oktntko/curcur40/docs/assets/inertia_wheel_height_comparison.png

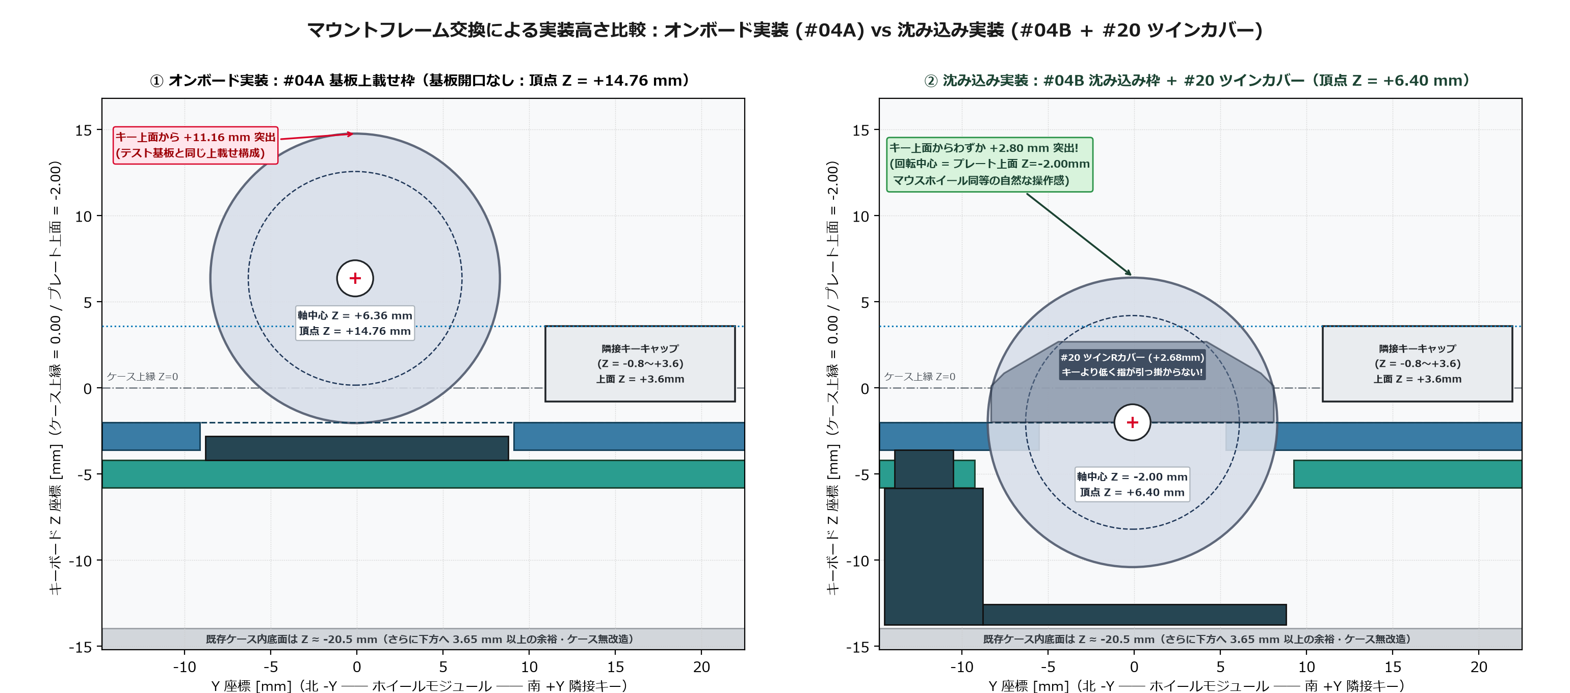
docs/assets/inertia_wheel_height_comparison.png
