oktntko/curcur40/docs/assets/render_carrying_frame_iso.png

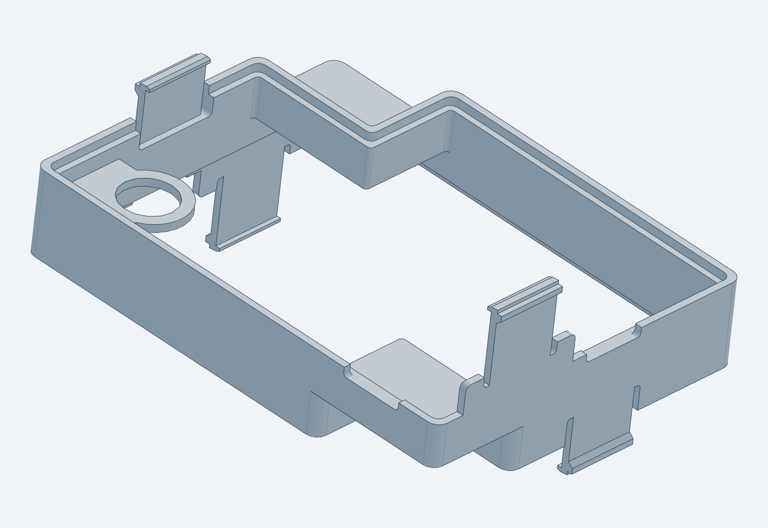
docs/assets/render_carrying_frame_iso.png
