oktntko/curcur40/docs/assets/render_curcur40_right_inertia_wheel.png

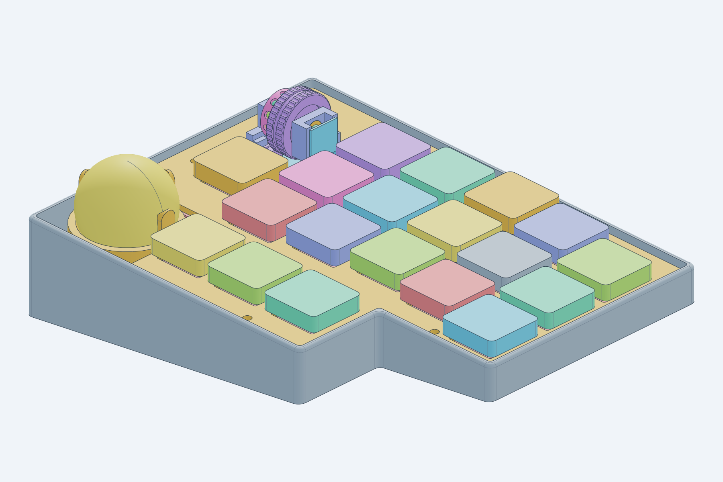
docs/assets/render_curcur40_right_inertia_wheel.png
