oktntko/curcur40/docs/assets/render_inertia_wheel_eval_pod_covered.png

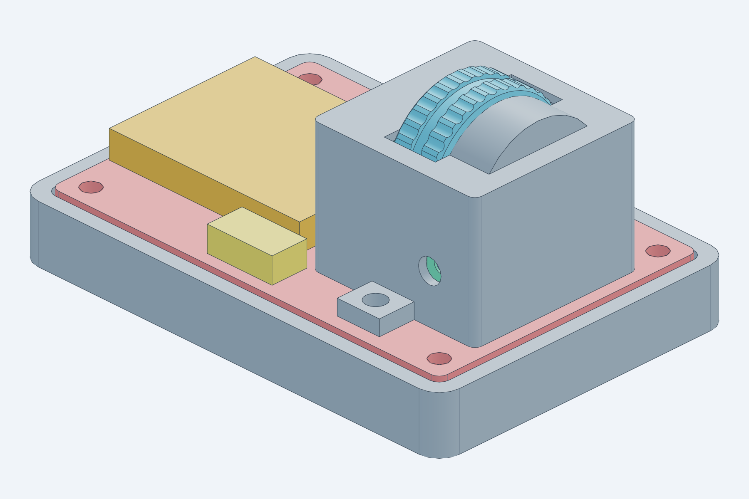
docs/assets/render_inertia_wheel_eval_pod_covered.png
