oktntko/curcur40/docs/assets/render_pcb_wheel_eval.png

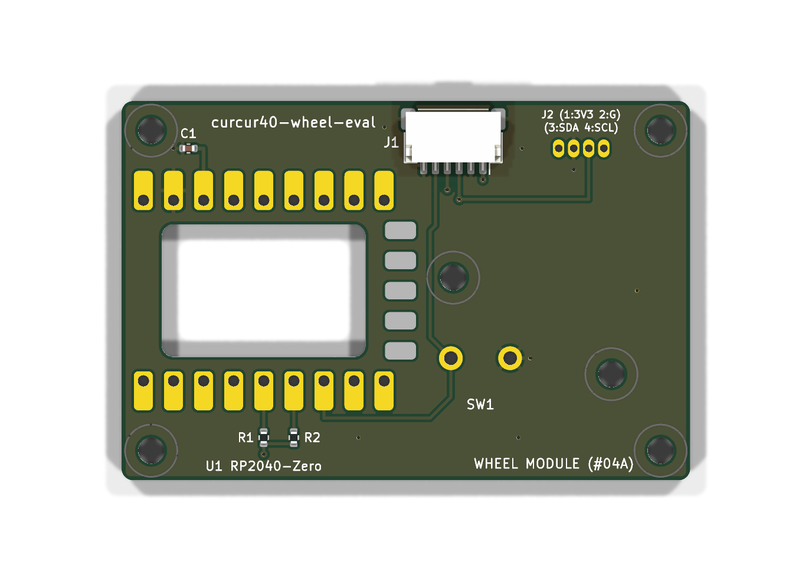
docs/assets/render_pcb_wheel_eval.png
