oktntko/curcur40/scratch/left_render.png

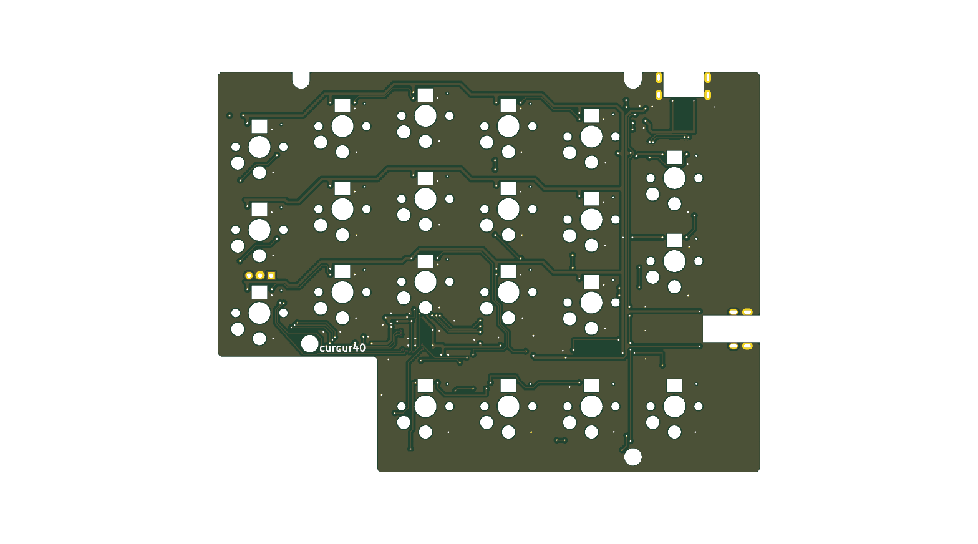
scratch/left_render.png
