oktntko/curcur40/scratch/right_render_fixed_final.png

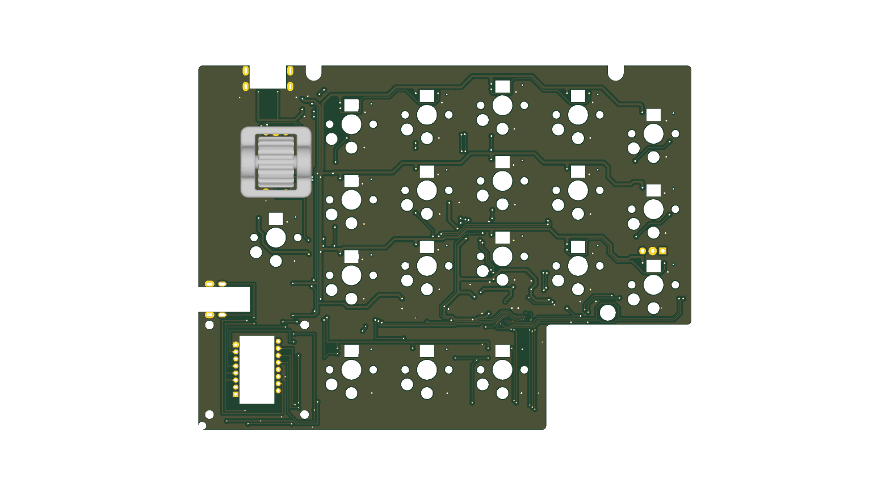
scratch/right_render_fixed_final.png
