oktntko/curcur40/scratch/user_img_grid.png

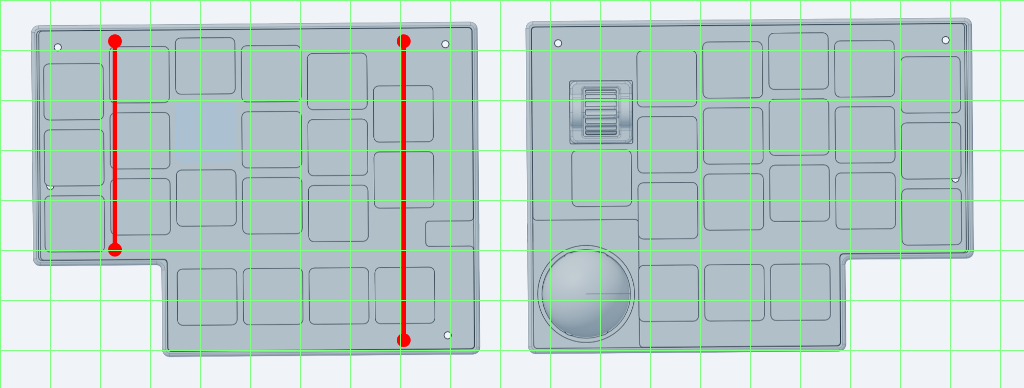
scratch/user_img_grid.png
