oktntko/curcur40/tmp/trackball-sensor-datasheet-review.png

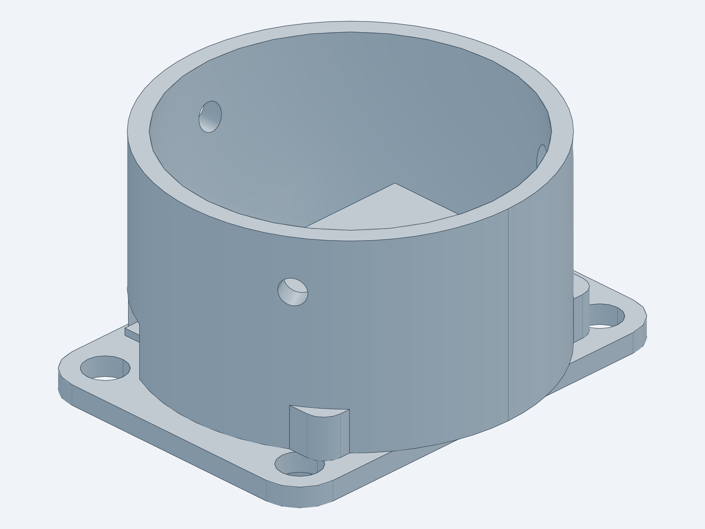
tmp/trackball-sensor-datasheet-review.png
