oktntko/curcur40/tmp/trackball-sensor-datasheet-xray.png

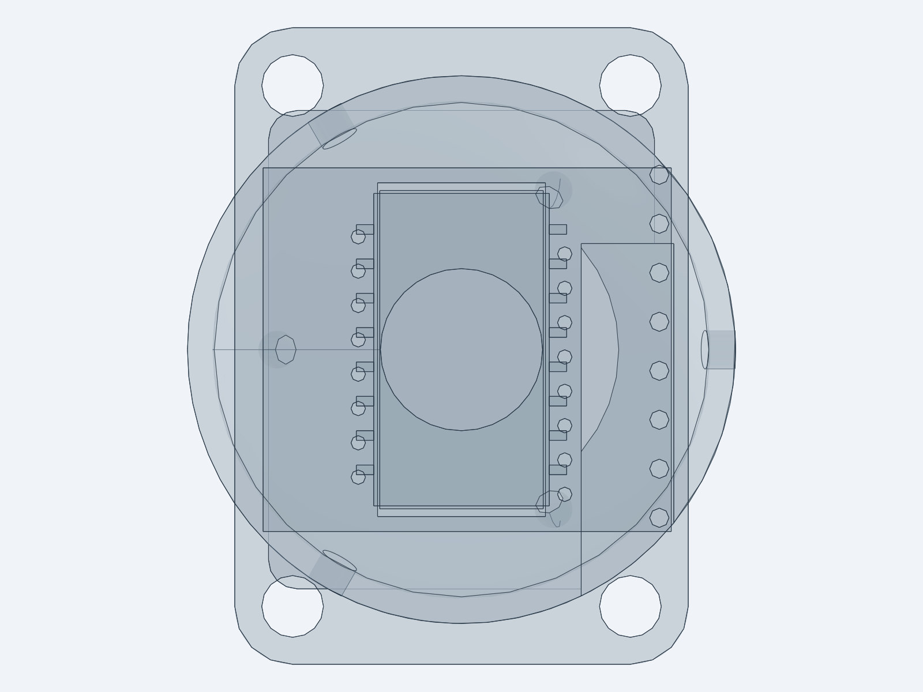
tmp/trackball-sensor-datasheet-xray.png
