oktntko/curcur40/docs/parts_spec.md

# curcur40 購入部材・製造委託パーツリファレンス (`parts_spec.md`)

本ドキュメントは、**アンダープレート一体軸パッシブ磁気慣性ホイール（幅 $6.50\,\text{mm}$ 大慣性モデル）** および **キーボード全体のコンパクト $\varnothing 5.20\,\text{mm}$ フラットボス＋真鍮ヒートセットインサート＋`M2 × 6.0mm` 統一締結構造（スイッチ嵌合プレート保持＝案1A）**で使用する市販購入パーツ・製造委託パーツの型番・仕様・入手先 URL をまとめたリファレンスです。

> [!TIP]
> **第一原理見直しによる部品点数・調達の大幅簡素化**
> - **廃止された旧部材（購入不要）**: `M2 5.5mm` スペーサー、`M2 × 4.0mm` 両面ネジ、内輪シムリング（`BRS002003020` / `030`）、1.5mm厚オープンベアリング（`DDL-520`）、`SUJ2` 鋼球（9個）、`SUS303` 平行ピン（`2×10mm`, `2×16mm`）、ステンレスホーローセット（`DIN916`）、ホイールセンサーサブ基板、SH 1.0mm 6P ホイール手配線ケーブル、単体評価用 `RP2040-Zero`、接着剤。
> - **統一された締結部材**: キーボード全体のキー谷間 12箇所（左右完全対称 `L1`〜`L6` / `R1`〜`R6`：すべて均一な天面 $Z = -5.80\,\text{mm}$・外径 $\varnothing 5.20\,\text{mm}$ フラット円筒ボス）＋トラックボールカップ 4箇所＋ホイールクレードル 2箇所＋ホイール磁気デテント調整 1箇所 ＝ **全 19箇所すべてが同一の「真鍮ヒートセットインサート `M2 × L=3.0 × OD=3.2mm`（19個）」＋「`M2 × 6.0mm` 精密ネジ（19本）」** に統一されています。

---

## 1. 市販購入パーツ（通販：モノタロウ・二六製作所・Amazon・AliExpress 等）

### 1-1. ミニチュアベアリング：`NMB DDL-520ZZ`（必要数：2個）
- **メーカー / 品番**: NMB（ミネベアミツミ） `DDL-520ZZ`（薄型両シールドラジアル玉軸受・ステンレス）
- **寸法**: 内径 $d = \varnothing 2.0\,\text{mm}$ × 外径 $D = \varnothing 5.0\,\text{mm}$ × **幅 $B = 2.3\,\text{mm}$（標準シールド厚）**
- **販売元**: [モノタロウ（注文コード：`09538365`）](https://www.monotaro.com/p/0953/8365/) / Amazon・ラジコン模型店等でも広く流通
- **備考**:
  - 1ピース一体軸ホイール（`steel-flywheel.step`）側に $\varnothing 2.90\,\text{mm}$ の内輪段付き肩が一体加工されており、`wheel-rocker.step` 側の **Cクリップスナップ軸受座（上開口 $4.56\,\text{mm}$）** へ上からパチンと押し込むだけで上抜けも完全防止されるため、**別体の内輪シムリングや押さえ蓋は一切不要**です。
  - フリースピン性能を最大化するため、組付け前にパーツクリーナー（ブレーキクリーナー）または無水エタノールへ浸漬して内部グリスを脱脂・乾燥させてから使用します（両シールド `ZZ` のまま液に浸けて軽く回すだけで簡単に脱脂でき、ホコリ侵入も防げます）。

### 1-2. 静音ミドルクリックスイッチ：`Kailh Square Silent Micro Switch`（必要数：1個）
- **品番 / 仕様**: `Kailh Square Silent Micro Switch`（$6.2 \times 6.2 \times 4.3\,\text{mm}$、2ピン角形静音マイクロスイッチ Red Dot）
- **販売元**: [Amazon (`B0FF9Y9DB8`)](https://www.amazon.co.jp/dp/B0FF9Y9DB8) / AliExpress
- **実装方法**: 右メイン基板 `curcur40-right` 裏面（`B.Cu`）の `rEXSW1` へ差し込み、表面（`F.Cu`）側から 2箇所はんだ付けしたあと、`F.Cu` 側へ飛び出したピン先端をニッパーで平切り（フラッシュカット）します（手配線ケーブル不要）。

### 1-3. 角度検出用ネオジム磁石：`D4×1mm` 径方向2極着磁（必要数：1個）
- **仕様**: **径方向2極着磁（Diametric Magnetization）** 円盤型ネオジム磁石、直径 $\varnothing 4.0\,\text{mm}$ × 厚さ $1.0\,\text{mm}$
- **販売元**: [AliExpress（径方向着磁 D4×1mm）](https://ja.aliexpress.com/item/1005010201889003.html)
- **備考**:
  - **必ず円盤の直径方向（左右）に N 極 / S 極が分かれた「径方向着磁（Diametric）」品**を選んでください（一般的な厚み方向着磁では回転角を検出できません）。
  - `magnet-holder.step`（`#02`）の西側ポケット（$\varnothing 4.04 \times 1.05\,\text{mm}$）へ入れるだけで、東側は鋼製Dカット軸端面、西側は `wheel-rocker.step`（`#03`）の一体キーパータブにより機械的に抜け止めされるため、**接着剤は不要**です。

### 1-4. 磁気デテント調整用ネオジム磁石：`Ø2.0×2.0mm` 軸方向着磁（必要数：1個）
- **メーカー / 代表型番**: 二六製作所 **`NE280`**（丸型ネオジム磁石 $\varnothing 2.0 \times 2.0\,\text{mm}$, N52 / Niメッキ）または同寸の標準軸方向着磁ネオジム磁石（N35〜N52）
- **寸法**: 直径 $D = \varnothing 2.00\,\text{mm}$（$\pm 0.10\,\text{mm}$） × 長さ（厚み） $t = 2.00\,\text{mm}$（$\pm 0.10\,\text{mm}$）
- **着磁方向**: 厚み（軸）方向着磁（ごく一般的な円柱ネオジム磁石）
- **販売元**: [二六製作所 `NE280`](https://www.26magnet.co.jp/26shop/goods/NE280) / モノタロウ / Amazon / AliExpress
- **備考**:
  - 磁性鋼（鉄・ニッケルメッキ等）製の `M2 × 6.0mm` ネジの先端へ**磁力でパチンと自己吸着**させてロッカー南ボスへねじ込むため、**接着剤は一切不要**です。
  - 強磁性 45#鋼ホイールの外周 24溝との距離をネジの回転角で微調整することで、完全フリースピン（無抵抗慣性回転）から明快な 24ノッチラチェット感まで好みに合わせて無段階調整できます。

### 1-5. 真鍮ヒートセットインサート：`M2 × L=3.0 × OD=3.2mm`（必要数：19個）
- **仕様**: 熱圧入式ローレット真鍮インサートナット
  - ネジ径：**M2**（ピッチ $0.4\,\text{mm}$）
  - 長さ（高さ $L$）：**$3.0\,\text{mm}$**
  - 外径（$OD$）：**$\varnothing 3.2\,\text{mm}$**（3Dプリント側の下穴設計径：$\varnothing 2.85\,\text{mm}$）
- **使用箇所内訳（計 19個）**:
  - 左ケース キー谷間ボス `L1`〜`L6`：6個（全箇所とも段差ゼロの $\varnothing 5.20\,\text{mm}$ フラット円筒ボス上面 $Z = -5.80\,\text{mm}$・片側均一肉厚 $1.175\,\text{mm}$ へそのままツライチ熱圧入！）
  - 右ケース キー谷間ボス `R1`〜`R6`：6個（左 `L1`〜`L6` と完全左右対称・段差ゼロの $\varnothing 5.20\,\text{mm}$ フラット円筒ボス上面 $Z = -5.80\,\text{mm}$・片側均一肉厚 $1.175\,\text{mm}$）
  - 右ケーストラックボールカップ固定ボス `TB1`〜`TB4`：4個（ボス上面 $Z = -17.60\,\text{mm}$・外径 $\varnothing 6.00\,\text{mm}$）
  - ホイールクレードル `WC1`, `WC2`：2個
  - ホイールロッカー南ラチェット調整ボス：1個
- **販売元**: Amazon / AliExpress 等で「`インサートナット 真鍮 M2 3mm 3.2mm`」として 50〜100個入りパックが安価に入手可能
- **圧入方法**: 温度調整機能付きの普通のはんだごて（設定目安 **$220 \sim 250\,^\circ\text{C}$**、専用チップ不要・標準の円錐こて先で OK）をインサート穴に軽く当て、3Dプリント部品の下穴へ垂直にツライチまで押し込んで 10秒冷ますだけで強固に固定されます。

### 1-6. 統一精密小ネジ：`M2 × 6.0mm`（必要数：19本）
- **仕様**: M2 × 首下長さ **$6.0\,\text{mm}$** なべ小ネジ または 低頭精密小ネジ（頭径 $\varnothing 3.5 \sim 4.0\,\text{mm}$、頭厚 $\le 1.3\,\text{mm}$）
- **材質**: **鉄（三価クロメート / ニッケルメッキ / 黒染め等の強磁性鋼）推奨**
  - ※ホイールロッカー南ボスの磁気デテント調整ネジ 1本は、先端に $\varnothing 2.0 \times 2.0\,\text{mm}$ ネオジム磁石を磁力で自己吸着させるため、**必ず磁石がくっつく鉄・鋼製ネジ**を使用してください（非磁性の SUS304 ステンレスネジには磁石が吸着しません。19本すべて鉄・ニッケルメッキ精密ネジに揃えると管理が最も簡単です）。
- **使用箇所内訳（計 19本すべて同一サイズ）**:
  - 左右メイン基板 キー谷間固定（`L1`〜`L6` および `R1`〜`R6`）：12本（トッププレート $\varnothing 4.40\,\text{mm}$ ネジ頭逃げ穴の奥でメイン基板 `F.Cu` を直接クランプ。ネジ頭はプレート下に沈み込むためキー押下時干渉ゼロ、プレートはキースイッチ嵌合で保持）
  - トラックボールカップ＆センサー基板共締め（`TB1`〜`TB4`）：4本
  - ホイールクレードル固定（`WC1, WC2`）：2本（トッププレート $\varnothing 4.40\,\text{mm}$ 頭逃げ穴の奥でメイン基板 `F.Cu` とクレードルを締結）
  - ホイール磁気デテントギャップ調整（ロッカー南ボス）：1本
- **販売元**: モノタロウ / Amazon / ホームセンター / 秋月電子・遊舎工房等

### 1-7. トラックボール関連市販部材（右手用）
- **25mm 交換用トラックボール球**（1個）：Perixx `PERIPRO-303`（25mm 艶あり赤 / 緑 / 黄 等、Amazon 等で購入可能）
- **$\varnothing 2.0\,\text{mm}$ セラミックボール（$\text{ZrO}_2$ 酸化ジルコニウム G5 等級）**（3個）：トラックボールカップ支持球用（UXCELL / Amazon / AliExpress 等）
- **光学センサー `PMW3360DM-T2QU` ＋ 純正レンズ `LM19-LSI` セット**（1セット）：AliExpress / 遊舎工房等
  - **公式データシート（PixArt Imaging Inc.）**: https://www.pixart.com/_getfs.php?tb=product&id=10&fs=ck2_fs_en （製品ページ：https://www.pixart.com/products-detail/10/PMW3360DM-T2QU ）
  - ※データシート PDF は無断転載禁止のためリポジトリへコミットせず、AI エージェントや設計確認時は上記 PixArt 公式ダウンロード URL から直接参照してください。
- **JST SH 1.0mm ピッチ 6ピン 両端ハーネス（`SHR-06V-S-B` ハウジング・両端同方向フラット結線、長さ `100mm`）**（1本）：右メイン基板 `rJ3` ⇔ トラックボールセンサー基板 `J1` 接続用（[スイッチサイエンス `#9142`（Pimoroni JST-SH 6P 100mm）](https://www.switch-science.com/products/9142?variant=42749692149958) 等で既製品購入可・圧着作業不要。組み込み時は余長ループを南東側の `rSW8`/`rSW9` 下の広い空間へ寄せてカプトンテープ等で軽く留め、北側の回転ホイールから離します）

### 1-8. キースイッチ・キーキャップ（Kailh Choc V2 専用）
- **キースイッチ：`Kailh Choc V2`（`CPG1353` シリーズ）**（必要数：40個＝左21個＋右19個）
- **キーキャップ：Choc V2 対応（MX 十字ステム）ロープロファイル 1u キーキャップ（外寸 $18.5 \times 18.5\,\text{mm}$ 以下）**（必要数：40個）
  - ※一般的な背の高い Cherry / OEM プロファイル等の通常 MX キーキャップは底打ち時にスカートがプレート・スイッチハウジングに干渉するため、必ずロープロファイル用 MX 十字ステム 1u キーキャップを使用してください。

---

## 2. オンデマンド製造委託パーツ（JLCCNC / JLC3DP / JLCPCB）

### 2-1. CNC 金属切削（JLCCNC）：1種
| ファイルパス | 材質 | 表面処理 | 数量 | 役割・仕様 |
| :--- | :--- | :--- | :---: | :--- |
| [`cases/inertia_wheel/steel-flywheel.step`](../cases/inertia_wheel/steel-flywheel.step) | **`45# Steel`**（S45C 炭素鋼・強磁性） | **`Electroless Nickel Plating`**（無電解ニッケルめっき・防錆） | 1 | 外径 $\varnothing 22.00 \times$ **幅 $6.50\,\text{mm}$**・外周24溝・一体段付き肩（$\varnothing 2.90\,\text{mm}$）・一体 $\varnothing 1.98\,\text{mm}$ 軸＆西Dカット軸（質量 **$19.31\,\text{g}$**、$J \approx 1160\,\text{g}\cdot\text{mm}^2$） |

> [!IMPORTANT]
> ホイールの外周24溝で磁気デテント（ノッチ感）を発生させるため、材質は必ず強磁性の **`45# Steel`（S45C 炭素鋼）** を選択してください（アルミや SUS304 オーステナイトステンレスは非磁性のため磁気デテントが働きません）。また炭素鋼の防錆と滑らかな触感のため、表面処理で **無電解ニッケルめっき（Electroless Nickel Plating）** を指定することを推奨します。

### 2-2. 3D プリント造形（JLC3DP）：必須 6種（＋持ち運び用オプション 2種）
すべてのヒートセットインサート圧入部（下穴 $\varnothing 2.85\,\text{mm}$）の耐熱性・靭性・寸法精度およびスナップラッチの弾性を両立するため、**MJF（`PA12-HP Nylon`）または SLS（`PA12` / `PA11` ナイロン）** を推奨します。

| ファイルパス | 推奨方式・材質 | 数量 | 役割・仕様 |
| :--- | :--- | :---: | :--- |
| [`cases/left-desk.step`](../cases/left-desk.step) | MJF / SLS `PA12` | 1 | 左手 100% 密閉・底面穴なしテンティングボトムケース（キー谷間6箇所 $\varnothing 5.20\,\text{mm}$ フラット円筒ボス＋USB-C内壁受け棚3箇所） |
| [`cases/right-desk.step`](../cases/right-desk.step) | MJF / SLS `PA12` | 1 | 右手 100% 密閉・底面穴なしテンティングボトムケース（キー谷間6箇所 $\varnothing 5.20\,\text{mm}$ フラット円筒ボス＋カップボス4箇所＋USB-C内壁受け棚3箇所） |
| [`cases/trackball-cup.step`](../cases/trackball-cup.step) | MJF / SLS `PA12` | 1 | 25mm トラックボールカップ（高さ $2.0\,\text{mm}$ フラット固定耳・$\varnothing 2.4\,\text{mm}$ 直穴×4） |
| [`cases/inertia_wheel/magnet-holder.step`](../cases/inertia_wheel/magnet-holder.step) | MJF / SLS `PA12` | 1 | `D4×1mm` 磁石接着レス保持キャップ（東側 $\varnothing 2.00\,\text{mm}$ D穴圧入、$\varnothing 5.72 \times 2.05\,\text{mm}$） |
| [`cases/inertia_wheel/wheel-rocker.step`](../cases/inertia_wheel/wheel-rocker.step) | MJF / SLS `PA12` | 1 | ホイール軸受シーソーロッカー（Cクリップ軸受座・一体 $\varnothing 3.0\,\text{mm}$ 支点軸・西キーパータブ・南ラチェットボス） |
| [`cases/inertia_wheel/wheel-cradle.step`](../cases/inertia_wheel/wheel-cradle.step) | MJF / SLS `PA12` | 1 | 右メイン基板裏面固定クレードル（`WC1`/`WC2` インサート下穴×2・$\varnothing 3.06\,\text{mm}$ Cクリップ軸受連結） |
| [`cases/carrying-box.step`](../cases/carrying-box.step) | MJF / SLS `PA12` | 1（任意） | **【オプション】持ち運び用 上下リバーシブル完全90°直方体・スライド差し込みボックス本体**（`carrying-box-lid.step` とセット使用。右手トラックボール側が下でも上でもスッと入る $Y$ 軸 $180^\circ$ 点対称直方体、奥面貫通穴ゼロのデュアル内部堀＋手前ストッパー段差、クランク段差デュアル TB キーパー、外寸 $142.40 \times 105.20 \times 65.42\,\text{mm}$・体積 $204.96\,\text{cm}^3$） |
| [`cases/carrying-box-lid.step`](../cases/carrying-box-lid.step) | MJF / SLS `PA12` | 1（任意） | **【オプション】スライドボックス用 上下リバーシブル・穴なし計算済みスナップキャップフタ**（`carrying-box.step` とセット使用。上下向き区別なし、長スパン $14.0\,\text{mm}$・抜き角 $26^\circ$ 弾性爪により引き抜き力 約 $9.7\,\text{N}$ でスムーズ開閉、外正面貫通穴ゼロ・デュアル内部堀付き、装着時総外寸 $142.40 \times 111.85 \times 65.42\,\text{mm}$、単体造形サイズ $142.40 \times 65.42 \times 24.15\,\text{mm}$・体積 $60.69\,\text{cm}^3$） |

### 2-3. 基板製造・PCBA 実装（JLCPCB）：計 5種（すべて板厚 `1.6mm` 標準 FR-4）
- **PCBA 実装基板（3種）**: `curcur40-left`, `curcur40-right`（裏面 `B.Cu` に 3D ホールセンサー `rU6: TMAG5273A1QDBVR` LCSC `C3716049` 自動実装済み！）, `curcur40-pmw3360`
- **FR-4 トッププレート（2種・PCB 単体製造）**: `plate-top-left`, `plate-top-right`（全14箇所のネジ位置は $\varnothing 4.40\,\text{mm}$ ネジ頭逃げ穴とし、Choc V2 キースイッチ嵌合でスマートに保持）
