oktntko/curcur40/pcbs/pmw3360/jlcpcb/production_files/BOM-curcur40-pmw3360.csv

Comment | Designator | Footprint | LCSC
100nF | C2 | C_0603_1608Metric | C14663
1uF | C3,C4 | C_0603_1608Metric | C15849
SM06B-SRSS-TB(LF)(SN) | J1 | JST_SH_SM06B-SRSS-TB_1x06-1MP_P1.00mm_Horizontal | C160405
4.7uF/10V | C1 | C_0603_1608Metric | C19666
39R | R3 | R_0603_1608Metric | C23154
10k | R1,R2 | R_0603_1608Metric | C25804
TLV74318PDBVR | U2 | SOT-23-5 | C485152
