oktntko/curcur40/pcbs/right/jlcpcb/production_files/BOM-curcur40-right.csv

Comment | Designator | Footprint | LCSC
W25Q128JVSIQ | rU4 | SOIC-8_5.3x5.3mm_P1.27mm | C113767
1k | rR3,rR6 | R_0402_1005Metric | C11702
TPD4E05U06DQAR | rU3,rU5 | USON-10_2.5x1.0mm_P0.5mm | C138714
RB521S30T1G | rZD1 | D_SOD-523 | C145179
NCP1117LPST33T3G | rU2 | SOT-223-3_TabPin2 | C146799
100n | rC10,rC12,rC13,rC14,rC15,rC17,rC18,rC3,rC4,rC7,rC9 | C_0402_1005Metric | C1525
10u | rC11,rC6 | C_0402_1005Metric | C15525
27p | rC1,rC2 | C_0402_1005Metric | C1557
SM06B-SRSS-TB(LF)(SN) | rJ3 | JST_SH_SM06B-SRSS-TB_1x06-1MP_P1.00mm_Horizontal | C160405
0 | rR13 | R_0402_1005Metric | C17168
RP2040 | rU1 | QFN-56-1EP_7x7mm_P0.4mm_EP3.2x3.2mm | C2040
1N4148WT | rD1 | D_SOD-523 | C232841
10k | rR7,rR9 | R_0402_1005Metric | C25744
4.7k | rR11,rR12 | R_0402_1005Metric | C25900
5.1k | rR1,rR2 | R_0402_1005Metric | C25905
5.6k | rR8 | R_0402_1005Metric | C25908
TYPE-C-31-M-13C | rJ1,rJ2 | TYPE-C-31-M-13C | C2848620
27 | rR10,rR4,rR5 | R_0402_1005Metric | C2909343
TMAG5273A1QDBVR | rU6 | SOT-23-6 | C3716049
TS-1088R-02026 | rSMDSW1,rSMDSW2 | TS-1088R-02026 | C455280
YS-SK6812MINI-E | rEXLED2,rLED1,rLED10,rLED11,rLED12,rLED13,rLED14,rLED15,rLED16,rLED17,rLED18,rLED2,rLED3,rLED4,rLED5,rLED6,rLED7,rLED8,rLED9 | YS-SK6812MINI-E | C5149201
1u | rC16,rC5,rC8 | C_0402_1005Metric | C52923
SW_Push | rEXSW2,rSW1,rSW10,rSW11,rSW12,rSW13,rSW14,rSW15,rSW16,rSW17,rSW18,rSW2,rSW3,rSW4,rSW5,rSW6,rSW7,rSW8,rSW9 | keyswitch_choc12_hotswap_1u | C5333465
12MHz 18pF | rY1 | Crystal_SMD_3225-4Pin_3.2x2.5mm | C91749
