oktntko/curcur40/pcbs/inertia-wheel-eval/jlcpcb/production_files/BOM-curcur40-wheel-eval.csv

Comment | Designator | Footprint | LCSC
100nF | C1 | C_0402_1005Metric | C1525
SM06B-SRSS-TB(LF)(SN) | J1 | JST_SH_SM06B-SRSS-TB_1x06-1MP_P1.00mm_Horizontal | C160405
4.7k | R1,R2 | R_0402_1005Metric | C25900
