oktntko/curcur40/cases/assemblies/assembly-full.step

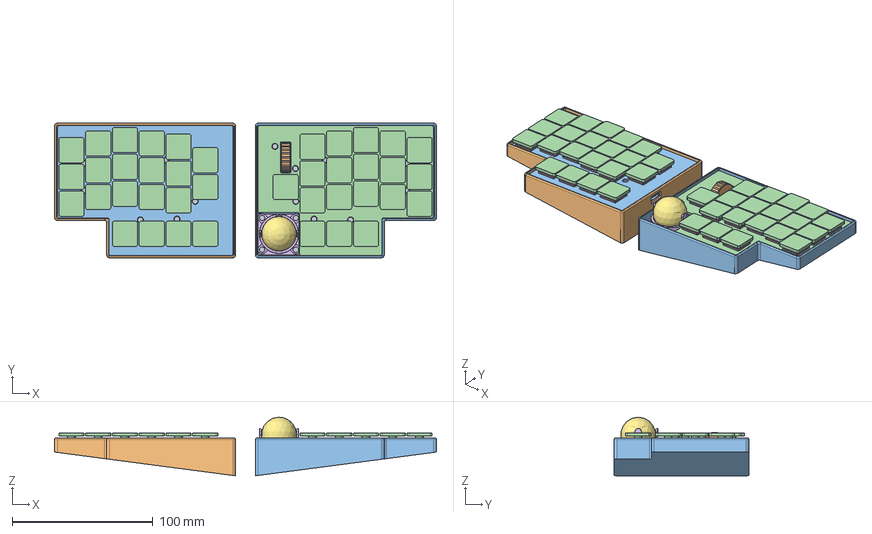
[picture p56: CAD file, 2026-11-05]
cases/assemblies/assembly-full.step
271.7 x 95.8 x 41.7 mm
Left_Case
Right_Case
Left_Main_PCB
Right_Main_PCB
PMW3360_Sensor_PCB
Left_PCB_3D_21 x 21
Left_PCB_3D_22
Left_PCB_3D_24 x 2
Left_PCB_3D_25
Left_PCB_3D_27 x 2
Left_PCB_3D_28
Left_PCB_3D_30 x 2
Left_PCB_3D_51 x 21
Left_PCB_3D_52
Left_PCB_3D_54 x 2
Left_PCB_3D_96 x 21
Left_PCB_3D_94 x 21
Left_PCB_3D_98 x 2
Left_PCB_3D_100 x 2
Left_PCB_3D_121 x 21
Left_PCB_3D_138 x 17
Left_PCB_3D_148 x 10
Left_PCB_3D_205 x 21
Left_PCB_3D_199 x 21
Left_PCB_3D_211 x 21
Left_PCB_3D_232 x 21
Left_PCB_3D_234 x 2
Left_PCB_3D_236 x 2
Left_PCB_3D_266 x 2
Left_PCB_3D_261 x 2
Left_PCB_3D_267 x 2
Left_PCB_3D_262 x 2
Left_PCB_3D_265 x 2
Left_PCB_3D_263 x 2
Left_PCB_3D_264 x 2
Left_PCB_3D_268 x 2
Left_PCB_3D_253 x 2
Left_PCB_3D_255 x 2
Left_PCB_3D_256 x 2
Left_PCB_3D_254 x 2
Left_PCB_3D_257 x 2
Left_PCB_3D_258 x 2
Left_PCB_3D_259 x 2
Left_PCB_3D_260 x 2
Right_PCB_3D_1
Right_PCB_3D_20 x 19
Right_PCB_rJ3_JST_SH_1
Right_PCB_3D_22
Right_PCB_3D_24 x 2
Right_PCB_3D_25
Right_PCB_3D_27 x 2
Right_PCB_3D_28
Right_PCB_3D_30 x 2
Right_PCB_3D_49 x 19
Right_PCB_3D_50
Right_PCB_rEXSW1_Plunger
Right_PCB_3D_52
Right_PCB_3D_54 x 2
Right_PCB_3D_91 x 19
Right_PCB_3D_92 x 19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
