oktntko/curcur40/cases/assemblies/carrying-box-assembly.step

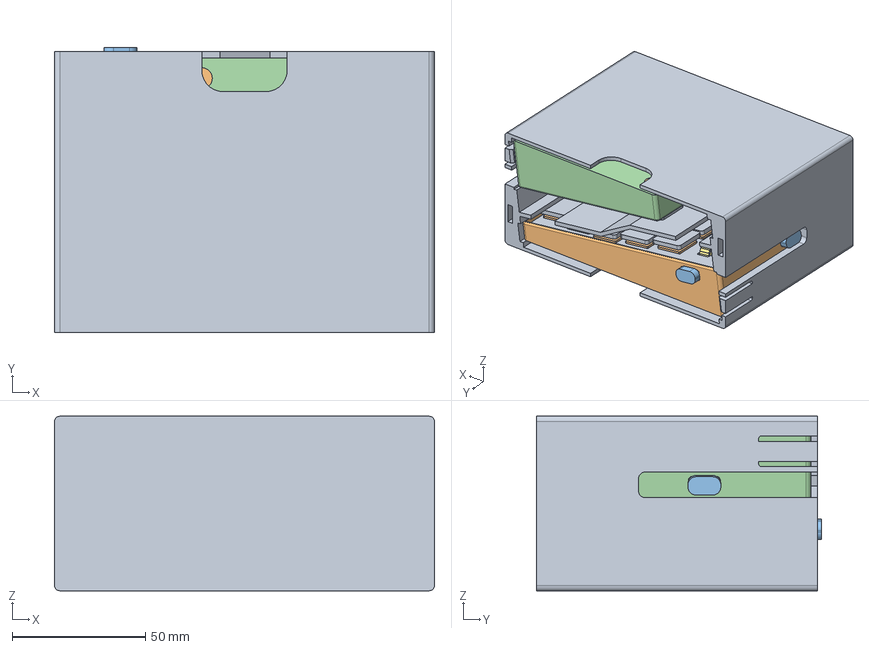
[picture p58: CAD file, 2026-11-05]
cases/assemblies/carrying-box-assembly.step
142.4 x 106.7 x 65.4 mm
Carrying_Box
Right_Rubber_Foot_1
Right_Rubber_Foot_2
Right_Rubber_Foot_3
Right_Rubber_Foot_4
Right_Rubber_Foot_5
Right_Host_USBC_CIO_Tip
Right_Split_USBC_CIO_Tip
Left_Rubber_Foot_1
Left_Rubber_Foot_2
Left_Rubber_Foot_3
Left_Rubber_Foot_4
Left_Rubber_Foot_5
Left_Host_USBC_CIO_Tip
Left_Split_USBC_CIO_Tip
