oktntko/curcur40/cases/assemblies/inertia-wheel-assembly.step

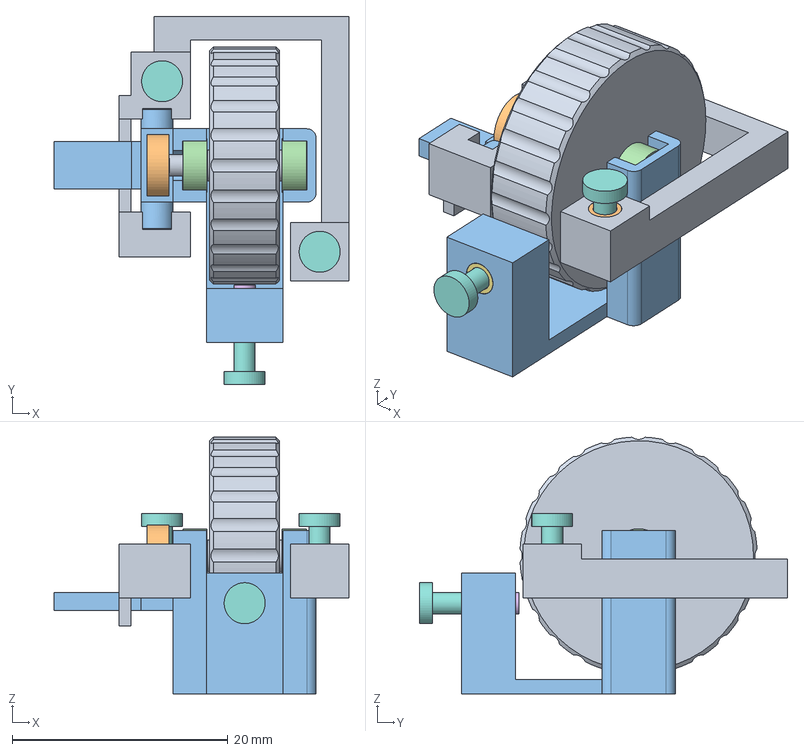
[picture p59: CAD file, 2026-11-05]
cases/assemblies/inertia-wheel-assembly.step
27.3 x 34.1 x 23.8 mm
Steel_Flywheel_22mm
Magnet_Holder_PA12
Wheel_Rocker_PA12
Bearing_DDL520ZZ_West
Bearing_DDL520ZZ_East
Magnet_D4x1mm_Diametric
Magnet_D2x2mm_Axial_Detent
HeatSet_Insert_M2_Detent
Screw_M2x6_Detent_Adjuster
Wheel_Cradle_PA12
HeatSet_Insert_M2_WC1
HeatSet_Insert_M2_WC2
Top_Screw_M2x6_WC1
Top_Screw_M2x6_WC2
