oktntko/curcur40/cases/assemblies/carrying-assembly.step

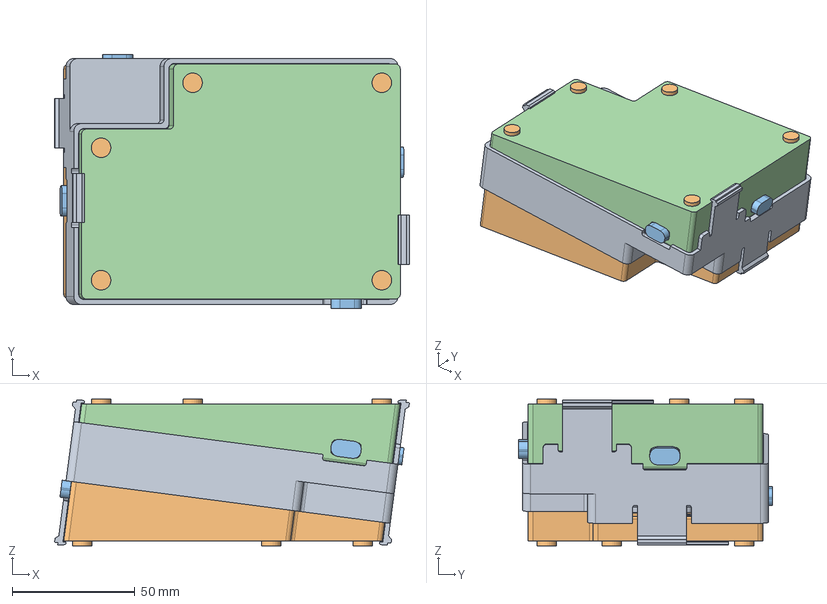
[picture p60: CAD file, 2026-11-04]
cases/assemblies/carrying-assembly.step
144.8 x 103.5 x 59.9 mm
Carrying_Frame
Right_Rubber_Foot_1
Right_Rubber_Foot_2
Right_Rubber_Foot_3
Right_Rubber_Foot_4
Right_Rubber_Foot_5
Right_Host_USBC_CIO_Tip
Right_Split_USBC_CIO_Tip
Left_Rubber_Foot_1
Left_Rubber_Foot_2
Left_Rubber_Foot_3
Left_Rubber_Foot_4
Left_Rubber_Foot_5
Left_Host_USBC_CIO_Tip
Left_Split_USBC_CIO_Tip
