oktntko/curcur40/cases/assemblies/curcur40-right-wheel-assembly.step

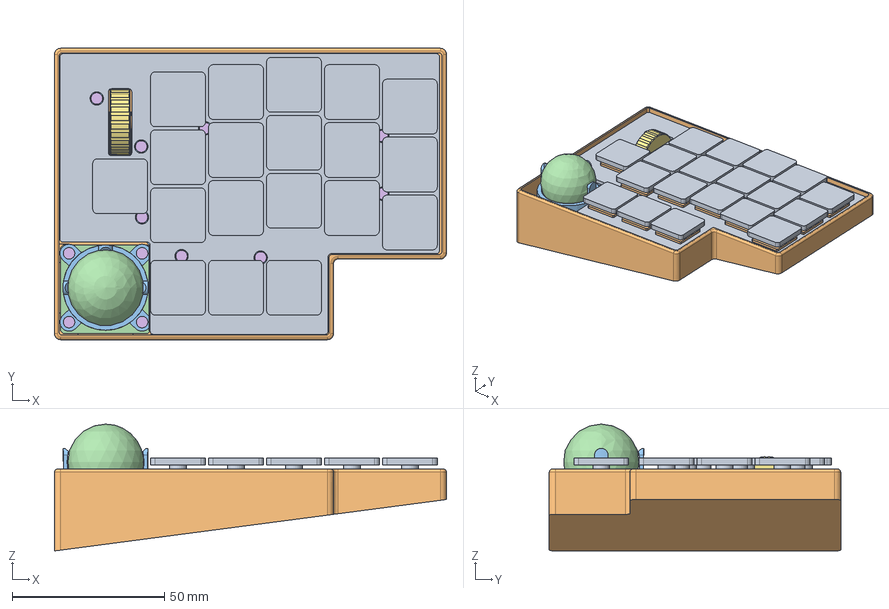
[picture p62: CAD file, 2026-11-03]
cases/assemblies/curcur40-right-wheel-assembly.step
128.8 x 95.8 x 41.7 mm
Right_Case
Right_Main_PCB
PMW3360_Sensor_PCB
Right_PCB_3D_1
Right_PCB_3D_20 x 19
Right_PCB_rJ3_JST_SH_1
Right_PCB_3D_22
Right_PCB_3D_24 x 2
Right_PCB_3D_25
Right_PCB_3D_27 x 2
Right_PCB_3D_28
Right_PCB_3D_30 x 2
Right_PCB_3D_49 x 19
Right_PCB_3D_50
Right_PCB_rEXSW1_Plunger
Right_PCB_3D_52
Right_PCB_3D_54 x 2
Right_PCB_3D_91 x 19
Right_PCB_3D_92 x 19
Right_PCB_3D_94 x 2
Right_PCB_3D_96 x 2
Right_PCB_3D_115 x 19
Right_PCB_3D_133 x 18
Right_PCB_3D_146 x 13
Right_PCB_3D_192 x 19
Right_PCB_3D_193 x 19
Right_PCB_3D_203 x 19
Right_PCB_3D_222 x 19
Right_PCB_3D_224 x 2
Right_PCB_3D_226 x 2
Right_PCB_3D_251 x 2
Right_PCB_3D_256 x 2
Right_PCB_3D_252 x 2
Right_PCB_3D_257 x 2
Right_PCB_3D_253 x 2
Right_PCB_3D_254 x 2
Right_PCB_3D_255 x 2
Right_PCB_3D_258 x 2
Right_PCB_3D_243 x 2
Right_PCB_3D_244 x 2
Right_PCB_3D_245 x 2
Right_PCB_3D_246 x 2
Right_PCB_3D_248 x 2
Right_PCB_3D_247 x 2
Right_PCB_3D_250 x 2
Right_PCB_3D_249 x 2
Sensor_PCB_J1_JST_SH_1
Sensor_PCB_3D_2
Sensor_PCB_3D_6 x 4
Sensor_PCB_3D_9 x 3
Sensor_PCB_J1_SHR06V_Plug
Right_PCB_rJ3_SHR06V_Plug
Right_Top_Plate
Right_ChocV2_Switch_19 x 19
Trackball_Cup
Trackball_25mm
LM19_Lens
PMW3360_Sensor
Lens_Optical_Ref_Point
Steel_Flywheel_22mm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
