oktntko/curcur40/cases/assemblies/pmw3360-lens-pcb-assembly.step

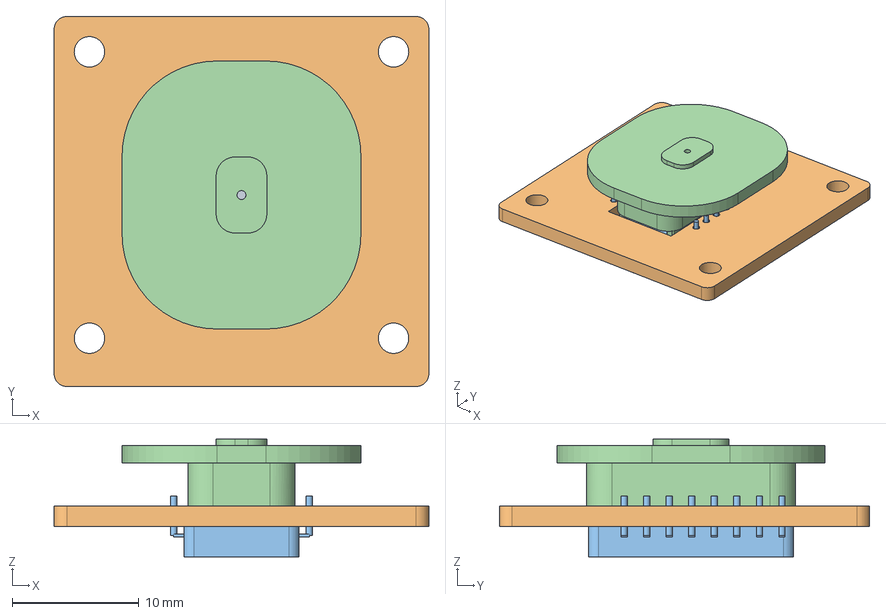
[picture p63: CAD file, 2026-10-31]
cases/assemblies/pmw3360-lens-pcb-assembly.step
29.6 x 29.2 x 9.31 mm
Customer_Supplied_PCB
PMW3360DM_T2QU_Sensor
LM19_LSI_Lens
Lens_Optical_Ref_Point
