oktntko/curcur40/cases/assembly-full-desk.step

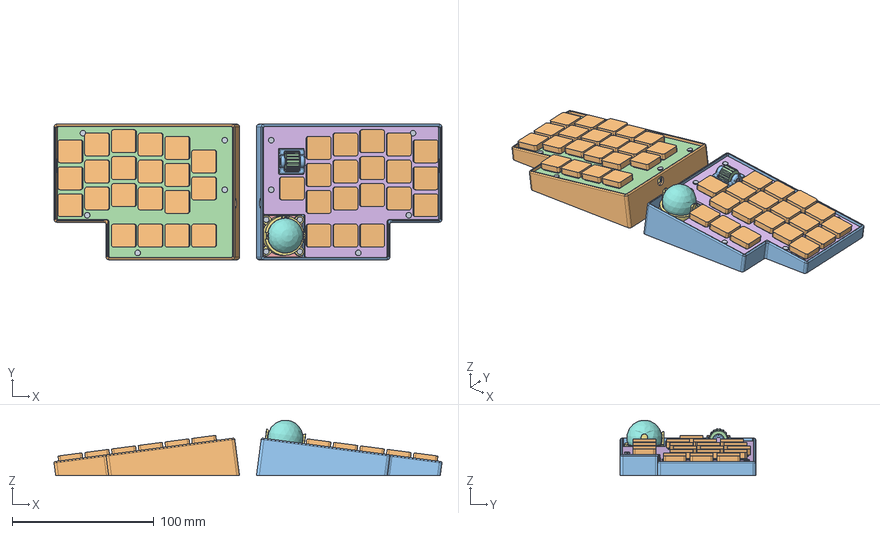
[picture p64: CAD file, 2026-10-24]
cases/assembly-full-desk.step
274.1 x 95.8 x 39.2 mm
Left_Case
Left_Main_PCB
Left_Top_Plate
Left_USBC_Shell
Left_USBC_Tongue
Left_TRRS_Jack
Standoff_L_Perim_1
Bottom_Screw_L_Perim_1
Top_Screw_L_Perim_1
Standoff_L_Perim_2
Bottom_Screw_L_Perim_2
Top_Screw_L_Perim_2
Standoff_L_Perim_3
Bottom_Screw_L_Perim_3
Top_Screw_L_Perim_3
Standoff_L_Perim_4
Bottom_Screw_L_Perim_4
Top_Screw_L_Perim_4
Standoff_L_Perim_5
Bottom_Screw_L_Perim_5
Top_Screw_L_Perim_5
Left_Keycap_1
Left_Keycap_2
Left_Keycap_3
Left_Keycap_4
Left_Keycap_5
Left_Keycap_6
Left_Keycap_7
Left_Keycap_8
Left_Keycap_9
Left_Keycap_10
Left_Keycap_11
Left_Keycap_12
Left_Keycap_13
Left_Keycap_14
Left_Keycap_15
Left_Keycap_16
Left_Keycap_17
Left_Keycap_18
Left_Keycap_19
Left_Keycap_20
Left_Keycap_21
Right_Case
Right_Main_PCB
PMW3360_Sensor_PCB
Right_Top_Plate
Trackball_Cup
Trackball_25mm
LM19_Lens
PMW3360_Sensor
Lens_Optical_Ref_Point
CKW12_Housing
CKW12_Wheel
CKW12_Stem_1
CKW12_Stem_2
CKW12_Stem_3
Right_USBC_Shell
Right_USBC_Tongue
Right_TRRS_Jack
Standoff_R_Perim_6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
