oktntko/curcur40/cases/assemblies/trackball-sensor-assembly.step

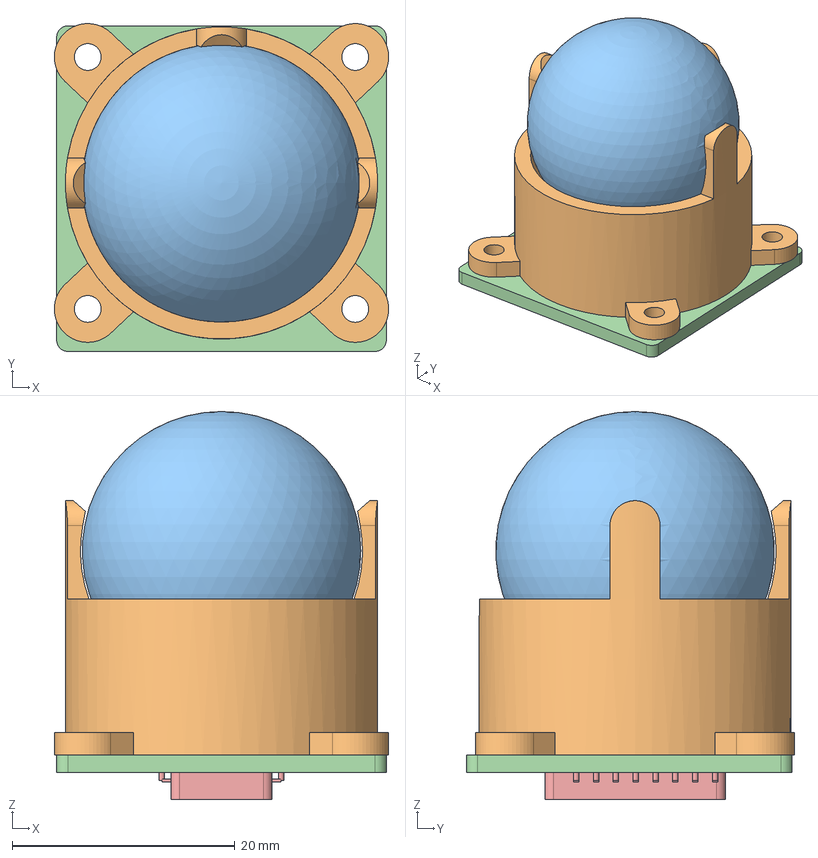
[picture p65: CAD file, 2026-10-31]
cases/assemblies/trackball-sensor-assembly.step
30.0 x 29.4 x 34.8 mm
Trackball_Cup
Trackball_25mm
Customer_Supplied_PCB
PMW3360DM_T2QU_Sensor
LM19_LSI_Lens
Lens_Optical_Ref_Point
