oktntko/curcur40/cases/assembly-full.step

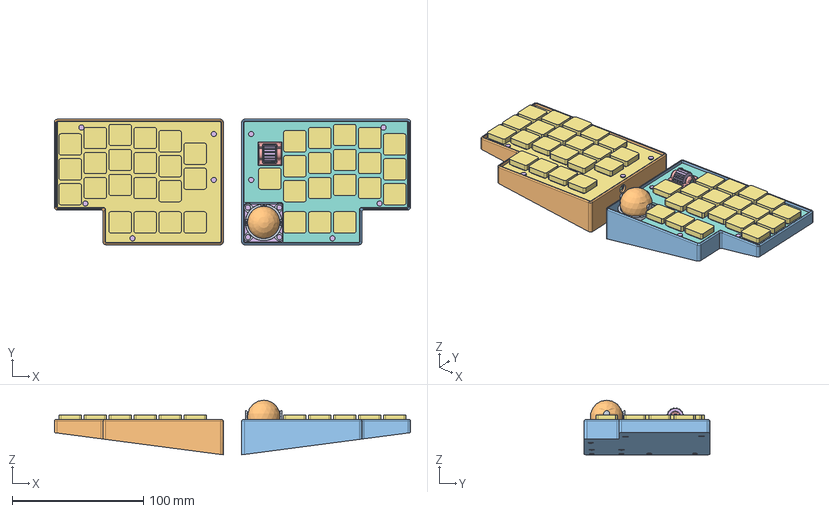
[picture p66: CAD file, 2026-10-24]
cases/assembly-full.step
271.7 x 95.8 x 41.7 mm
Left_Case
Right_Case
Left_Main_PCB
Right_Main_PCB
PMW3360_Sensor_PCB
Left_Top_Plate
Right_Top_Plate
Trackball_Cup
Trackball_25mm
LM19_Lens
PMW3360_Sensor
Lens_Optical_Ref_Point
CKW12_Housing
CKW12_Wheel
CKW12_Stem_1
CKW12_Stem_2
CKW12_Stem_3
Left_USBC_Shell
Left_USBC_Tongue
Left_TRRS_Jack
Right_USBC_Shell
Right_USBC_Tongue
Right_TRRS_Jack
Standoff_L_Perim_1
Standoff_L_Perim_2
Standoff_L_Perim_3
Standoff_L_Perim_4
Standoff_L_Perim_5
Standoff_R_Perim_6
Standoff_R_Perim_7
Standoff_R_Perim_8
Standoff_R_Perim_9
Standoff_R_Perim_10
Standoff_R_TB_11
Standoff_R_TB_12
Standoff_R_TB_13
Standoff_R_TB_14
Bottom_Screw_L_Perim_1
Bottom_Screw_L_Perim_2
Bottom_Screw_L_Perim_3
Bottom_Screw_L_Perim_4
Bottom_Screw_L_Perim_5
Bottom_Screw_R_Perim_6
Bottom_Screw_R_Perim_7
Bottom_Screw_R_Perim_8
Bottom_Screw_R_Perim_9
Bottom_Screw_R_Perim_10
Bottom_Screw_R_TB_11
Bottom_Screw_R_TB_12
Bottom_Screw_R_TB_13
Bottom_Screw_R_TB_14
Top_Screw_L_Perim_1
Top_Screw_L_Perim_2
Top_Screw_L_Perim_3
Top_Screw_L_Perim_4
Top_Screw_L_Perim_5
Top_Screw_R_Perim_6
Top_Screw_R_Perim_7
Top_Screw_R_Perim_8
Top_Screw_R_Perim_9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
