oktntko/curcur40/cases/assemblies/inertia-wheel-module-assembly.step

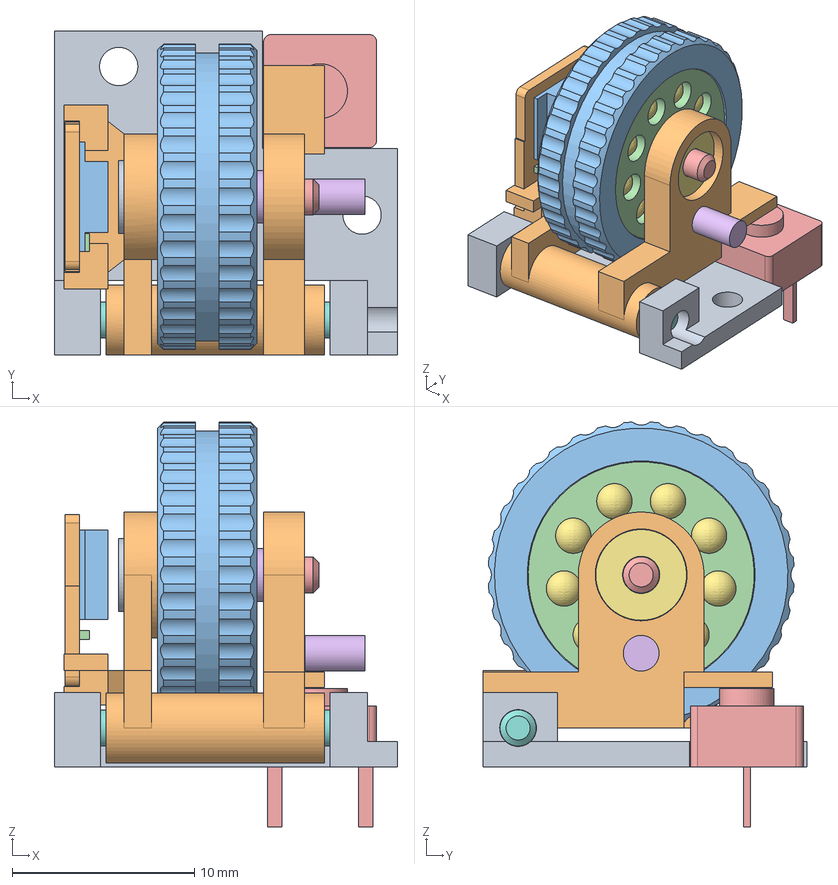
[picture p67: CAD file, 2026-10-31]
cases/assemblies/inertia-wheel-module-assembly.step
18.8 x 17.8 x 22.2 mm
Wheel_Base_Frame
Wheel_Hinged_Carriage
SUS304_Flywheel_Cup_16p8mm
Ratchet_Hub_Internal_Resin
SUS303_Axle_Shaft_2x10mm
SUS304_Inner_Race_Shim_M2x3x0p5
Bearing_DDL520_West
Bearing_DDL520_East
Hinge_Pin_SUS303_2x16mm
Diametric_Magnet_4x1mm
AS5600_Sensor_SubPCB
AS5600_SOIC8_IC
AS5600_Cap_C1_100nF
AS5600_Cap_C2_1uF
Kailh_Silent_Switch_6x6x4p3
M2_Magnet_Adjuster_And_NdFeB
Steel_Ball_2mm_01
Steel_Ball_2mm_02
Steel_Ball_2mm_03
Steel_Ball_2mm_04
Steel_Ball_2mm_05
Steel_Ball_2mm_06
Steel_Ball_2mm_07
Steel_Ball_2mm_08
Steel_Ball_2mm_09
