oktntko/curcur40/cases/assemblies/inertia-wheel-eval-pod-assembly.step

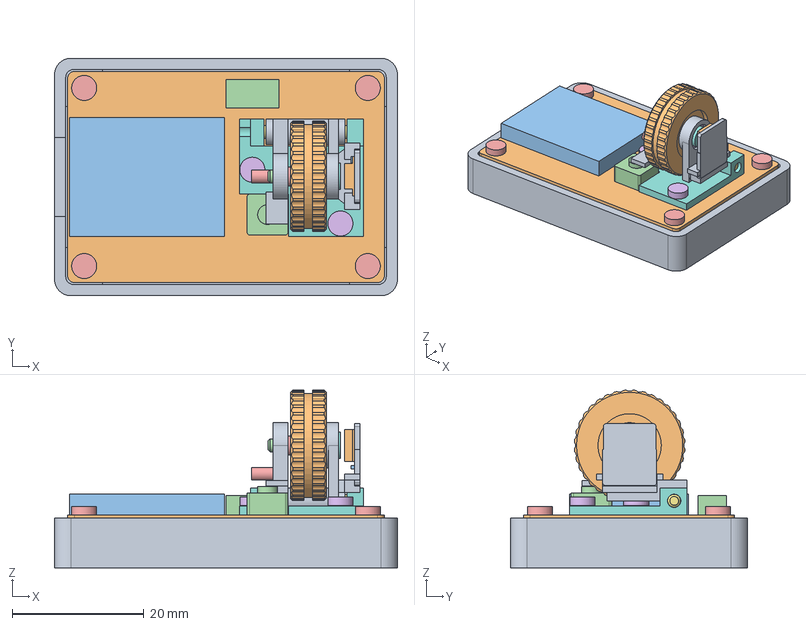
[picture p68: CAD file, 2026-10-31]
cases/assemblies/inertia-wheel-eval-pod-assembly.step
52.0 x 36.0 x 27.0 mm
Eval_Pod_Stand
Eval_Carrier_PCB_48x32
Waveshare_RP2040_Zero
JST_SH_6Pin_Header
Eval_Stand_Screw_M2x6_1
Eval_Stand_Screw_M2x6_2
Eval_Stand_Screw_M2x6_3
Eval_Stand_Screw_M2x6_4
Eval_Module_Screw_M2x6_1
Eval_Module_Nut_M2_1
Eval_Module_Screw_M2x6_2
Eval_Module_Nut_M2_2
Wheel_Base_Frame
Wheel_Hinged_Carriage
SUS304_Flywheel_Cup_16p8mm
Ratchet_Hub_Internal_Resin
SUS303_Axle_Shaft_2x10mm
SUS304_Inner_Race_Shim_M2x3x0p5
Bearing_DDL520_West
Bearing_DDL520_East
Hinge_Pin_SUS303_2x16mm
Diametric_Magnet_4x1mm
AS5600_Sensor_SubPCB
AS5600_SOIC8_IC
AS5600_Cap_C1_100nF
AS5600_Cap_C2_1uF
Kailh_Silent_Switch_6x6x4p3
M2_Magnet_Adjuster_And_NdFeB
Steel_Ball_2mm_01
Steel_Ball_2mm_02
Steel_Ball_2mm_03
Steel_Ball_2mm_04
Steel_Ball_2mm_05
Steel_Ball_2mm_06
Steel_Ball_2mm_07
Steel_Ball_2mm_08
Steel_Ball_2mm_09
