oktntko/curcur40/cases/inertia_wheel/wheel-rocker.step

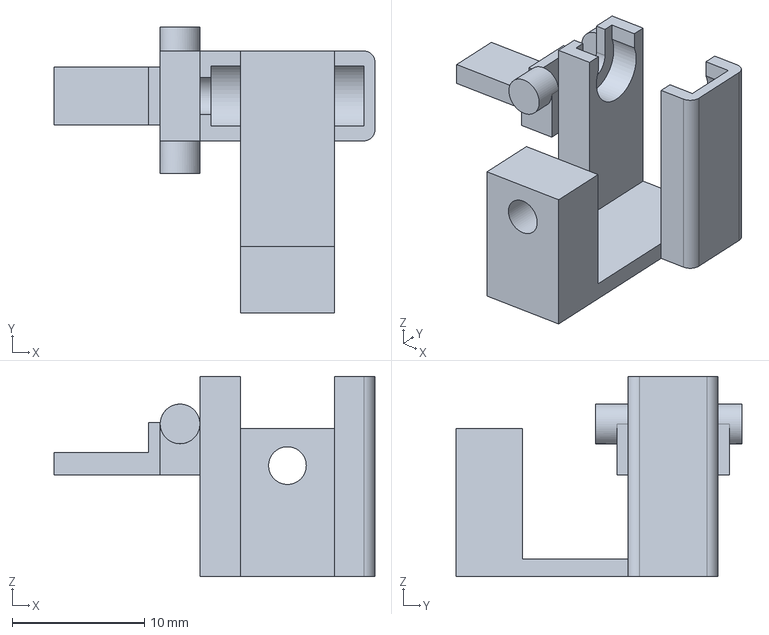
[picture p70: CAD file, 2026-11-05]
cases/inertia_wheel/wheel-rocker.step
24.3 x 21.6 x 15.2 mm
