oktntko/curcur40/cases/right-desk.step

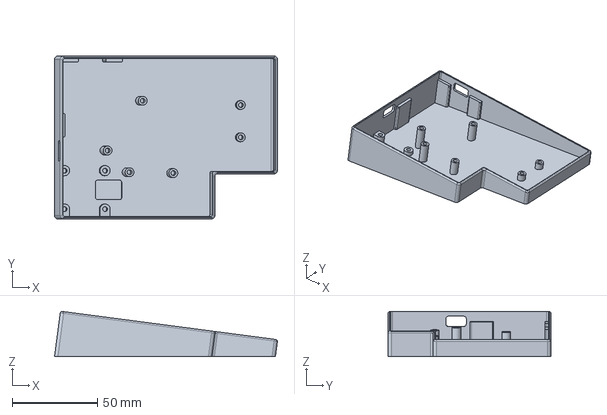
[picture p71: CAD file, 2026-11-05]
cases/right-desk.step
131.1 x 95.8 x 26.6 mm
