oktntko/curcur40/pcbs/common/kbd/3dmodels/ckw12_stem.stp

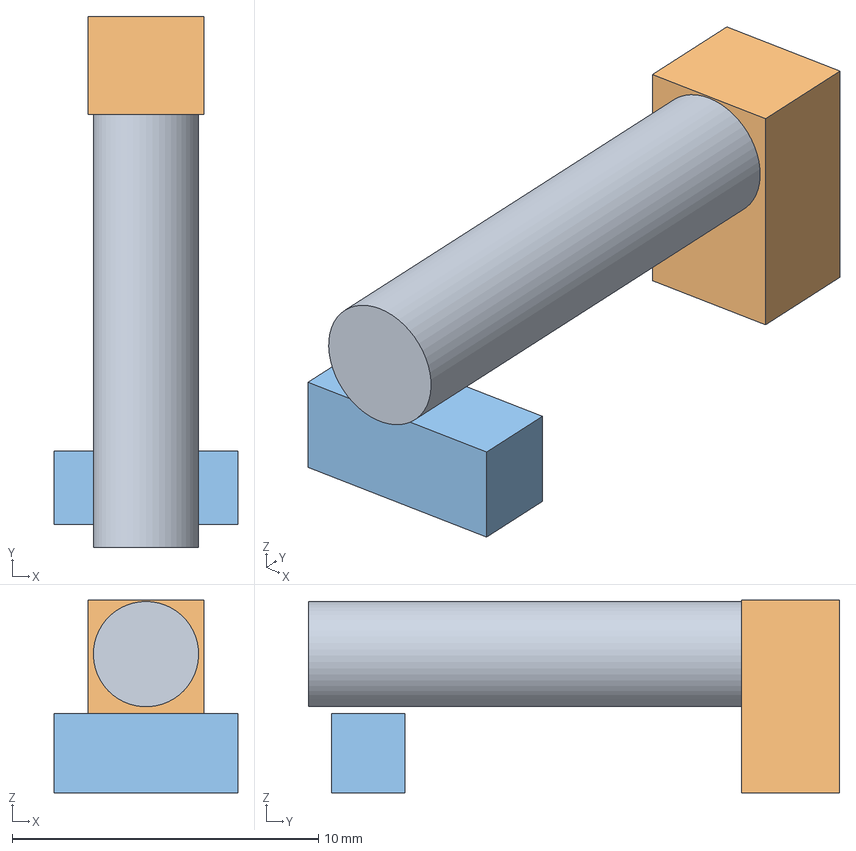
[picture p72: CAD file, 2026-10-12]
pcbs/common/kbd/3dmodels/ckw12_stem.stp
6.00 x 17.4 x 6.30 mm
