oktntko/curcur40/scratch/pmw3360_plan_b.step

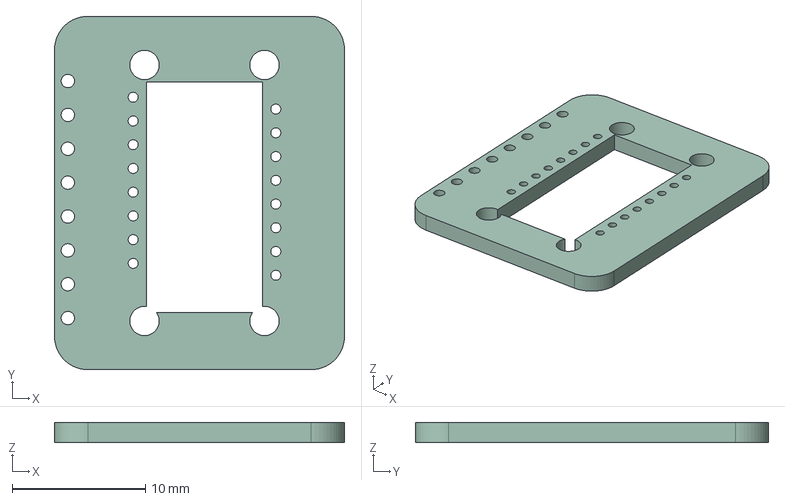
[picture p73: CAD file, 2026-10-16]
scratch/pmw3360_plan_b.step
21.8 x 26.5 x 1.51 mm
