oktntko/curcur40/cases/carrying-box-lid.step

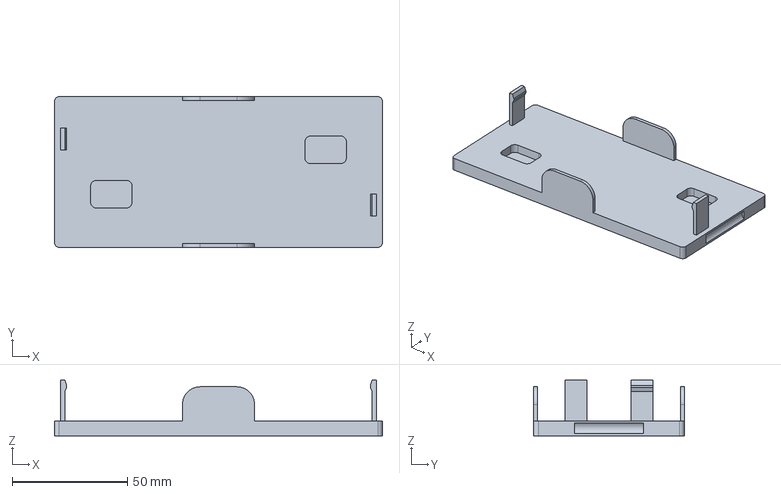
[picture p74: CAD file, 2026-11-05]
cases/carrying-box-lid.step
142.4 x 65.4 x 24.1 mm
