oktntko/curcur40/cases/inertia_wheel/wheel-cradle.step

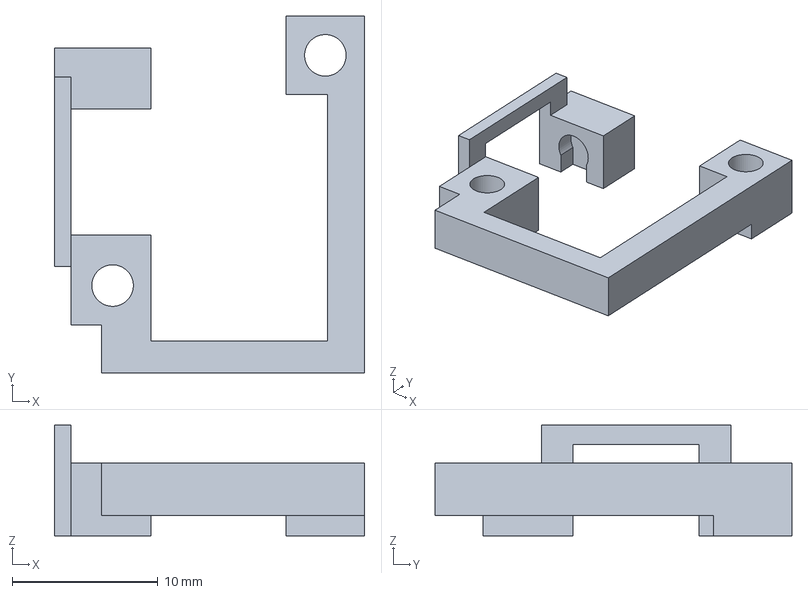
[picture p75: CAD file, 2026-11-05]
cases/inertia_wheel/wheel-cradle.step
21.3 x 24.5 x 7.60 mm
