oktntko/curcur40/cases/inertia_wheel/steel-flywheel.step

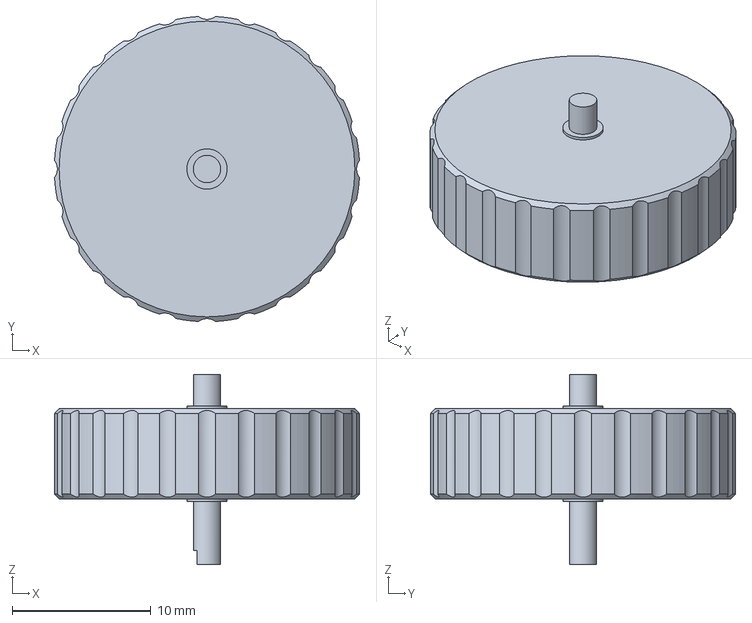
[picture p76: CAD file, 2026-11-05]
cases/inertia_wheel/steel-flywheel.step
22.0 x 22.0 x 13.7 mm
