oktntko/curcur40/cases/left-desk.step

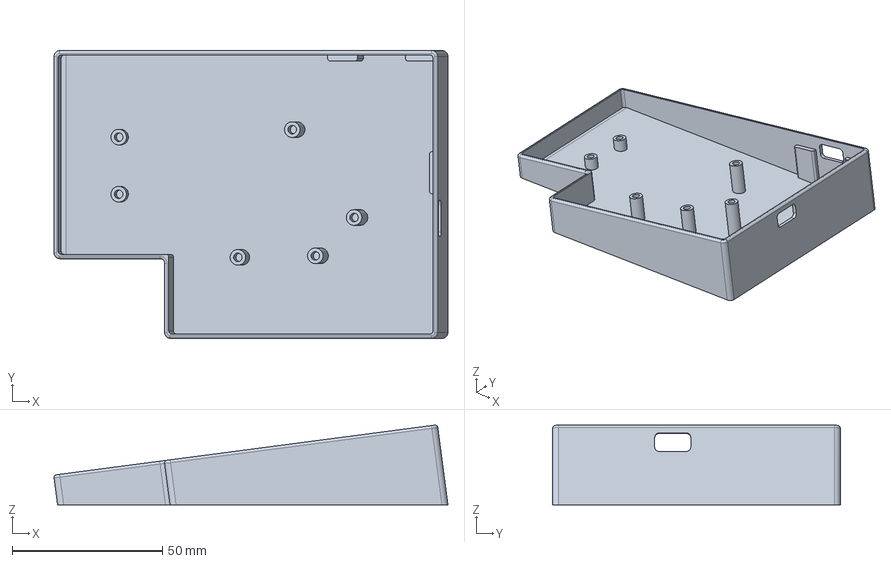
[picture p77: CAD file, 2026-11-05]
cases/left-desk.step
131.1 x 95.8 x 26.6 mm
