oktntko/curcur40/cases/inertia_wheel/magnet-holder.step

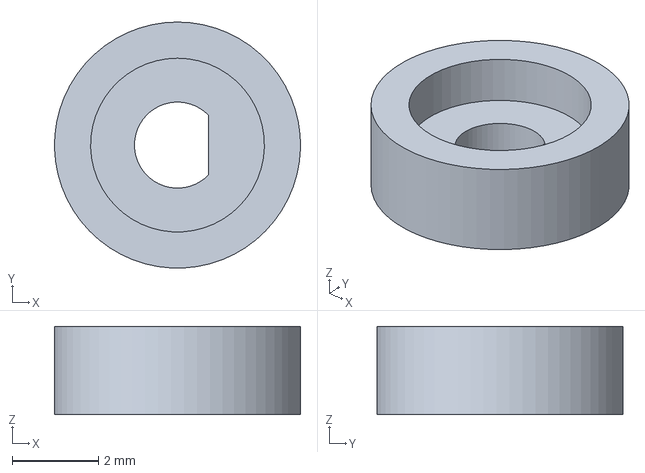
[picture p78: CAD file, 2026-11-05]
cases/inertia_wheel/magnet-holder.step
5.72 x 5.72 x 2.05 mm
