oktntko/curcur40/cases/carrying-box.step

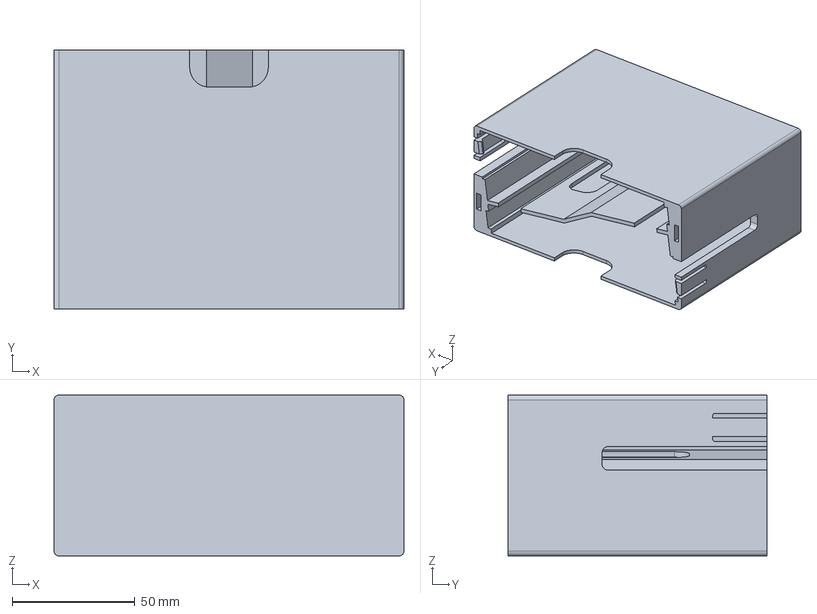
[picture p79: CAD file, 2026-11-05]
cases/carrying-box.step
142.4 x 105.2 x 65.4 mm
