oktntko/curcur40/cases/inertia_wheel/ratchet-hub.step

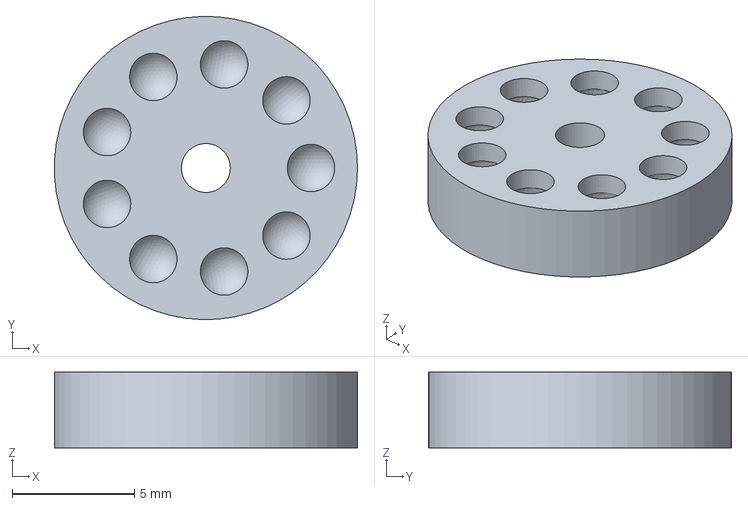
[picture p80: CAD file, 2026-10-31]
cases/inertia_wheel/ratchet-hub.step
12.4 x 12.4 x 3.10 mm
