oktntko/curcur40/cases/carrying-frame.step

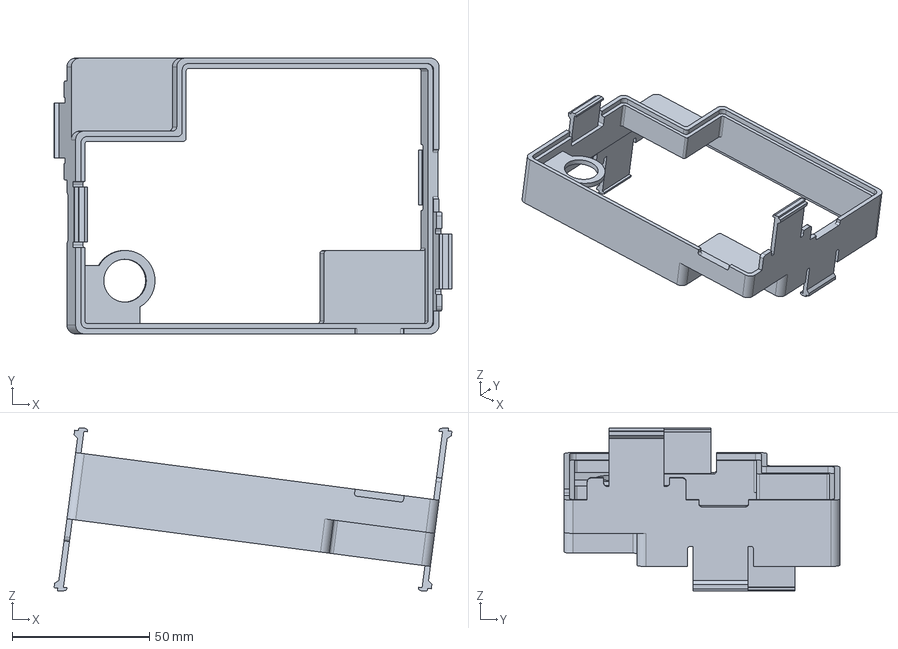
[picture p81: CAD file, 2026-11-04]
cases/carrying-frame.step
144.8 x 100.3 x 59.2 mm
