oktntko/curcur40/cases/inertia_wheel/wheel-base-frame-sunk.step

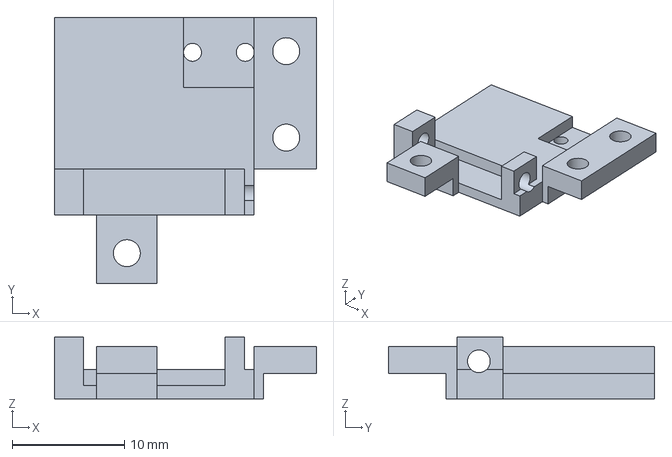
[picture p82: CAD file, 2026-10-31]
cases/inertia_wheel/wheel-base-frame-sunk.step
23.4 x 23.7 x 5.50 mm
