oktntko/curcur40/cases/inertia_wheel/eval-pod-stand.step

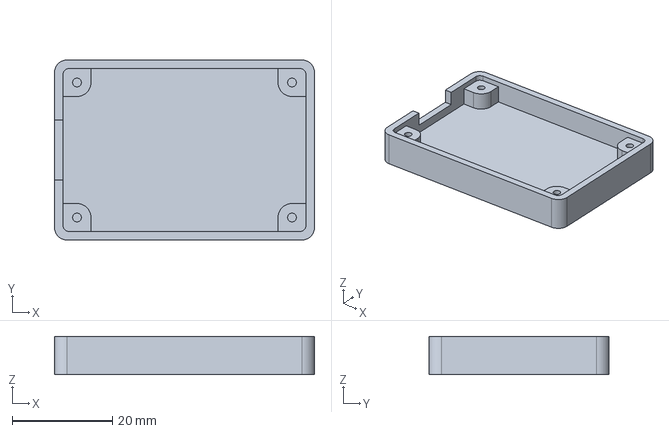
[picture p83: CAD file, 2026-10-31]
cases/inertia_wheel/eval-pod-stand.step
52.0 x 36.0 x 7.60 mm
