oktntko/curcur40/cases/inertia_wheel/wheel-base-frame.step

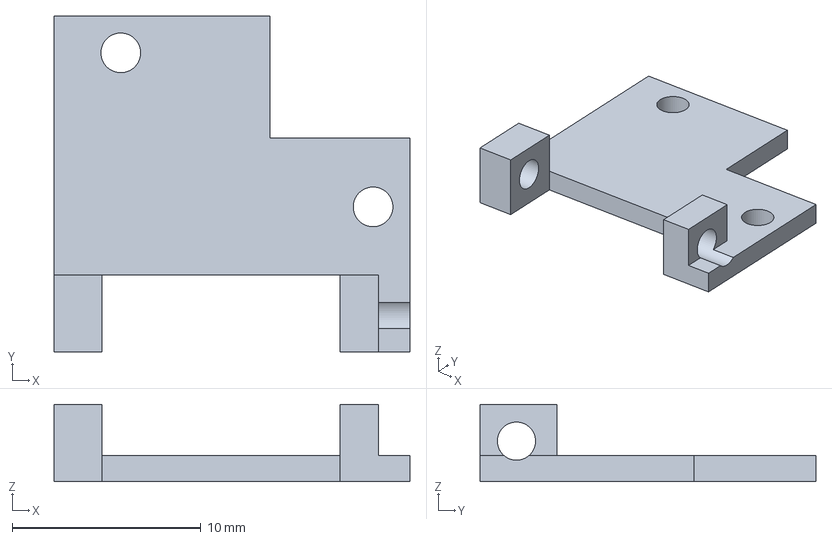
[picture p84: CAD file, 2026-10-31]
cases/inertia_wheel/wheel-base-frame.step
18.8 x 17.8 x 4.10 mm
