oktntko/curcur40/cases/trackball-cup.step

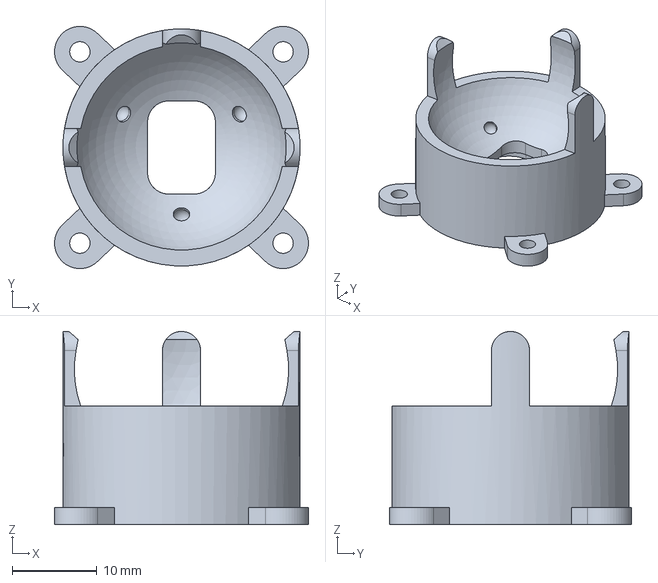
[picture p85: CAD file, 2026-10-31]
cases/trackball-cup.step
30.0 x 28.6 x 22.8 mm
