oktntko/curcur40/cases/assemblies/trackball-cup-with-ball.step

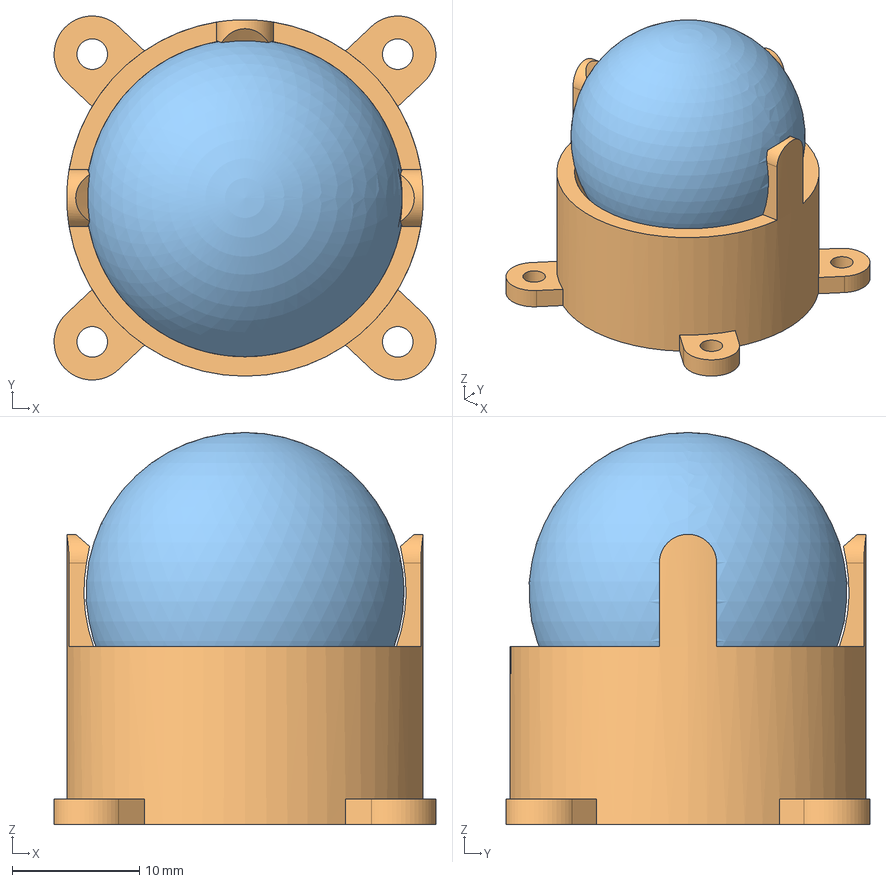
[picture p86: CAD file, 2026-10-31]
cases/assemblies/trackball-cup-with-ball.step
30.0 x 28.6 x 30.8 mm
Trackball_Cup
Trackball_25mm
Lens_Optical_Ref_Point
