oktntko/curcur40/cases/inertia_wheel/wheel-cover.step

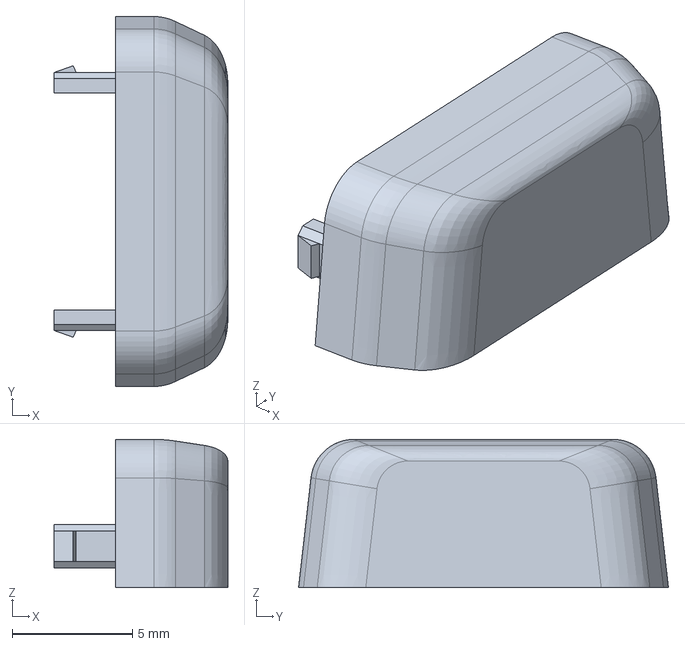
[picture p87: CAD file, 2026-10-31]
cases/inertia_wheel/wheel-cover.step
7.23 x 15.4 x 6.17 mm
