oktntko/curcur40/cases/inertia_wheel/sus304-flywheel.step

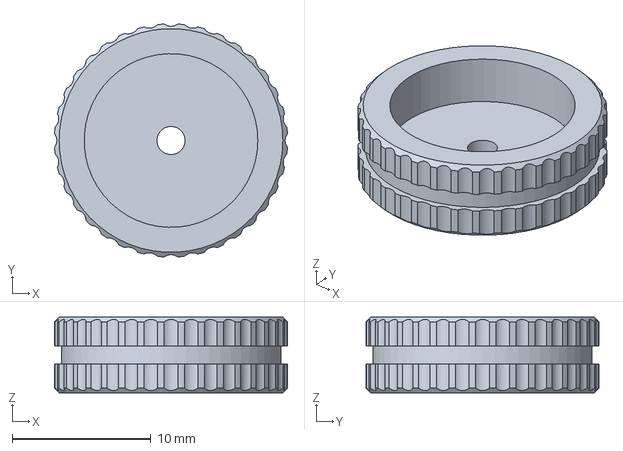
[picture p88: CAD file, 2026-10-31]
cases/inertia_wheel/sus304-flywheel.step
16.8 x 16.8 x 5.46 mm
