oktntko/curcur40/cases/assemblies/curcur40-right-with-inertia-wheel-sunk.step

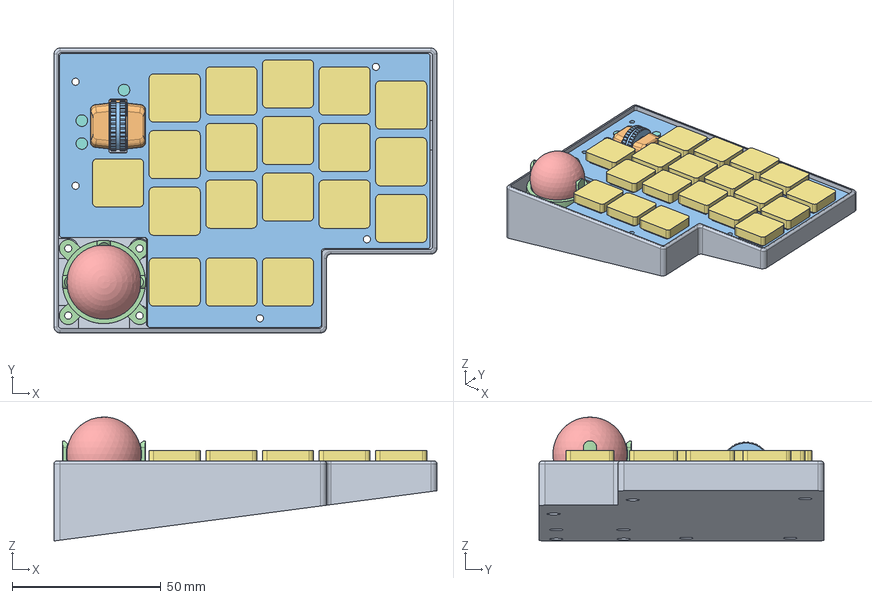
[picture p89: CAD file, 2026-10-31]
cases/assemblies/curcur40-right-with-inertia-wheel-sunk.step
128.8 x 95.8 x 41.7 mm
curcur40_Right_Case
curcur40_Right_Main_PCB
curcur40_Right_Top_Plate
Trackball_Cup
Trackball_25mm_Ref
Right_PCB_rJ3_JST_SH
Right_PCB_rJ5_JST_SH
Right_Keycap_01
Right_Keycap_02
Right_Keycap_03
Right_Keycap_04
Right_Keycap_05
Right_Keycap_06
Right_Keycap_07
Right_Keycap_08
Right_Keycap_09
Right_Keycap_10
Right_Keycap_11
Right_Keycap_12
Right_Keycap_13
Right_Keycap_14
Right_Keycap_15
Right_Keycap_16
Right_Keycap_17
Right_Keycap_18
Right_Keycap_19
Sunk_Mount_Top_Screw_M2x4_1
Sunk_Mount_Top_Screw_M2x4_2
Sunk_Mount_Top_Screw_M2x4_3
Wheel_Base_Frame_Sunk
Wheel_Hinged_Carriage
SUS304_Flywheel_Cup_16p8mm
Ratchet_Hub_Internal_Resin
SUS303_Axle_Shaft_2x10mm
SUS304_Inner_Race_Shim_M2x3x0p5
Bearing_DDL520_West
Bearing_DDL520_East
Hinge_Pin_SUS303_2x16mm
Diametric_Magnet_4x1mm
AS5600_Sensor_SubPCB
AS5600_SOIC8_IC
AS5600_Cap_C1_100nF
AS5600_Cap_C2_1uF
Kailh_Silent_Switch_6x6x4p3
M2_Magnet_Adjuster_And_NdFeB
Steel_Ball_2mm_01
Steel_Ball_2mm_02
Steel_Ball_2mm_03
Steel_Ball_2mm_04
Steel_Ball_2mm_05
Steel_Ball_2mm_06
Steel_Ball_2mm_07
Steel_Ball_2mm_08
Steel_Ball_2mm_09
Sunk_Mount_Standoff_M2_5p5mm_1
Sunk_Mount_Bottom_Screw_M2x4_1
Sunk_Mount_Standoff_M2_5p5mm_2
Sunk_Mount_Bottom_Screw_M2x4_2
Sunk_Mount_Standoff_M2_5p5mm_3
Sunk_Mount_Bottom_Screw_M2x4_3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
