oktntko/curcur40/cases/inertia_wheel/wheel-carriage.step

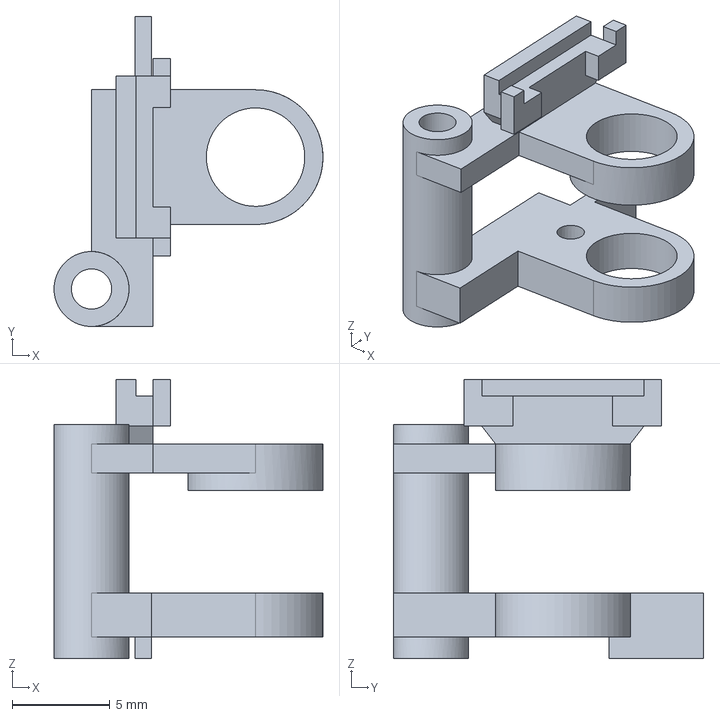
[picture p90: CAD file, 2026-10-31]
cases/inertia_wheel/wheel-carriage.step
13.8 x 15.9 x 14.3 mm
