oktntko/curcur40/cases/trackball-cup-with-ball.step

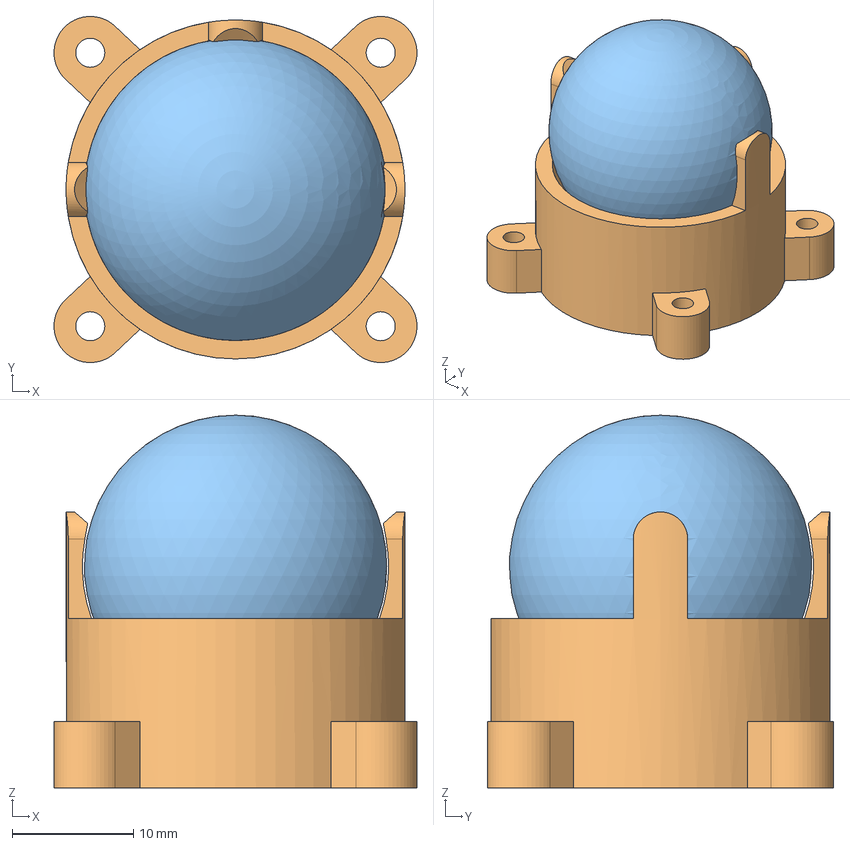
[picture p91: CAD file, 2026-10-23]
cases/trackball-cup-with-ball.step
30.0 x 28.6 x 30.8 mm
Trackball_Cup
Trackball_25mm
Lens_Optical_Ref_Point
