oktntko/curcur40/cases/inertia_wheel/ratchet-hub-11ball.stl

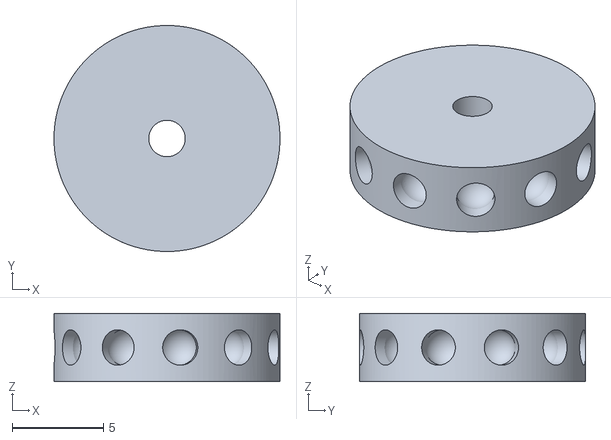
[picture p92: CAD file, 2026-10-25]
cases/inertia_wheel/ratchet-hub-11ball.stl
12.4 x 12.4 x 3.75
