oktntko/curcur40/(list of files, cad)

Other CAD files:
cases/pmw3360-lens-pcb-assembly.step
cases/trackball-sensor-assembly.step
scratch/pmw3360_test.step
cases/right.step
cases/left.step
cases/assemblies/trackball-cup-with-ball.stl
cases/carrying-box-lid.stl
cases/carrying-box.stl
cases/carrying-frame.stl
cases/curcur40/assembly-full.step
cases/curcur40/left.step
cases/curcur40/left.stl
cases/curcur40/pmw3360-lens-pcb-assembly.step
cases/curcur40/right.step
cases/curcur40/right.stl
cases/curcur40/trackball-cup-with-ball.step
cases/curcur40/trackball-cup.step
cases/curcur40/trackball-cup.stl
cases/curcur40/trackball-sensor-assembly.step
cases/inertia_wheel/eval-pod-stand.stl
cases/inertia_wheel/magnet-holder.stl
cases/inertia_wheel/steel-flywheel.stl
cases/inertia_wheel/sus304-flywheel.stl
cases/inertia_wheel/wheel-base-frame-sunk.stl
cases/inertia_wheel/wheel-base-frame.stl
cases/inertia_wheel/wheel-carriage.stl
cases/inertia_wheel/wheel-cover.stl
cases/inertia_wheel/wheel-cradle.stl
cases/inertia_wheel/wheel-rocker.stl
cases/left-desk.stl
cases/left.stl
cases/right-desk.stl
cases/right.stl
cases/trackball-cup-with-ball.stl
cases/trackball-cup.stl
