oktntko/curcur40/docs/inertia_wheel_eval_buildguide_jp.md

# パッシブ磁気慣性ホイール 単体評価ポッド（`curcur40-wheel-eval`）ビルドガイド

本ガイドは、電磁クラッチを使わずに **「`#01` カップ型フライホイール（`SUS304` 5.39g、内部に `#02` 内蔵9球ハブ格納でローター計 6.40g）× `#12` 脱脂ベアリング × 渦電流ゼロの `#13` ラチェット鋼球9個 × `#08` AS5600 IC」** で高速慣性スクロールと静音ミドルクリックを実現する **ホイールコアユニットおよび単体デスクトップ評価ポッド（`curcur40-wheel-eval`）** の資材調達・組み立て・ファームウェア書き込み・磁力チューニング手順書です（モジュールの設計仕様は **[`docs/passive_inertia_wheel_spec.md`](./passive_inertia_wheel_spec.md)**、具体的な購入先・商品URLは **[`docs/parts_spec.md`](./parts_spec.md)**、完成したコアをキーボードメイン基板へ移植する手順は巻末の **[付録](#付録キーボードメイン基板沈み込み実装へのコア移植手順)** を参照してください）。

---

## 部品名称・構成図鑑（共通呼称マップ `#01`〜`#20`）

本ビルドガイドおよび設計・組み立て時のやり取りでは、すべての部品を以下の **`#番号` ＋ 統一呼称（太字）** で呼びます。

パッシブ磁気慣性ホイール 部品名称・構成図鑑

| 番号 | 統一呼称 | 個数 | 区分 | 役割・仕様 |
| :---: | :--- | :---: | :---: | :--- |
| **`#01`** | **カップ型フライホイール** | 1個 | **コア共通** | JLCCNC `SUS304` 切削カップホイール（$\varnothing 16.8 \times 5.46\,\text{mm}$, 単体 $5.39\,\text{g}$、東面に `#02` 格納カップ付） |
| **`#02`** | **内蔵9球ハブ** | 1個 | **コア共通** | JLC3DP SLA 絶縁ラチェットハブ（$\varnothing 12.4 \times 3.10\,\text{mm}$、`#01` カップ内部へ100%格納） |
| **`#03`** | **キャリッジ** | 1個 | **コア共通** | JLC3DP SLA スリム丸耳・一体揺動キャリッジ（$13.77 \times 15.87 \times 14.30\,\text{mm}$、ローター・基板・抜け止めテーパー調整穴を一体保持） |
| **`#04A`** | **オンボードベース枠** | 1個 | 評価ポッド用 | JLC3DP SLA 基板上載せ固定枠（[`wheel-base-frame.step`](../cases/inertia_wheel/wheel-base-frame.step)、$18.83 \times 17.78 \times 4.10\,\text{mm}$、対角2点M2固定） |
| **`#04B`** | **沈み込みベース枠** | *(1個)* | *(メイン基板用)* | *(任意)* JLC3DP SLA 沈み込み固定枠（[`wheel-base-frame-sunk.step`](../cases/inertia_wheel/wheel-base-frame-sunk.step)、キーボードメイン基板へ低背統合する際に使用） |
| **`#20`** | **ホイールカバー** | *(2個)* | *(メイン基板用)* | *(任意)* JLC3DP SLA エッジ曲面ピラミッド・スナップカバー（[`wheel-cover.step`](../cases/inertia_wheel/wheel-cover.step)、**$180^\circ$ 回転対称の共通部品×2個**、トッププレートへスイッチ式スナップ固定） |
| **`#05`** | **ポッド台座** | 1個 | 評価ポッド用 | JLC3DP SLA 単体評価ポッド用卓上ケース（$52 \times 36 \times 7.6\,\text{mm}$、`M2×6mm` セルフタップ盲穴） |
| **`#06`** | **キャリア基板** | 1枚 | 評価ポッド用 | JLCPCB `curcur40-wheel-eval`（$48 \times 32 \times 1.6\,\text{mm}$、`U1` 裏面逃がし窓・`J1`/プルアップ抵抗 PCBA実装済） |
| **`#07`** | **センサー基板** | 1枚 | **コア共通** | JLCPCB `curcur40-wheel-sensor`（$22 \times 22\,\text{mm}$ 枠付 $\rightarrow$ 折って段付き $8.2/8.0 \times 9.40\,\text{mm}$、**板厚 `0.8 mm`・表面 PCBA で `#08` 同軸実装済**） |
| **`#08`** | **AS5600 IC** | *(PCBA済)* | **コア共通** | `AS5600-ASOT` (`C499458`) ＋ パスコン `100nF` / `1μF`（※**`#07` 表面へ工場実装済・個別購入不要**） |
| **`#09`** | **RP2040-Zero** | 1個 | 評価ポッド用 | `Waveshare RP2040-Zero` マイコンボード（ピンヘッダ未実装／付属ピンヘッダ両対応） |
| **`#10`** | **静音スイッチ** | 1個 | **コア共通** | `Kailh Square Silent` 角形2ピン静音マイクロスイッチ（$6.2 \times 6.2 \times 4.3\,\text{mm}$ `Red Dot`、ミドルクリック用） |
| **`#11`** | **センサー6芯線** | 1式 | **コア共通** | JST SH 1.0mm 6P 片側ハウジング端子付ケーブル（`#07` センサー基板4線＋`#10` スイッチ2線 ↔ ホスト基板 `J1`/`rJ5`） |
| **`#12`** | **ベアリング（＋内輪シム）** | 2個＋2枚 | **コア共通** | NMB ミネベアミツミ `DDL-520` オープン形 2個（$\varnothing 2 \times \varnothing 5 \times 1.5\,\text{mm}$、**要脱脂**）＋ 岩田製作所 `SUS304` 内輪シムリング `Ø2 × Ø3 mm`（`0.2mm` `BRS002003020` ＋ `0.3mm` `BRS002003030`） |
| **`#13`** | **ラチェット鋼球** | 9個 | **コア共通** | `SUJ2` **磁性精密ベアリング鋼球** $\varnothing 2.00\,\text{mm}$ G20（セラミック球不可） |
| **`#14`** | **回転シャフト** | 1本 | **コア共通** | ステンレス `SUS303` 平行ピン B種h7 $\varnothing 2.0 \times 10\,\text{mm}$（ホイール中心軸） |
| **`#15`** | **ヒンジピン** | 1本 | **コア共通** | ステンレス `SUS303` 平行ピン B種h7 $\varnothing 2.0 \times 16\,\text{mm}$（北端スイング軸） |
| **`#16`** | **角度磁石** | 1個 | **コア共通** | **径方向2極着磁（Diametric）** ネオジム磁石 $\varnothing 4.0 \times 1.0\,\text{mm}$ (`D4x1mm`, `#14` シャフト端に接着) |
| **`#17`** | **ラチェット磁石** | 1個 | **コア共通** | 通常の**軸方向着磁** ネオジム磁石 二六製作所 `NE218` $\varnothing 1.50 \times 1.50\,\text{mm}$ (`N40`, `#18` 先端に吸着固定) |
| **`#18`** | **磁力調整ネジ** | 1本 | **コア共通** | 非磁性ステンレス `SUS304` `DIN916` 六角穴付きホーローセット `M2 × 4mm`（`#03` 抜け止めテーパー穴へ軸方向ねじ込み） |
| **`#19`** | **固定M2ネジ・ナット・スペーサー（＋足）** | 1式 | 評価ポッド用 | **`M2 × 6.0mm` ネジ × 6本 ＋ `M2` ナット × 2個**（枠対角固定2組＋台座四隅固定4本、※沈み込み枠 `#04B` は M2 5.50mm スペーサー 3個＋上下 M2×4.0mm ネジ 6本）＋ 台座裏面ゴム足 × 4個 |

> [!TIP]
> **共通ホイールコアのモジュール構造（テスト基板 ⇔ キーボードメイン基板の相互移植性）**
> 本ガイドの Phase 4 で組み立てる **ホイールコアユニット（`#01` フライホイール・`#02` 内蔵9球ハブ・`#03` キャリッジ・`#07` センサー基板 等）** は、マウント枠（`#04A` ⇔ `#04B`）を差し替えるだけでテスト基板にもキーボードメイン基板にもそのまま載せ替えられる独立モジュールです。まずは単体評価ポッド上で好みの磁気ノッチ感（`#18` 調整ネジ）を出してから、必要に応じてキーボードへ移植できます。

---

## 目次

- **[部品名称・構成図鑑（共通呼称マップ `#01`〜`#20`）](#部品名称構成図鑑共通呼称マップ-0120)**
- **[Step 1: 資材一覧と入手経路・発注ガイド](#step-1-資材一覧と入手経路発注ガイド)**
  - [1-1. 全体構成の概要（4つの調達ルート）](#1-1-全体構成の概要4つの調達ルート)
  - [1-2. JLCPCB に発注するもの（基板 2種：`#06`, `#07` ともに片面 Economic PCBA）](#1-2-jlcpcb-に発注するもの基板-2種06-07-ともに片面-economic-pcba)
  - [1-3. JLCCNC に発注するもの（`#01` カップ型フライホイール）](#1-3-jlccnc-に発注するもの01-カップ型フライホイール)
  - [1-4. JLC3DP に発注するもの（SLA 高精細レジン造形パーツ：`#02`〜`#05`, `#20`）](#1-4-jlc3dp-に発注するものsla-高精細レジン造形パーツ0205-20)
  - [1-5. 通販（Amazon・秋月電子・遊舎工房等）で購入するパーツ（`#09`〜`#19`）](#1-5-通販amazon秋月電子遊舎工房等で購入するパーツ0919)
  - [1-6. 発注前チェックリスト](#1-6-発注前チェックリスト)
- **[Step 2: 組み立て・脱脂・ハンダ付け・ファームウェア書き込み手順](#step-2-組み立て脱脂ハンダ付けファームウェア書き込み手順)**
  - [2-1. 必要な工具・ケミカル](#2-1-必要な工具ケミカル)
  - [2-2. Phase 1: `#09` RP2040-Zero 単体への QMK ファームウェア書き込み](#2-2-phase-1-09-rp2040-zero-単体への-qmk-ファームウェア書き込み)
  - [2-3. Phase 2: `#12` ベアリングの脱脂洗浄（★最重要ステップ）](#2-3-phase-2-12-ベアリングの脱脂洗浄最重要ステップ)
  - [2-4. Phase 3: 基板のハンダ付け（`#07` センサー基板 ＆ `#06` キャリア基板）](#2-4-phase-3-基板のハンダ付け07-センサー基板--06-キャリア基板)
  - [2-5. Phase 4: カップ内蔵ローター（`#01`＋`#02`）と `#03` キャリッジの組み立て](#2-5-phase-4-カップ内蔵ローター0102と-03-キャリッジの組み立て)
  - [2-6. Phase 5: `#04A` オンボードベース枠・`#05` ポッド台座への組み付けと `#18` 磁力調整](#2-6-phase-5-04a-オンボードベース枠05-ポッド台座への組み付けと-18-磁力調整)
  - [2-7. Phase 6: PC 動作確認・分解能カスタマイズ・トラブルシューティング](#2-7-phase-6-pc-動作確認分解能カスタマイズトラブルシューティング)
- **[付録：キーボードメイン基板（沈み込み実装）へのコア移植手順](#付録キーボードメイン基板沈み込み実装へのコア移植手順)**

---

# Step 1: 資材一覧と入手経路・発注ガイド

## 1-1. 全体構成の概要（4つの調達ルート）

単体評価ポッド（および移植用パーツ）の資材（`#01`〜`#20`）は、以下の **4ルート** で揃います（特殊な手巻きコイルや専用カスタムICは一切不要です）。

1. **JLCPCB（基板製造・Economic PCBA）**: `#06` キャリア基板（$48.0 \times 32.0\,\text{mm}$、Top PCBA）＋ `#07` センサー基板（$22.0 \times 22.0\,\text{mm}$ 捨て基板枠付 $\rightarrow$ 折って段付き $8.2/8.0 \times 9.40\,\text{mm}$、板厚 `0.8 mm`・Top PCBA で `#08` 自動実装済）
2. **JLCCNC（金属CNC切削）**: `#01` カップ型フライホイール（`SUS304` 削り出し $\varnothing 16.80 \times 5.46\,\text{mm}$）
3. **JLC3DP（SLA 3Dプリント）**: `#02` 内蔵9球ハブ・`#03` キャリッジ・`#04A` オンボードベース枠・`#05` ポッド台座（＋キーボードメイン基板へ沈み込み統合する場合は `#04B` 沈み込みベース枠 ×1個、**`#20` ホイールカバー `wheel-cover.step` ×2個**）
4. **国内通販・海外通販（モノタロウ / Amazon / スイッチサイエンス / 二六製作所 / AliExpress 等）**: `#09` RP2040-Zero・`#10` 静音スイッチ・`#11` センサー6芯線（JST SH 6P片側ハウジング付）・`#12` ベアリング・`#13` ラチェット鋼球・`#14` 回転シャフト・`#15` ヒンジピン・`#16` 角度磁石・`#17` ラチェット磁石・`#18` 磁力調整ネジ・`#19` 固定M2ネジ＆ゴム足（※品薄になりやすい `#08` AS5600 IC と極小 `0402` パスコンは `#07` の JLCPCB PCBA に含まれるため個別手配不要です！）

---

## 1-2. JLCPCB に発注するもの（基板 2種：`#06`, `#07` ともに片面 Economic PCBA）

JLCPCB（[https://jlcpcb.com/](https://jlcpcb.com/)）にて以下の **2種類の基板をどちらも表面片面実装（`Top Side` Economic PCBA）** で発注します。

| 対象基板（統一呼称） | 基板サイズ・板厚 | 推奨発注形態 | ガーバー (ZIP) | BOM (CSV) | CPL (CSV) |
| :--- | :---: | :---: | :--- | :--- | :--- |
| **`#06` キャリア基板**<br>(`curcur40-wheel-eval`) | $48.0 \times 32.0\,\text{mm}$<br>**板厚 `1.6 mm`** | **PCB + Economic PCBA**<br>（表面 `Top Side` 実装） | [GERBER-curcur40-wheel-eval.zip](../pcbs/inertia-wheel-eval/jlcpcb/production_files/GERBER-curcur40-wheel-eval.zip) | [BOM-curcur40-wheel-eval.csv](../pcbs/inertia-wheel-eval/jlcpcb/production_files/BOM-curcur40-wheel-eval.csv) | [CPL-curcur40-wheel-eval.csv](../pcbs/inertia-wheel-eval/jlcpcb/production_files/CPL-curcur40-wheel-eval.csv) |
| **`#07` センサー基板**<br>(`curcur40-wheel-sensor`) | $22.0 \times 22.0\,\text{mm}$ 枠付<br>（折って $8.2/8.0 \times 9.40\,\text{mm}$）<br>**板厚 `0.8 mm`** | **PCB + Economic PCBA**<br>（表面 `Top Side` 実装） | [GERBER-curcur40-wheel-sensor.zip](../pcbs/inertia-wheel-sensor/jlcpcb/production_files/GERBER-curcur40-wheel-sensor.zip) | [BOM-curcur40-wheel-sensor.csv](../pcbs/inertia-wheel-sensor/jlcpcb/production_files/BOM-curcur40-wheel-sensor.csv) | [CPL-curcur40-wheel-sensor.csv](../pcbs/inertia-wheel-sensor/jlcpcb/production_files/CPL-curcur40-wheel-sensor.csv) |

| `#07` センサー基板 表面（`Top Side` PCBA 自動実装面・同軸段付き輪郭） | `#07` センサー基板 裏面（`#11` センサー線 `1〜4番` スルーホール面） |
| :---: | :---: |
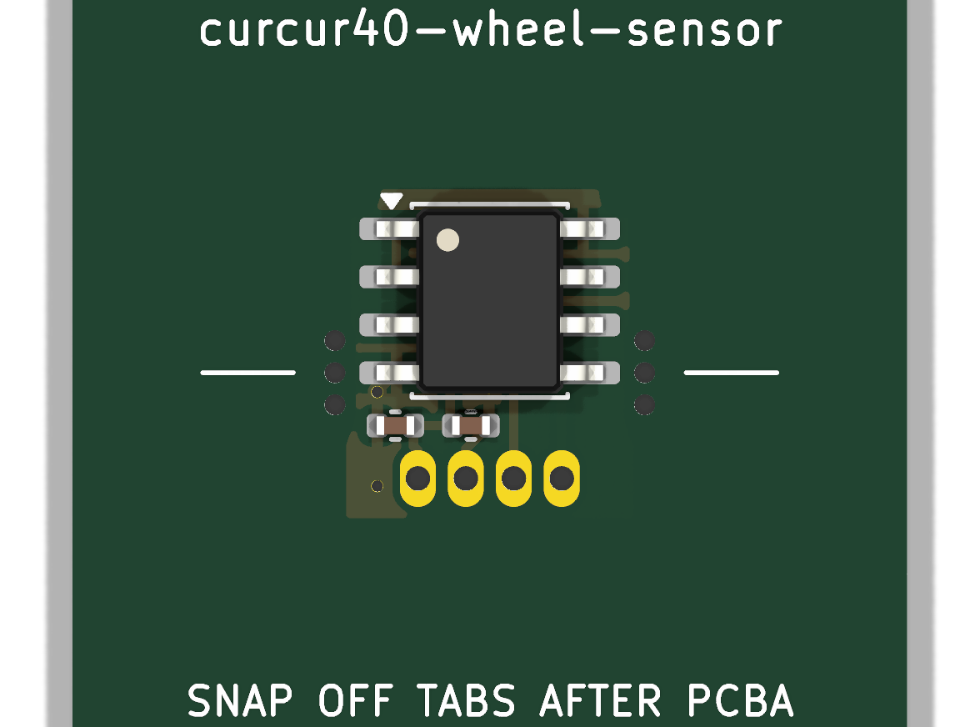
[picture p96: docs/assets/render_pcb_wheel_sensor.png]
Wheel Sensor Top
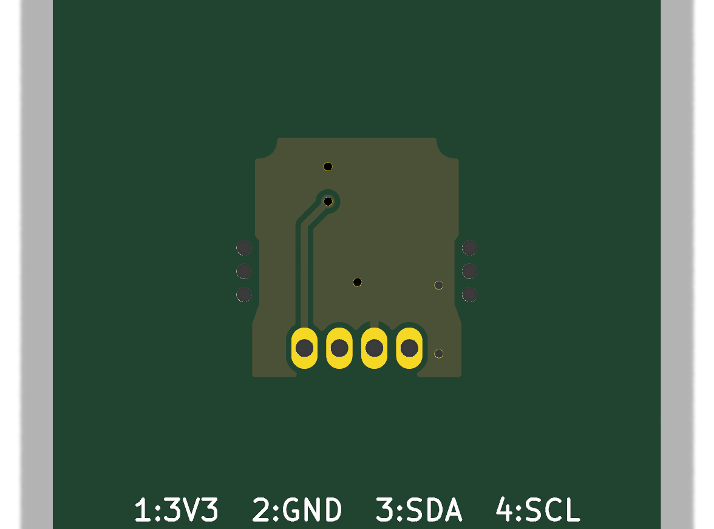
[picture p97: docs/assets/render_pcb_wheel_sensor_back.png]
Wheel Sensor Back
|  |  |

### JLCPCB 発注時の注意点
* **`#06` キャリア基板 (`curcur40-wheel-eval`)**:
  * **PCB Thickness**: `1.6 mm`、**PCBA Type**: `Economic`、**Assembly Side**: **`Top Side`**（`J1` JST SH 6ピンコネクタ `C160405`、I2C プルアップ抵抗 `R1/R2 4.7kΩ` `C25900`、パスコン `C1 100nF` `C1525` の計4点が自動実装されます）。
  * `U1`（`#09` RP2040-Zero：端面キャスタレーション実装・ピンヘッダ実装の両対応フットプリント＋裏面部品逃がしくり抜き窓付）と `SW1`（`#10` 静音スイッチ）は後から手ハンダするため、PCBA 画面で Unplaced となっていて正常です。
* **`#07` センサー基板 (`curcur40-wheel-sensor`)**:
  * **PCB Thickness**: 必ず **`0.8 mm`** を選択してください（`#03` キャリッジの $0.85\,\text{mm}$ 基板保持棚および `#20` ホイールカバー内部ポケットに収めるため）。
  * **PCBA Type**: **`Economic`**、**Assembly Side**: **`Top Side`**（表面片面実装：`U1 AS5600-ASOT` `C499458`、パスコン `C1 100nF` `C1525`、`C2 1μF` `C52923` の全3点が工場で自動実装されて届きます）。
  * 外周に **$22.0 \times 22.0\,\text{mm}$ の捨て基板枠（ルータースリット＋インセット配置の左右3穴マウスバイト `SNAP` タブ、Vカット不使用）** を備えているため、JLCPCB の単体 PCBA 最小サイズ（$20 \times 20\,\text{mm}$）および板厚 `0.8 mm` Economic PCBA 条件をそのまま満たします。到着後に左右の `SNAP` タブをパキッと折るだけで、折れ残り耳が外周から飛び出さず `#20` ホイールカバーの内壁にも干渉しない段付き $8.2/8.0 \times 9.40\,\text{mm}$ 基板になります。

---

## 1-3. JLCCNC に発注するもの（`#01` カップ型フライホイール）

JLC3DP / JLCCNC の **CNC Machining** サービス（[https://jlc3dp.com/cnc-machining-quote](https://jlc3dp.com/cnc-machining-quote)）へ STEP ファイルをアップロードして発注します。

| 対象パーツ（統一呼称） | 数量 | アップロードファイル | 推奨材質・表面仕上げ指定 |
| :--- | :---: | :--- | :--- |
| **`#01` カップ型フライホイール** | **1個〜** | [sus304-flywheel.step](../cases/inertia_wheel/sus304-flywheel.step) | - **Material**: **`Stainless Steel - SUS304`**（非磁性ステンレス）<br>- **Surface Finish**: **`As Machined (Ra 1.6 μm)`**（シルバー切削光沢仕上げ ※Bead Blasting にするとマットグレーになるため `As Machined` または `Polishing` 推奨）<br>- **Smallest Tolerance**: `±0.05 mm`（ISO 2768 fine / 軸穴 $\varnothing 2.02\,\text{mm}$、カップ内径 $\varnothing 12.50\,\text{mm}$） |

---

## 1-4. JLC3DP に発注するもの（SLA 高精細レジン造形パーツ：`#02`〜`#05`, `#20`）

JLC3DP の **3D Printing** サービス（[https://jlc3dp.com/3d-printing-quote](https://jlc3dp.com/3d-printing-quote)）にて、以下の樹脂パーツを **SLA（光造形レジン：`8001` 半透明 / `Imagine Black` / `9600` 等）** で発注します。`#12` ベアリング圧入座、`#13` ラチェット鋼球スナップインポケット、および `#20` ホイールカバーのスナップ爪精度を出すため、**SLA レジン** を推奨します。

| 対象パーツ（統一呼称） | 数量 | アップロード用 (STEP 推奨) | STL ファイル | 役割 |
| :--- | :---: | :--- | :--- | :--- |
| **`#02` 内蔵9球ハブ** | **1〜2個** | [ratchet-hub.step](../cases/inertia_wheel/ratchet-hub.step) | [ratchet-hub.stl](../cases/inertia_wheel/ratchet-hub.stl) | **[コア共通]** `#01` カップ内部に収まり `#13` 鋼球×9個を絶縁保持 |
| **`#03` キャリッジ** | **1〜2個** | [wheel-carriage.step](../cases/inertia_wheel/wheel-carriage.step) | [wheel-carriage.stl](../cases/inertia_wheel/wheel-carriage.stl) | **[コア共通]** スリム丸耳軸受で `#01`・`#07`・`#18` 等を一体保持して揺動 |
| **`#04A` オンボードベース枠** | **1個** | [wheel-base-frame.step](../cases/inertia_wheel/wheel-base-frame.step) | [wheel-base-frame.stl](../cases/inertia_wheel/wheel-base-frame.stl) | **[評価ポッド用]** `#06` キャリア基板（および平坦な基板上載せ）固定用 |
| **`#05` ポッド台座** | **1個** | [eval-pod-stand.step](../cases/inertia_wheel/eval-pod-stand.step) | [eval-pod-stand.stl](../cases/inertia_wheel/eval-pod-stand.stl) | **[評価ポッド用]** `#06` キャリア基板の卓上ケース |
| *(任意)* **`#04B` 沈み込みベース枠** | *(1個)* | [wheel-base-frame-sunk.step](../cases/inertia_wheel/wheel-base-frame-sunk.step) | [wheel-base-frame-sunk.stl](../cases/inertia_wheel/wheel-base-frame-sunk.stl) | **[メイン基板組込用]** キーボードメイン基板へ低背沈み込み統合する際に使用 |
| *(任意)* **`#20` ホイールカバー** | *(**2個**〜)* | [wheel-cover.step](../cases/inertia_wheel/wheel-cover.step) | [wheel-cover.stl](../cases/inertia_wheel/wheel-cover.stl) | **[メイン基板組込用]** エッジ曲面ピラミッドカバー（$180^\circ$ 対称共通部品×2個で左右両側をカバー、スイッチ式スナップ固定） |

| オンボード実装：単体デスクトップ評価ポッド（`#04A` 枠使用） | 沈み込み実装：`curcur40-right` 組込例（`#04B` 枠 ＋ `#20` カバー×2） |
| :---: | :---: |
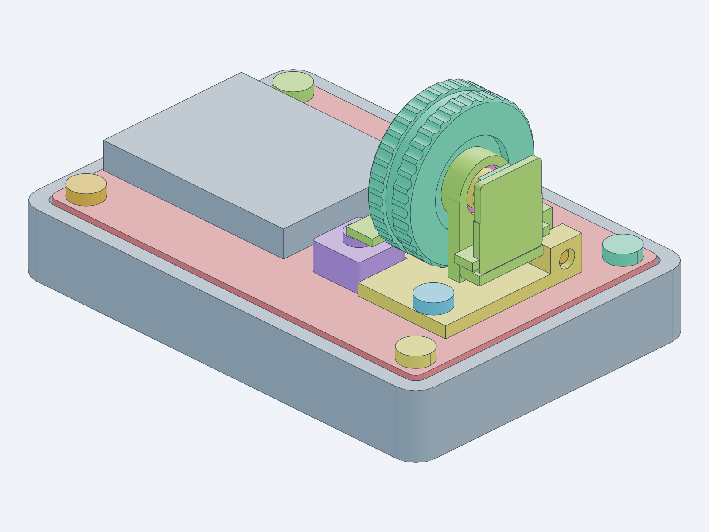
[picture p98: docs/assets/render_inertia_wheel_eval_pod.png]
Eval Pod
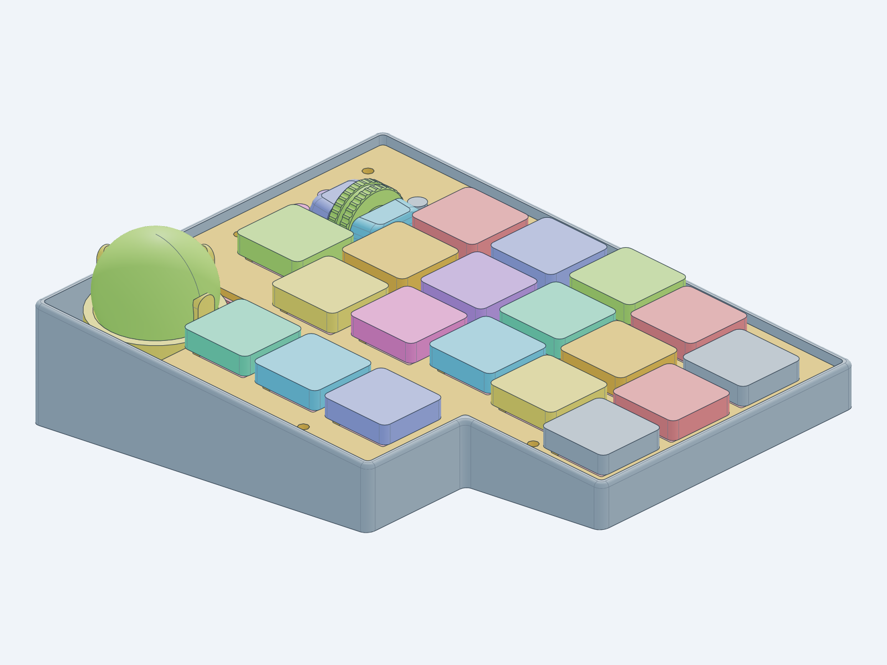
[picture p99: docs/assets/render_curcur40_right_inertia_wheel_sunk.png]
curcur40-right Sunk
|  |  |

---

## 1-5. 通販（Amazon・秋月電子・遊舎工房等）で購入するパーツ（`#09`〜`#19`）

各パーツの具体的な販売ページ URL・詳細仕様は **[`docs/parts_spec.md`](./parts_spec.md)** にまとめています。

| 統一呼称 | 必要数 | 型番・寸法仕様 | 主な入手先（[`parts_spec.md`](./parts_spec.md)） |
| :--- | :---: | :--- | :--- |
| **`#08` AS5600 IC（＋パスコン）** | **個別購入不要** | ams OSRAM **`AS5600-ASOT`** (`C499458`) ＋ パスコン `100nF` (`C1525`) / `1μF` (`C52923`) ※**`#07` センサー基板の JLCPCB PCBA（`Top Side`）で工場自動実装済！** | JLCPCB (LCSC 在庫より自動手配) |
| **`#09` RP2040-Zero** | **1個** | **`Waveshare RP2040-Zero`**（ピンヘッダ未実装タイプ） | スイッチサイエンス (`ssci.to/7886`) / Amazon / 秋月電子 |
| **`#10` 静音スイッチ** | **1個** | **`Kailh Square Silent Micro Switch`**（$6.2 \times 6.2 \times 4.3\,\text{mm}$、2ピン角形静音スイッチ `Red Dot`） | Amazon (`B0FF9Y9DB8`) / 遊舎工房 / AliExpress |
| **`#11` センサー6芯線** | **1式** | **JST SH 1.0mm 6P 片側ハウジング端子付きケーブル**（`Moechando SH1.0mm 6P` 等、約 $60\text{〜}75\,\text{mm}$ にカットして `#07` センサー4パッド＋`#10` スイッチ2端子へ配線） | Amazon (`B092R7C9LM`) / 秋月電子 |
| **`#12` ベアリング ＋ 内輪シムリング** | **2個 ＋ 2枚** | NMB ミネベアミツミ **`DDL-520` オープン形**（内径 $\varnothing 2.0 \times$ 外径 $\varnothing 5.0 \times$ **幅 $1.5\,\text{mm}$**、シールドなし・**要脱脂**）＋ 岩田製作所 **`SUS304` シムリング 内径 $\varnothing 2.0 \times$ 外径 $\varnothing 3.0\,\text{mm}$**（板厚 $0.2\,\text{mm}$ `BRS002003020` ＋ 板厚 $0.3\,\text{mm}$ `BRS002003030`：接着剤なしで `#14` シャフトへ重ね通し、`#02` ハブ側内輪のみ当接して軸方向ガタを規制。外径 $\varnothing 4.0\,\text{mm}$ は外輪に擦れるため不可） | モノタロウ (`09538112` ＋ [`55099162`](https://www.monotaro.com/p/5509/9162/) / [`55099178`](https://www.monotaro.com/p/5509/9178/)) |
| **`#13` ラチェット鋼球** | **9個** | **`SUJ2` 高炭素クロム軸受鋼球 直径 $\varnothing 2.00\,\text{mm}$ (`JIS G20`)**（※セラミック球は磁石に付かないため必ず**磁性のある鋼球 `SUJ2`** を選ぶこと！） | モノタロウ (`40413721`) |
| **`#14` 回転シャフト** | **1本** | **`SUS303` 平行ピン B種h7 $\varnothing 2.0 \times 10\,\text{mm}$**（面取り $c \approx 0.35\,\text{mm}$、短い方：ホイール回転軸用） | モノタロウ (`42155775`) |
| **`#15` ヒンジピン** | **1本** | **`SUS303` 平行ピン B種h7 $\varnothing 2.0 \times 16\,\text{mm}$**（面取り $c \approx 0.35\,\text{mm}$、長い方：北端スイング軸用） | モノタロウ (`42155811`) |
| **`#16` 角度磁石** | **1個** | **径方向2極着磁（Diametric）ネオジム磁石 $\varnothing 4.0 \times 1.0\,\text{mm}$ (`D4x1mm`)**（※必ず直径方向にN/Sが分かれた「径方向着磁／AS5600用」を選ぶこと） | AliExpress (`1005010201889003`: `D4x1mm`) |
| **`#17` ラチェット磁石** | **1個** | 通常の**軸方向着磁**ネオジム磁石 **二六製作所 `NE218` $\varnothing 1.50 \times 1.50\,\text{mm}$ (`N40`, Niメッキ)** | 二六製作所 (`NE218`) |
| **`#18` 磁力調整ネジ** | **1本** | 非磁性 **`SUS304` `DIN916` 六角穴付きホーローセット（イモネジ）`M2 × 4mm`** | AliExpress (`1005008530636994`: `M2 4mm`) / 通販 |
| **`#19` 固定M2ネジ・ナット・スペーサー ＆ ゴム足** | **1式** | ・単体評価ポッド用（`#04A` 対角2点固定＋`#05` 台座四隅固定）：**`M2 × 6.0mm` 低頭/なべネジ × 6本 ＋ `M2` 六角ナット × 2個**（※`#04B` 沈み込み版はキーボード本体と共通の **M2 5.50mm メス-メス スペーサー 3個 ＋ 上下 `M2 × 4.0mm` ネジ 6本**）<br>・`#05` ポッド台座裏面用：貼り付け式ゴム足 × 4個（キーボード本体の余りを流用可） | 遊舎工房 / Amazon / ホームセンター |
| *(任意)* **2way比較用 Oリング** | *(1個)* | 内径 $\varnothing 15.0 \times$ 線径 $1.0\,\text{mm}$ シリコン／ニトリルOリング（`#01` 中央溝に装着してゴム感触も試したい場合のみ） | Amazon / モノタロウ |

---

## 1-6. 発注前チェックリスト

- [ ] **JLCPCB**: `#06` キャリア基板（`1.6mm` / `Top Side` Economic PCBA）＋ `#07` センサー基板（**`0.8mm`** / **`Top Side` Economic PCBA**：`#08` 自動実装済）
- [ ] **JLCCNC**: `#01` カップ型フライホイール `sus304-flywheel.step`（`SUS304` / `As Machined` シルバー切削仕上げ）
- [ ] **JLC3DP**: `#02` 内蔵9球ハブ、`#03` キャリッジ、`#04A` オンボードベース枠、`#05` ポッド台座（＋キーボードメイン基板へ沈み込み統合する場合は `#04B` 沈み込みベース枠 ×1個、`#20` ホイールカバー `wheel-cover.step` ×**2個**、すべて SLA レジン、`#20` はタフレジン推奨）
- [ ] **磁石・鋼球・ベアリング・シムの仕様チェック**:
  - [ ] **`#16` 角度磁石** は **径方向2極着磁（Diametric, `D4x1mm`）** であること（`#17` ラチェット磁石 `NE218` は通常の厚み方向着磁 `Ø1.5×1.5mm`）
  - [ ] **`#13` ラチェット鋼球** は **磁石にくっつく鋼球（`SUJ2`）** であること（※トラックボール用の白いセラミック球と混ぜないよう注意！）
  - [ ] **`#12` ベアリング** は **幅 `1.5 mm` のオープン形 `DDL-520`** であること（組み立て前に必ずパーツクリーナーで脱脂洗浄する）＋ ローター軸方向ガタ止め用の **岩田製作所 `SUS304` シムリング 内径 `2mm` × 外径 `3mm`（`0.2mm` `BRS002003020` ＋ `0.3mm` `BRS002003030`）** を用意していること（※外径 `4mm` は外輪に擦れるため使用不可）

---
---

# Step 2: 組み立て・脱脂・ハンダ付け・ファームウェア書き込み手順

## 2-1. 必要な工具・ケミカル

| 工具・ケミカル | 用途 |
| :--- | :--- |
| **ブレーキ＆パーツクリーナー ＋ 小皿（ガラス瓶）** | `#12` ベアリング内部の防錆油・グリスを完全に洗い流す（脱脂）ために使用します。 |
| **ハンダごて・細ハンダ・フラックス** | `#11` センサー6芯線、`#09` RP2040-Zero、`#10` 静音スイッチのハンダ付けに使用します（極小SMD部品のハンダ付けは不要です！）。 |
| **精密ドライバー（`#00`）＋ `0.9mm` 六角レンチ** | `#19` 固定M2ネジおよび `#18` 磁力調整ネジ（`DIN916` M2 イモネジ）の回転に使用します。 |
| **瞬間接着剤（低白化ジェルタイプ）または 2液エポキシ** | `#01` カップ内部への `#02` ハブ固定、`#14` 回転シャフト西端への `#16` 角度磁石、`#18` 磁力調整ネジ先端への `#17` ラチェット磁石の固定に少量使用します。 |

---

## 2-2. Phase 1: `#09` RP2040-Zero 単体への QMK ファームウェア書き込み

`#06` キャリア基板へハンダ付けする前に、`#09` RP2040-Zero 単体を USB-C ケーブルで PC に接続し、評価用 QMK ファームウェア（`curcur40_wheel_eval`）を書き込んで正常起動を確認します。

### ① ファームウェア（`.uf2`）のビルド
[`kbd_firmware/`](../kbd_firmware/) ディレクトリにて以下のコマンドを実行します：
```sh
cd kbd_firmware
kb=curcur40_wheel_eval make qmk-init
kb=curcur40_wheel_eval kr=rev1 km=default make qmk-compile
```
ビルドが完了すると `keyboards/curcur40_wheel_eval/qmk/qmk_firmware/.build/curcur40_wheel_eval_rev1_default.uf2` が生成されます。

### ② `#09` RP2040-Zero への書き込み
1. `#09` RP2040-Zero 上の小さな **`BOOT` ボタンを押したまま** PC に USB-C ケーブルを挿します（すでに接続中の場合は `BOOT` を押しながら `RESET` を1回押します）。
2. PC に **`RPI-RP2`** ドライブが表示されたら、生成された `.uf2` ファイルをドラッグ＆ドロップします。
3. 自動的に再起動し、HID マウス／キーボード複合デバイス **`curcur40 Inertia Wheel Eval Pod`** として認識されれば準備完了です（※本ファームウェアはセンサー未接続状態でもフリーズせず起動するよう設計されています）。

---

## 2-3. Phase 2: `#12` ベアリングの脱脂洗浄（★最重要ステップ）

> [!IMPORTANT]
> **新品の `#12` ベアリングをそのまま組まないでください！**
> 新品の `DDL-520` / `MR52` には防錆・高負荷用の粘度の高い油分・グリスが付着しており、**未脱脂のままだと粘性抵抗で弾いても1秒未満で止まってしまいます**。以下の脱脂を行うことで、空転持続時間が一気に **3〜7秒以上** へ劇的に伸びます。

1. **オープン形の準備**
   - 幅 $1.5\,\text{mm}$ のオープン形（シールドなし `DDL-520`）は最初からボールが露出しているため、そのまま手順2へ進みます。
2. **パーツクリーナー浸漬・回転洗浄**
   - ガラス小瓶や金属トレイに `#12` ベアリング2個を入れ、**速乾性ブレーキ＆パーツクリーナー** をベアリングが浸かるまで吹き付けます。
   - 液の中でピンセットや爪楊枝の先にベアリング内輪を通し、シャカシャカと軽く回して内部の油分・グリスを完全に溶かし出します。
   - 一度液を捨て、もう一度新しいパーツクリーナーを吹き付けて仕上げ洗いし、キッチンペーパーの上で **3〜5分間完全に乾燥** させます。
3. **空転チェック**
   - `#14` 回転シャフト（$\varnothing 2.0\,\text{mm}$）に `#12` ベアリングを通し、指で軽く弾いて「シャーッ」と抵抗なく軽やかに回り続ければ脱脂成功です（※オイルは差さないドライ状態が最も長く回ります）。

---

## 2-4. Phase 3: 基板のハンダ付け（`#07` センサー基板 ＆ `#06` キャリア基板）

### ① `#07` センサー基板（`curcur40-wheel-sensor`：PCBA 実装済・折って段付き $8.2/8.0 \times 9.40 \times 0.8\,\text{mm}$）
表面（`F.Cu`）の `#08` AS5600 IC（`U1`、回転軸と同軸配置）およびパスコン2個（`C1`, `C2`）はすべて JLCPCB PCBA で実装済みのため、**作業は4極スルーホール（`J1`）へのワイヤはんだ付けと外枠折り取りだけ** です。
1. **外枠を折る前に、4極スルーホールランド（`J1`, $\varnothing 0.65\,\text{mm}$ PTH）へ `#11` センサー6芯線の `1〜4番` をハンダ付け（★おすすめ！）**:
   - 外周の $22 \times 22\,\text{mm}$ 捨て基板枠が付いた状態のまま机に置くと、基板が大きくて動かないため非常にハンダ付けしやすくなります。
   - `#11` 片側ハウジング端子付き 6P ケーブルをコネクタ根元から約 `60〜75mm` の長さにカットし、裏面側（`B.Cu`：ICのない面）から $\varnothing 0.65\,\text{mm}$ スルーホールへ芯線を差し込むかランドに沿わせて、シルク表記（裏面を正面に見て左から順に **`4:SCL` / `3:SDA` / `2:GND` / `1:3V3`**、中央基板上にも `SCL`・`3V3` 刻印あり）に従い **`1〜4番線`** をハンダ付けします（銅箔剥離に強い両面PTHランド構造です。※残りの `5・6番線` は、単体評価ポッドでは `#06` 基板上でスイッチが内部結線されているため先端を絶縁して束ねておくか、将来キーボード本体 `rJ5` へ移植する際に `#10` 静音スイッチの2端子へ繋げるよう残しておくと便利です）。
2. **捨て基板枠（インセット `SNAP` マウスバイトタブ）の折り取り**:
   - 左右の `SNAP` タブ（基板内側へ $0.35\,\text{mm}$ インセット配置された3連小穴ミシン目のため、バリが出ても公称外幅 $8.20\,\text{mm}$ 以内に収まります）を指先またはニッパーでパキッと折り取り、中央の **段付き $8.20/8.00 \times 9.40\,\text{mm}$ センサー基板** を取り出します（上部 $2.80\,\text{mm}$ が幅 $8.00\,\text{mm}$ に絞られているため、キーボードメイン基板へ組み込む際にも `#20` ホイールカバーの内側へそのまま綺麗に収まります）。

### ② `#06` キャリア基板（`curcur40-wheel-eval`：$48.0 \times 32.0 \times 1.6\,\text{mm}$）
1. **`U1`: `#09` RP2040-Zero の実装（基板西側・端面実装／ピンヘッダ両対応）**:
   - USB-C コネクタが **西側外周（`-X` 側）** を向くように `#09` RP2040-Zero を `#06` キャリア基板表面のフットプリント上に載せます（中央に $17.20 \times 11.20\,\text{mm}$ の裏面部品逃がし窓が開いているため、ピンヘッダ無しでベタ置き密着実装しても裏面の `BOOT`/`RESET` 実装部品やICが干渉しません）。
   - 外側の端面キャスタレーションパッドへ直接ハンダ付けするか、付属の `2.54 mm` ピンヘッダを $\varnothing 0.85\,\text{mm}$ スルーホール穴へ通してハンダ付けして固定します。
2. **`SW1`: `#10` 静音スイッチの実装（基板東側モジュール枠内・南西コーナー）**:
   - モジュール枠内の南西位置（$(106.30, 105.70)$、`curcur40-right` 本体と同一向き）にある `SW1` スルーホール2穴（$\varnothing 1.10\,\text{mm}$ PTH）に、表面側から `#10` 静音スイッチを底面が基板に密着するまで差し込み、裏面で2ピンをハンダ付けします。
   - **足切り**: 裏面に飛び出したスイッチの足をハンダ山の上でニッパーで軽く整えます（`#05` ポッド台座内部には深さ $3.0\,\text{mm}$ の裏面クリアランス凹みがあります）。
3. **`#11` センサー6芯線の接続（JST SH コネクタ `J1` または 直結PTHパッド `J2`）**:
   - **方法A（着脱式：推奨）**: `#11` JST SH 6P プラグ（`Pin 1: +3V3`, `Pin 2: GND`, `Pin 3: SDA`, `Pin 4: SCL`）を、`#06` キャリア基板北側の `J1` コネクタへそのまま挿します。
   - **方法B（直結式）**: コネクタを使わずバラ線のみで試す場合は、`#06` キャリア基板中央にある4連スルーホールパッド **`J2`（$\varnothing 0.65\,\text{mm}$ PTH、`1: +3V3` / `2: GND` / `3: SDA` / `4: SCL`）** へそのままハンダ付けすることもできます。

| 信号名 | `#08` AS5600 IC ピン | `#07` センサー基板 `J1` | `#06` キャリア基板 `J1` / `J2` | `#09` RP2040-Zero ピン |
| :---: | :---: | :---: | :---: | :---: |
| **`+3V3`** | Pin 1 (`VDD5V`) & Pin 2 (`VDD3V3`) | Pad 1 | Pin 1 | `3V3` |
| **`GND`** | Pin 4 (`GND`) & Pin 8 (`DIR=GND`) | Pad 2 | Pin 2 ＆ Pin 6（スイッチリターン共通） | `GND` |
| **`SDA`** | Pin 6 (`SDA`) | Pad 3 | Pin 3（基板上 `R1 4.7kΩ` プルアップ済） | `GP4` (`I2C0 SDA`) |
| **`SCL`** | Pin 7 (`SCL`) | Pad 4 | Pin 4（基板上 `R2 4.7kΩ` プルアップ済） | `GP5` (`I2C0 SCL`) |
| **`SW_MID`** | ― | ― | Pin 5（基板上の `#10` `SW1` に内部接続済） | `GP6` (`MS_BTN3`) |

---

## 2-5. Phase 4: カップ内蔵ローター（`#01`＋`#02`）と `#03` キャリッジの組み立て

1. **`#02` 内蔵9球ハブへの `#13` ラチェット鋼球スナップイン圧入**
   - `#02` 内蔵9球ハブの片面にある9箇所の軸方向ポケット入口（$\varnothing 1.94\,\text{mm}$）に、**`#13` ラチェット鋼球（$\varnothing 2.00\,\text{mm}$）を9個** 順番に押し込みます。
   - 平らな机の上に `#02` ハブを置き、上から `#13` 鋼球を当てて硬い平らなもの（定規の腹など）でグッと押すと「パチン」とスナップイン保持されます。9個すべてが奥まで均等に収まっていることを確認します。
2. **`#01` カップ型フライホイール内部への `#02` 内蔵9球ハブ格納**
   - `#01` カップ型フライホイールの片面カップ凹部（内径 $\varnothing 12.50 \times$ 深さ $3.30\,\text{mm}$）の奥へ、**`#13` 鋼球が外向きになる向き** で `#02` 内蔵9球ハブを同軸に収めます（裏面に極少量の接着剤を点付けすると `#01` と完全一体ローターになります）。
   - `#02` ハブ端面が `#01` のステンレスリム端面よりわずかに奥（約 $0.12\,\text{mm}$ 内側）に収まり、**横や上から見たときに `#02` が完全に `#01` の中へ隠れている** ことを確認します。
3. **`#03` キャリッジへの脱脂済 `#12` ベアリング装着・内輪シムリング挿入・同軸組み付け**
   - `#03` キャリッジの左右のスリム丸耳にある $\varnothing 5.04\,\text{mm}$ 穴に、Phase 2 で脱脂した **`#12` ベアリングを左右1個ずつ** まっすぐ押し込みます。
   - `#03` キャリッジの中央空間に `#01`（`#02` 内蔵済：`#02` ハブ面を `#18` 調整ネジ穴がある側の耳へ向ける）と **`SUS304` 内輪シムリング（内径 `Ø2.0` × 外径 `Ø3.0 mm`：`0.2mm` `BRS002003020` ＋ `0.3mm` `BRS002003030`）** を保持し、横から **`#14` 回転シャフト（短い方のピン：$10\,\text{mm}$）** を **`[センサー側 #12 ベアリング] → [#01＋#02 一体ローター] → [0.2mm シム + 0.3mm シム（ドライのまま重ね通し）] → [調整ネジ側 #12 ベアリング]`** の順に通します（※シムはシャフトが中心を貫通するため接着剤は絶対に使わずドライのまま挟むだけです。もし3Dプリント個体差で2枚重ねが空転に少しきつい場合は `0.3mm` 1枚のみにします。`#12` ベアリング内部には絶対に接着剤を入れないこと！）。
4. **センサー側シャフト端への `#16` 角度磁石接着 ＆ `#07` センサー基板装着**
   - センサー側ベアリングから外へわずかに出た `#14` 回転シャフト端面に、**`#16` 角度磁石（径方向2極着磁 $\varnothing 4.0 \times 1.0\,\text{mm}$）** を同軸に接着します。
   - `#03` キャリッジの基板保持棚（南北Y方向の位置決めチークガイド付）に **`#07` センサー基板** を載せ、回転軸と同軸配置された `#08` AS5600 IC パッケージ表面が `#16` 角度磁石と公称 $0.59\,\text{mm}$ の非接触ギャップで正対する向き（IC面が内側＝磁石向き）で固定します。

---

## 2-6. Phase 5: `#04A` オンボードベース枠・`#05` ポッド台座への組み付けと `#18` 磁力調整

1. **`#06` キャリア基板への `#04A` オンボードベース枠固定（対角2点M2ネジ＋ナット締結）**
   - `#06` キャリア基板の東側（`#10` 静音スイッチが立っている側）に `#04A` オンボードベース枠を載せ、対角2箇所の固定耳（南東 `H5` $(117.35, 107.05)$・北西 `H6` $(104.00, 98.90)$）へ上から **`M2 × 6.0mm` ネジ 2本** を通し、基板裏面で **`M2` 六角ナット 2個** でしっかり締結します。
2. **`#15` ヒンジピン連結（`#03` キャリッジの組み付け：`curcur40-right` 本体と同一向き）**
   - `#04A` オンボードベース枠の上に Phase 4 で組んだ `#03` キャリッジ（ホイールコアユニット）を載せ（北＝ヒンジ側、東外周＝`#07` センサー基板側、西内側＝`#18` 磁力調整ネジ側、南西＝`#10` 静音スイッチ側）、北端のヒンジ穴に **`#15` ヒンジピン（長い方のピン：$16\,\text{mm}$）** を通して連結します。
   - `#01` カップ型フライホイール頂点を上から軽く押したとき、南西のストライカーが `#10` 静音スイッチを「コトッ」と静かにクリックし、指を離すとスイッチの復帰力で元の水平位置へ戻ることを確認します。
3. **`#05` ポッド台座への収納**
   - `#05` ポッド台座（全高 $7.6\,\text{mm}$）裏面の四隅にゴム足（`#19`）を貼り、上から `#06` キャリア基板を納めて四隅（`H1`〜`H4`）を **`M2 × 6.0mm` ネジ 4本**（台座側 $\varnothing 1.76\,\text{mm}$ セルフタップ盲穴）で固定します（西側の切り欠きに `#09` RP2040-Zero の USB-C ポートが揃います）。
4. **`#18` 磁力調整ネジによる「ノッチ感 ⇔ 慣性スピン持続時間」の無段階チューニング**
   - 先端に **`#17` ラチェット磁石**（二六製作所 `NE218` 軸方向着磁 $\varnothing 1.50 \times 1.50\,\text{mm}$）を吸着・点付け接着した **`#18` 磁力調整ネジ（`SUS304` `DIN916` `M2 × 4mm` イモネジ）** を、`#03` キャリッジ西側（`RP2040-Zero` 側）の丸耳支柱下部にある連続テーパーネジ穴（外入口 $\varnothing 1.82\,\text{mm} \to$ 内奥 $\varnothing 1.52\,\text{mm}$：万一接着が外れても `#17` 磁石がホイール側へ飛び出さない抜け止め構造）へ `0.9mm` 六角レンチでねじ込みます。
   - `#01` カップ型フライホイールを指で弾きながら `#18` 磁力調整ネジを少しずつ回してスイートスポットを探します：
     - **時計回りに締める（`#17` 磁石をカップ内部の `#13` 鋼球へ近づける）**: 1ノッチごとの「コツ、コツ」という磁気ラチェット感が強くなります（近づけすぎると `#13` 鋼球に接触するため、必ず非接触ギャップ $\ge 0.2\,\text{mm}$ を保ちます）。
     - **反時計回りに緩める（`#17` 磁石を離す）**: 弾いたときに「トトトトト…」という微振動を伴いながら **3〜7秒間スーーッと回り続け、指で触れればピタッと止まる** 理想のバランス点が見つかります。

---

## 2-7. Phase 6: PC 動作確認・分解能カスタマイズ・トラブルシューティング

### ① PC での動作確認
1. USB-C ケーブルを `#09` RP2040-Zero に挿し、ブラウザや長いコードエディタ画面を開いてテストします：
   - **1ノッチ送り**: ゆっくり回したとき、磁気ノッチに合わせて正確に上下スクロールすること。
   - **高速フリック慣性スクロール**: 指で弾いて離したあと、`#01` カップ型フライホイールが物理的に回り続けている間ずっと高速スクロールし続け、指の腹で触れて止めた瞬間にスクロールもピタッと止まること。
   - **静音ミドルクリック**: `#01` カップ型フライホイールを押し込んだときに中クリック（`MS_BTN3`）が反応し、かつ高速回転を指で軽く止めたときには誤クリックしないこと。
   - **水平スクロール**: キーボードの `Shift` キーを押しながら回すと水平スクロールに切り替わること。

### ② スクロール分解能・回転方向のカスタマイズ（[`config.h`](../kbd_firmware/keyboards/curcur40_wheel_eval/qmk/qmk_firmware/rev1/config.h)）
好みに応じて [`rev1/config.h`](../kbd_firmware/keyboards/curcur40_wheel_eval/qmk/qmk_firmware/rev1/config.h) の定数を変更して再ビルドできます：
* **`#define WHEEL_NOTCHES_PER_REV 18`**（既定値 `18`）：
  * `9` に設定：`#13` ラチェット鋼球9個の磁気デテント1山につき厳密に `1` スクロールステップを出力
  * `18` に設定（推奨）：一般的なマウスホイールと同等の $20.0^\circ$ 刻み（物理1山あたり `2` ステップ）
  * `36` に設定：`#01` カップ型フライホイール外周36フルートに一致する高密度ハイスピード出力（$10.0^\circ$ 刻み）
* **`#define WHEEL_INVERT_DIR 1`**（既定値 `1`：`rot180` 実装でホイールを手前へ引いたときに下スクロール）：スクロール上下方向を逆にしたい場合は `0` に変更します。

### ③ トラブルシューティング
| 症状 | 主な原因と対処法 |
| :--- | :--- |
| **ミドルクリックは効くが、ホイールを回してもスクロールしない** | 1. `#11` センサー配線（`1:3V3, 2:GND, 3:SDA, 4:SCL`）の並び順またはハンダ不良を確認。<br>2. `#16` 角度磁石が **径方向着磁（Diametric, `D4x1mm`）** になっているか、および `#08` AS5600 IC との距離が離れすぎていないか（推奨ギャップ $0.3 \sim 1.0\,\text{mm}$）確認。 |
| **弾いても1秒以内にすぐ止まってしまう** | 1. `#12` ベアリングのグリス脱脂が不十分な可能性大 → パーツクリーナーで再洗浄して完全乾燥させる。<br>2. `#18` 磁力調整ネジを締めすぎて `#17` ラチェット磁石が `#13` ラチェット鋼球に近すぎる／擦れている → 反時計回りに半回転〜1回転緩める。 |
| **手を離して静止しているのに 1ステップ勝手に動くことがある** | 磁気デテントの山の頂点付近に止まった際の微小揺れの場合、[`config.h`](../kbd_firmware/keyboards/curcur40_wheel_eval/qmk/qmk_firmware/rev1/config.h) の `WHEEL_DEADBAND_LSB` を `6` から `10`〜`12` に増やすと完全にピタッと静止します。 |

---

# 付録：キーボードメイン基板（沈み込み実装）へのコア移植手順

単体評価ポッドで好みの磁気ノッチ感（`#18` 磁力調整ネジ）が決まったら、完成済みの **ホイールコアユニット（`#03` キャリッジ一式）** を分解せずにそのまま `curcur40-right` 等の沈み込み対応メイン基板へ移植できます（機構詳細は [`passive_inertia_wheel_spec.md` 第4章](./passive_inertia_wheel_spec.md#4-キーボードメイン基板への組み込み最適化沈み込みフレームツインカバー) を参照）。

1. **コアユニットの取り外し**:
   北端の **`#15` ヒンジピン** を横に引き抜き、`#04A` オンボードベース枠から `#03` キャリッジ一式（`#01` ホイール・`#07` センサー基板・`#18` 調整ネジが付いた状態）を取り外します。
2. **`#04B` 沈み込みベース枠への載せ替え**:
   `#04B` 沈み込みベース枠（[`wheel-base-frame-sunk.step`](../cases/inertia_wheel/wheel-base-frame-sunk.step)）の南側スイッチポケット底面（基板実装時は南西側、ピッチ $5.00\,\text{mm}$ の $\varnothing 1.60\,\text{mm} \times 2$ ピン貫通穴付）へ `#10` 静音スイッチの2本の金属ピンを通して収め（底面下に出たピンにリード線2本をハンダ付け）、北端ヒンジ穴に再び **`#15` ヒンジピン** を通して `#03` キャリッジ一式を連結します。さらに、`#04B` の3箇所の固定フランジ（`W1`〜`W3`、肉厚 $2.40\,\text{mm}$、$\varnothing 2.40\,\text{mm}$ 穴）の上に**共通の M2 5.50mm メス-メス スペーサー 3個**を立て、下側から **`M2 × 4.0mm` ネジ 3本** で固定します。
3. **メイン基板・トッププレートへの3点スペーサー締結と `rJ5` コネクタ接続**:
   `curcur40-right` メイン基板の裏側（`B.Cu`）から $18.50 \times 18.50\,\text{mm}$ 内窓へコアユニットを通し、`#04B` 上の3本の M2 5.50mm スペーサーをメイン基板の $\varnothing 3.30\,\text{mm}$ 穴（`W1`〜`W3`）へ貫通させて右トッププレート裏面（$Z = -3.60\,\text{mm}$）を受け止め、トッププレート上から **`M2 × 4.0mm` ネジ 3本**（上下計6本）で固定します。`#11` センサー4芯線（`Pin 1:+3V3R, Pin 2:GNDR, Pin 3:/WHEEL_SDA, Pin 4:/WHEEL_SCL`）と `#10` スイッチ2線（`Pin 5:/KEYEX1, Pin 6:GNDR`）をまとめた 6ピン JST SH プラグを、右メイン基板裏面の西向きコネクタ **`rJ5`** へそのまま差し込んで動作確認を行います（キーボード全体の組み立て手順は [`docs/buildguide_jp.md`](./buildguide_jp.md) を参照）。
4. **`#20` ツインスナップカバーのワンタッチ装着**:
   最後にトッププレートの上から、**`#20` ホイールカバー（[`wheel-cover.step`](../cases/inertia_wheel/wheel-cover.step)）× 2個**（片方は水平面内で $180^\circ$ 回転）をホイールの東西両側スリットへキースイッチのようにまっすぐ押し込みます。「カチッ」とスナップ爪がプレート裏面に掛かり、`#07` センサー基板と軸受丸耳が完全に目隠しされて完成です。
