oktntko/curcur40/docs/wheel_mechanism_guide.html

🎡 さわってわかる！curcur40 高速スクロールホイールの3つのしくみ

① 高速回転と #02 の場所 ② カリカリ感（ノッチ）調整 ③ シーソー式ミドルクリック

👆 指でホイールを「シュッ！」と弾く

小学生向けのたとえ： ズッシリ重い鉄のコマ（#01 幅6.5mm・19.3g）が2個のベアリング（#07）の上でツルツル回ります。細い軸（2mm）の先に直接4mm磁石は貼れないため、#02 プラスチックのキャップを軸先（Dカット）にギュッと差し込んで磁石（#08）を抱え、左側の抜け止め壁でガードしながら、基板裏のコンパス（#05）が空中で回転を読み取ります。

ゆるめる(ツルツル) しめる(カリカリ)

🔄 1カチッ回す

ポイント： 小さな磁石（#09）は鉄のホイールに一番近い「山」を磁力で引っ張ります。だから山が通るたびに触っていないのに「コトン・コトン」と1周24回止まりたがる力が生まれ、ネジ（#11）を回して距離を変えるだけで強さを自由に変えられます！

👇 ここを押してみて！（ミドルクリック）

抜けないヒンジで安心クリック： ロッカー（#03）の丸い支点軸は、#04 クレードルのCクリップ軸受け（239°抱え込み）に上から「パチン！」とハメ込む機械連結になっています。だから外れたりズレたりせず、右のホイールを少し（0.31mm）下に押したときだけシーソーの左端がグイッと上がって基板裏のスイッチ（#06）をポチッと押します！
