oktntko/curcur40/docs/carrying_box_lid_guide.html

🔍 まっすぐ引っぱるだけでフタが抜ける「3つのひみつ」図解

お部屋のドアの三角ラッチ金具や、長いプラスチック定規とまったく同じしくみで動きます

✅ 採用設計（スッと抜ける） ❌ NG例（抜けない理由）

▶ うごかしてみる

閉 開

🔒 カチッと閉まっている（逆さでも開かない）

### ① すべり台（坂道 26°）で力の向きが変わる

引っかかりが直角の壁ではなくなだらかな26°の坂道になっています。フタを前に引っぱると、坂道がツメを勝手に内側のにげ場所へ押し上げるため、人間が横からツメを押してあげる必要がありません。

### ② 「長い定規」みたいに軽くしなる

定規は短く持つと固くて曲がりませんが、長く持つと指1本でしなります。ツメのうでを14mmまで長くし、裏側に0.85mmのにげ場所を作ったので、坂道の力だけで無理なくペコッと曲がって通り抜けます。

### ③ 「牛乳パック1本分（約1kg）」の絶妙な重さ

中身のキーボード2枚は約350gしかないので、カバンの中で逆さまになっても約1kgのブレーキは勝手に開きません。一方で、人間が横の指かけミゾ（深さ1.2mm）をつまんで引くときは片手でスッと抜けます。

📐 実寸エンジニアリング仕様（carrying-box-lid.step / PA12 ナイロン）: 自由梁長 L = 14.0 mm ／ 梁厚 t = 1.85 mm ／ 梁幅 b = 9.5 mm ／ 掛かり代 δ = 0.50 mm（背面逃げ隙間 0.85 mm） ／ 抜きカム角 α_out = 26.0°（押し込み角 20.0°） ／ 真っ直ぐ引き抜き力 9.73 N (0.99 kgf)・押し込み力 6.35 N (0.65 kgf) ／ 根元最大曲げひずみ 0.71%（PA12 弾性限界 3.50% に対し安全率 4.94倍）
