oktntko/curcur40/docs/curcur40/buildguide_jp.md

# curcur40 ビルドガイド

**curcur40** は、Corne Chocolate v4 をベースに全キー 1u 化（計40キー：左21キー＋右19キー）、右手人差し指内側に水平スクロールエンコーダ（**CKW12**）、右手親指上部に **25mm トラックボール（PMW3360DM-T2QU 光学センサーシングルボード統合）** を搭載した左右分割型ロープロファイルキーボードです。

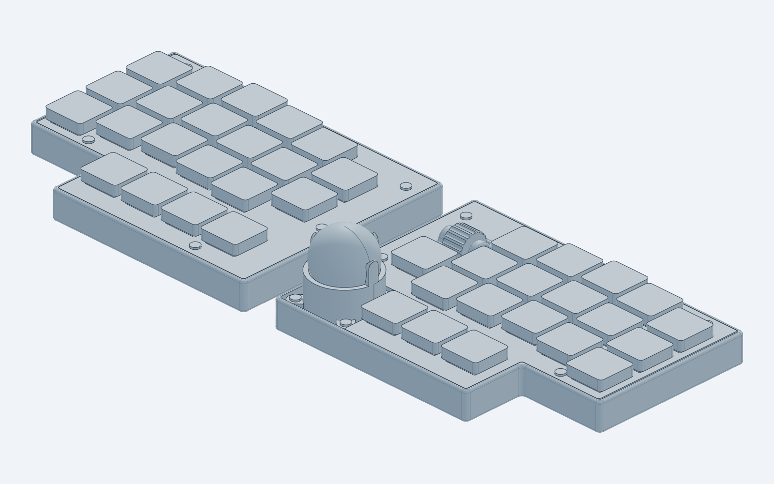
[picture p100: docs/curcur40/assets/render_full_assembly_iso.png]
curcur40 全体プレビュー（斜視）


| 上面ビュー（トッププレート・キー配列） | 底面ビュー（13箇所ザグリ穴・ケース底面） |
| :---: | :---: |
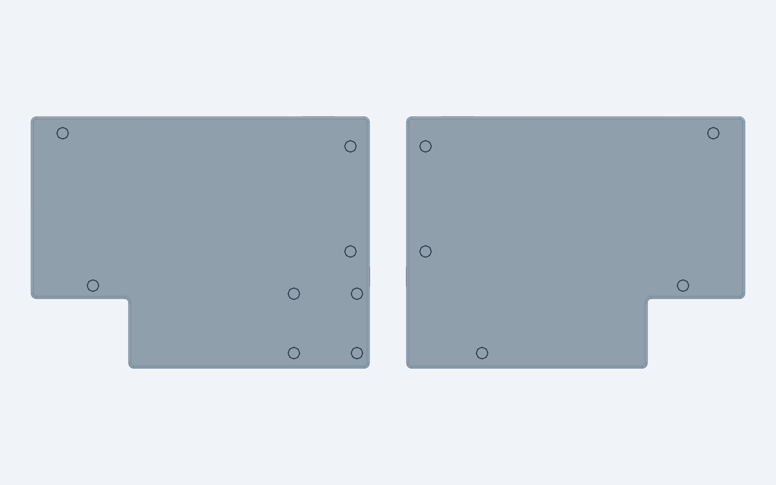
[picture p101: docs/curcur40/assets/render_full_assembly_bottom.png]
curcur40 底面プレビュー
| curcur40 上面プレビュー |  |

---

## 目次

- **[Step 1: 資材一覧と入手経路・発注ガイド](#step-1-資材一覧と入手経路発注ガイド)**
  - [1-1. 全体構成の概要](#1-1-全体構成の概要)
  - [1-2. JLCPCB に発注するもの（PCB / PCBA / トッププレート）](#1-2-jlcpcb-に発注するものpcb--pcba--トッププレート)
  - [1-3. JLC3DP に発注するもの（3Dプリント造形）](#1-3-jlc3dp-に発注するもの3dプリント造形)
  - [1-4. 別で入手・購入するパーツ一覧](#1-4-別で入手購入するパーツ一覧)
  - [1-5. 発注前チェックリスト](#1-5-発注前チェックリスト)
- **[Step 2: 組み立て・ハンダ付け・ファームウェア書き込み手順](#step-2-組み立てハンダ付けファームウェア書き込み手順)**
  - [2-1. 必要な工具](#2-1-必要な工具)
  - [2-2. Phase 1: ファームウェアのビルドと書き込み（事前動作確認）](#2-2-phase-1-ファームウェアのビルドと書き込み事前動作確認)
  - [2-3. Phase 2: 手ハンダ作業（右メイン基板：PMW3360 ＆ CKW12）](#2-3-phase-2-手ハンダ作業右メイン基板pmw3360--ckw12)
  - [2-4. Phase 3: トラックボールカップの準備（支持球圧入）](#2-4-phase-3-トラックボールカップの準備支持球圧入)
  - [2-5. Phase 4: スペーサー・トッププレート・ケースの組み立て](#2-5-phase-4-スペーサートッププレートケースの組み立て)
  - [2-6. Phase 5: 動作確認・キーマップ設定（VIA / Vial）](#2-6-phase-5-動作確認キーマップ設定via--vial)
  - [2-7. トラブルシューティング・注意事項](#2-7-トラブルシューティング注意事項)

---

# Step 1: 資材一覧と入手経路・発注ガイド

## 1-1. 全体構成の概要

curcur40 を1台組み立てるために必要な資材は、以下の **3つのルート** で揃えます。

1. **JLCPCB への発注（メイン基板 PCBA × 2種 ＋ FR-4 トッププレート × 2種）**
   - 左右メイン基板（`curcur40-left`, `curcur40-right`）は、マイコン（RP2040）、Flash メモリ、Kailh Choc ホットスワップソケット、RGB LED、USB-C、TRRS ジャック、および右手側の PMW3360 周辺 SMD 部品（1.8V LDO `TLV74318PDBVR`、コンデンサ・抵抗類）まで **すべて1枚の基板裏面に PCBA 実装** されるシングルボード統合設計です。
2. **JLC3DP への発注（3Dプリントケース × 2種 ＋ トラックボールカップ × 1種）**
   - 左右の専用トレイ型ボトムケースと、25mm トラックボールを保持する専用カップを 3D プリントで造形します。
3. **別途購入するパーツ（スイッチ、キーキャップ、PMW3360IC＋レンズ、トラックボール球、CKW12、M2スペーサー・ネジ類）**
   - PCBA で実装されない手ハンダ部品（右メイン基板の `PMW3360DM-T2QU` 光学センサーIC と `CKW12` エンコーダのみ）と、組み立て用の機構部品・外装パーツを国内ショップや通販で揃えます。

---

## 1-2. JLCPCB に発注するもの（PCB / PCBA / トッププレート）

JLCPCB（[https://jlcpcb.com/](https://jlcpcb.com/)）には、**PCBA 付きメイン基板 2種** と **PCB のみ（FR-4 トッププレート）2種** の **計4アイテム** を発注します。

### 発注ファイル一覧

| 対象 | 発注種別 | 最小発注数 | ガーバーファイル (ZIP) | BOM (部品表 CSV) | CPL (座標データ CSV) |
| :--- | :---: | :---: | :--- | :--- | :--- |
| **① 左メイン基板**<br>(`curcur40-left`) | **PCB + PCBA**<br>（裏面 `B.Cu` 実装） | 5枚<br>（PCBAは2枚〜可） | [GERBER-curcur40-left.zip](../../pcbs/curcur40/left/jlcpcb/production_files/GERBER-curcur40-left.zip) | [BOM-curcur40-left.csv](../../pcbs/curcur40/left/jlcpcb/production_files/BOM-curcur40-left.csv) | [CPL-curcur40-left.csv](../../pcbs/curcur40/left/jlcpcb/production_files/CPL-curcur40-left.csv) |
| **② 右メイン基板**<br>(`curcur40-right`) | **PCB + PCBA**<br>（裏面 `B.Cu` 実装） | 5枚<br>（PCBAは2枚〜可） | [GERBER-curcur40-right.zip](../../pcbs/curcur40/right/jlcpcb/production_files/GERBER-curcur40-right.zip) | [BOM-curcur40-right.csv](../../pcbs/curcur40/right/jlcpcb/production_files/BOM-curcur40-right.csv) | [CPL-curcur40-right.csv](../../pcbs/curcur40/right/jlcpcb/production_files/CPL-curcur40-right.csv) |
| **③ 左トッププレート**<br>(`plate-top-left`) | **PCB のみ**<br>（FR-4 1.6mm） | 5枚 | [GERBER-plate-top-left.zip](../../plates/curcur40/pcb/jlcpcb/production_files/GERBER-plate-top-left.zip) | 不要（PCBAなし） | 不要（PCBAなし） |
| **④ 右トッププレート**<br>(`plate-top-right`) | **PCB のみ**<br>（FR-4 1.6mm） | 5枚 | [GERBER-plate-top-right.zip](../../plates/curcur40/pcb/jlcpcb/production_files/GERBER-plate-top-right.zip) | 不要（PCBAなし） | 不要（PCBAなし） |

> **補足（トッププレートおよびレーザーカット用 SVG について）**:
> - **トッププレートの仕様**:
>   - 板厚 $1.60\text{ mm}$ の FR-4 基板として製造します。ネジ穴（左手 5箇所、右手 4箇所）はすべて **$\varnothing 2.40\text{ mm}$ ストレート貫通穴（ザグリ加工不要）** です。
>   - ボトムプレートは 3D プリント製トレイ型ボトムケース（`cases/curcur40/left.step`, `right.step`）に統合されたため不要です。
>   - アクリル等のレーザーカットでトッププレートやスイッチポロンフォームを製作する場合は、[plate-curcur40.svg](../../plates/curcur40/svg/plate-curcur40.svg) および [foam-curcur40.svg](../../plates/curcur40/svg/foam-curcur40.svg) を使用できます。

### JLCPCB 推奨発注オプション

- **Base Material**: `FR-4`
- **Layers**: `2 Layers`
- **PCB Thickness**: **`1.6 mm`**（左右メイン基板・左右トッププレートすべて `1.6 mm`）
- **PCB Color**: お好みの色（`Black` / `Matte Black` / `White` など）
- **Surface Finish**: `HASL(with lead)` または `LeadFree HASL` / `ENIG`
- **Remove Order Number**: **`Specify a location`** または **`Yes`（有料オプション）** ※特にトッププレートは表面に製造番号が入らないよう `Remove Order Number: Yes` を推奨します。
- **PCBA Assembly Side**:
  - 左メイン基板 (`curcur40-left`)：**`Bottom Side`**（78点実装 / 21 BOMグループ）
  - 右メイン基板 (`curcur40-right`)：**`Bottom Side`**（82点実装 / 27 BOMグループ）
- **PCBA 実装内容と未実装（DNP / 手ハンダ）部品の確認**:
  - 左右メイン基板には RP2040 マイコン、Flash メモリ、水晶振動子、3.3V LDO、Kailh Choc ホットスワップソケット（左21個・右19個）、ダイオード、RGB LED、USB Type-C コネクタ、TRRS ジャック、RESET/BOOT タクトスイッチ（`SMDSW1`/`SMDSW2`, `rSMDSW1`/`rSMDSW2`）、および右手 PMW3360 回路の 1.8V LDO（`U2`: TLV74318PDBVR）と受動部品（`C1`〜`C4`, `R1`〜`R3`）がすべて実装されます。
  - 以下の部品は意図的に PCBA（BOM/CPL）から除外されています（JLCPCB のプレビュー画面で Unplaced となっても正常です）：
    - **手ハンダ部品**: 右メイン基板の **`U1`（PMW3360DM-T2QU）** および **`rEXSW1`（CKW12 エンコーダ）**
    - **基板内パターン直結済みジャンパ**: 右メイン基板の **`JP1`（`SolderJumper_3_Bridged12`：Pad 1–2 間が銅箔パターンで直結済み）**
    - **DNP（未実装）部品**: 右メイン基板の **`R4`（28kΩ）**・**`C5`（22nF）**（LDO TLV74318 採用に伴い不要）、および左右の予備端子 **`J4` / `rJ4`**

---

## 1-3. JLC3DP に発注するもの（3Dプリント造形）

JLC3DP（[https://jlc3dp.com/](https://jlc3dp.com/)）または手持ちの 3D プリンタで、以下の **3つのパーツ** を造形します（JLC3DP へは曲面精度の高い `.step` ファイルのアップロードを推奨します）。

| 対象パーツ | 数量 | アップロード用ファイル (STEP 推奨) | STL ファイル（スライサー用） | 推奨素材・方式 |
| :--- | :---: | :--- | :--- | :--- |
| **① 左手用ボトムケース** | **1個** | [left.step](../../cases/curcur40/left.step) | [left.stl](../../cases/curcur40/left.stl) | **MJF (PA12 ナイロン)** / **SLS (PA12)**<br>または **SLA (タフレジン / Black Resin)** |
| **② 右手用ボトムケース** | **1個** | [right.step](../../cases/curcur40/right.step) | [right.stl](../../cases/curcur40/right.stl) | **MJF (PA12 ナイロン)** / **SLS (PA12)**<br>または **SLA (タフレジン / Black Resin)** |
| **③ 25mm トラックボールカップ** | **1個** | [trackball-cup.step](../../cases/curcur40/trackball-cup.step) | [trackball-cup.stl](../../cases/curcur40/trackball-cup.stl) | **SLA (高精細レジン)** または **MJF (PA12)**<br>※直径2mm支持球を圧入するため寸法精度の高い方式を推奨 |

> **💡 ケースの設計特徴（フラット内底面 ＆ 13箇所底面ザグリ）**:
> - 左右ケースは底面肉厚 **$3.20\text{ mm}$**（外底面 $Z = -12.30\text{ mm}$、内底面 $Z = -9.10\text{ mm}$）、内底面ボス突起ゼロの完全フラット構造です。
> - ケース底面外側の全 13箇所（左手 5箇所 ＋ 右手外周 4箇所 ＋ トラックボール固定 4箇所）には **$\varnothing 4.60\text{ mm}$ × 深さ $0.90\text{ mm}$ の円筒ザグリ** が設けられており、M2 × 4mm ネジ頭（厚さ $0.80\text{ mm}$）がケース底面から突出せず $0.10\text{ mm}$ 奥に収まります（リセス構造）。

> **オプション（CKW12 の 3D プリントパーツを自前で造形する場合）**:
> 「CKW12 キット」を Booth で購入する場合は、キット内に 3D プリントパーツが含まれているため発注不要です。電子部品のみを個別購入して自作する場合は、[pcbs/common/kbd/3dmodels/](../../pcbs/common/kbd/3dmodels/) 内の以下の3ファイル（または本家 [kumamuk-git/CKW12](https://github.com/kumamuk-git/CKW12) のデータ）を SLA レジン等で造形してください。
> - ハウジング: [ckw12_housing.stp](../../pcbs/common/kbd/3dmodels/ckw12_housing.stp) × 1個
> - ホイール: [ckw12_wheel.stp](../../pcbs/common/kbd/3dmodels/ckw12_wheel.stp) × 1個
> - ステム: [ckw12_stem.stp](../../pcbs/common/kbd/3dmodels/ckw12_stem.stp) × 1個

---

## 1-4. 別で入手・購入するパーツ一覧

JLCPCB / JLC3DP 以外で、キーボードショップ・電子部品通販・Amazon 等から入手するパーツの一覧です。

### キースイッチ・キーキャップ

| 品名 | 必要数 | 仕様・備考 | 主な入手先 |
| :--- | :---: | :--- | :--- |
| **Kailh Choc V1 / V2 キースイッチ** | **40個** | 左手21個 ＋ 右手19個。<br>Kailh Choc V1 または Choc V2 ロープロファイルスイッチに対応。 | 遊舎工房 / Talp Keyboard / Daily Craft Keyboard / AliExpress 等 |
| **Choc 用 1u キーキャップ** | **40個** | **全キー 1u サイズ（40個）** です。<br>※選ぶスイッチ（Choc V1 / Choc V2）に適合するロープロファイルキーキャップを用意してください。 | 遊舎工房 / Booth / Talp Keyboard / AliExpress 等 |

### 右手スクロールエンコーダ（CKW12）関連

右手人差し指内側（`rEXSW1`）に搭載する水平ロータリーエンコーダです。**方法A（キット購入）** が最も簡単で確実です。

#### 方法A：キットを購入する場合（推奨）
| 品名 | 必要数 | 仕様・備考 | 主な入手先 |
| :--- | :---: | :--- | :--- |
| **CKW12 水平ロータリーエンコーダキット** | **1セット** | エンコーダ、タクトスイッチ、コンスルーピン（5本）、M2皿ネジ、3Dプリントパーツ一式がすべて揃ったキット。 | Booth（[kumamuk 氏のショップ](https://kumamuk.booth.pm/items/5487792)） |

#### 方法B：部品を個別に揃える場合（キット在庫切れ時など）
| 品名 | 必要数 | 型番・仕様 | 主な入手先 |
| :--- | :---: | :--- | :--- |
| **中空軸ロータリーエンコーダ** | **1個** | Alps Alpine **`EC05E1220202`** | 秋月電子 / Mouser / DigiKey |
| **横押しタクトスイッチ** | **1個** | Alps Alpine **`SKQYACE010`**（または `SKQGAFE010`） | Mouser / DigiKey / AliExpress |
| **コンスルー（スプリングピンヘッダ）** | **5ピン分** | 2.54mmピッチ、高さ 2.0mm または 2.5mm（12ピン等をニッパーで1ピンずつ5個に切り分けて使用） | 遊舎工房 / 千石電商 / 秋月電子 |
| **M2 皿ネジ（CKW12固定用）** | **2本** | M2 × 長さ 3mm〜4mm（基板裏側からCKW12ハウジングへネジ止め） | ホームセンター / Amazon / モノタロウ |

### 右手トラックボール・PMW3360 センサー関連

| 品名 | 必要数 | 仕様・備考 | 主な入手先 |
| :--- | :---: | :--- | :--- |
| **25mm トラックボール球** | **1個** | 直径 **25mm** のトラックボール交換球。<br>定番は **Perixx（ペリックス）PERIPRO-303 25mm**、または Keyball / killerwhale 用 25mm 球。 | Amazon（Perixx公式）/ 遊舎工房 / Booth |
| **直径 2.0mm（$\varnothing 2.0\text{ mm}$）支持球** | **3個** | `trackball-cup` 内部の3つのくぼみに圧入してトラックボールを滑らかに支えるベアリング球。<br>**$\varnothing 2.0\text{ mm}$ セラミック球（$\text{ZrO}_2$ ジルコニア または $\text{Si}_3\text{N}_4$ 窒化ケイ素）** または高精密ステンレス球。 | Amazon / モノタロウ / AliExpress / Booth |
| **PMW3360DM-T2QU センサーIC ＋ レンズ（LM19-LSI）** | **1セット** | 光学センサー IC 本体（16-pin DIP）と専用レンズ（`LM19-LSI`）のセット。右メイン基板（`curcur40-right`）の `U1` に直接実装します。<br>※旧設計で必要だった6ピンヘッダや `JP1` のハンダブリッジは、シングルボード統合＆基板内パターン直結化により**不要**になりました。 | AliExpress / Tindie / Booth |

### ネジ・スペーサー・ゴム足・ケーブル類（13箇所統一スタックアップ）

curcur40 は **全 13箇所（左手外周 5箇所 ＋ 右手外周 4箇所 ＋ トラックボールカップ固定耳 4箇所）すべてに同一規格の M2 5.50mm メス-メス スペーサーと M2 × 4.0mm ネジ** を使用する統一締結構造を採用しています。

| 品名 | 必要数 | 仕様・備考 | 主な入手先 |
| :--- | :---: | :--- | :--- |
| **M2 メス-メス スペーサー（長さ 5.50mm）** | **13個** | **左手 5個 ＋ 右手外周 4個 ＋ トラックボールカップ部 4個 ＝ 計 13個**。<br>外径 $\varnothing 3.0\text{ mm}$（丸型中空スペーサー推奨）。ケース内底面（$Z = -9.10\text{ mm}$）に立ち、メイン基板の $\varnothing 3.60\text{ mm}$ 貫通穴を通って基板上面（F.Cu, $Z = -3.60\text{ mm}$）と完全にツライチになります。 | 遊舎工房 / Hirosugi-Net（廣杉計器）/ Amazon / AliExpress |
| **M2 × 4.0mm ネジ** | **26本** | **底面側 13本 ＋ 上面側 13本 ＝ 計 26本**（頭径 $\varnothing 4.0\text{ mm}$ 以下の精密低頭ネジまたはなべ頭ネジ、頭厚 $0.80\text{ mm}$ 以下推奨）。<br>・底面側 13本：ケース底面ザグリ穴（残肉厚 $2.30\text{ mm}$）を通ってスペーサー下端に $1.70\text{ mm}$ 噛み合います。<br>・上面側 9本（外周）：トッププレート（$1.60\text{ mm}$）から $2.00\text{ mm}$ ギャップを渡りスペーサー上端に $0.40\text{ mm}$（4.5〜5.0mmネジなら $0.9\sim 1.4\text{ mm}$）噛み合います。<br>・上面側 4本（カップ耳）：カップ固定耳（厚さ $2.40\text{ mm}$）を通ってスペーサー上端に $1.60\text{ mm}$ 噛み合います。 | 遊舎工房 / Amazon / モノタロウ / 秋月電子 |
| **ゴム足（クッションゴム）** | **8〜10個** | 直径 6mm〜8mm、厚み 1.5mm〜2mm 程度の貼り付け式ゴム足（左右ケース底面の四隅＋トラックボール下部に貼付）。 | Amazon / 100円ショップ / ホームセンター |
| **TRRS ケーブル（4極・3.5mm）** | **1本** | 左右分割キーボード間を接続するケーブル。<br>⚠️ **必ず「4極（TRRS）」を使用してください（3極 TRS ケーブルは +3.3V と GND がショートするため使用不可）。** | 遊舎工房 / Amazon |
| **USB Type-C ケーブル** | **1本** | PC との接続用（データ通信対応のもの）。 | Amazon / 家電量販店 |

---

## 1-5. 発注前チェックリスト

- [ ] **JLCPCB（計4アイテム）**:
  - [ ] `curcur40-left`（PCB + PCBA / Bottom実装 / 1.6mm）
  - [ ] `curcur40-right`（PCB + PCBA / Bottom実装 / 1.6mm）
  - [ ] `plate-top-left`（PCBのみ / 1.6mm / 注文番号削除推奨）
  - [ ] `plate-top-right`（PCBのみ / 1.6mm / 注文番号削除推奨）
- [ ] **JLC3DP（計3アイテム）**:
  - [ ] `left.step` × 1（底面肉厚 3.2mm / 5箇所 $\varnothing 4.6\times 0.9\text{ mm}$ ザグリ付き）
  - [ ] `right.step` × 1（底面肉厚 3.2mm / 8箇所 $\varnothing 4.6\times 0.9\text{ mm}$ ザグリ付き）
  - [ ] `trackball-cup.step` × 1（3爪スリムアーチ保持 / 4箇所固定耳 $\varnothing 3.6\text{ mm}$ 穴）
- [ ] **別調達パーツ**:
  - [ ] Kailh Choc スイッチ × 40個 ＆ 1u キーキャップ × 40個
  - [ ] CKW12 キット × 1セット
  - [ ] 25mm トラックボール球 × 1個 ＆ $\varnothing 2.0\text{ mm}$ 支持球 × 3個
  - [ ] PMW3360DM-T2QU センサーIC ＋ LM19-LSI レンズ × 1セット
  - [ ] M2 メス-メス スペーサー（5.50mm, 外径 3.0mm）× 13個、M2 × 4.0mm ネジ × 26本、ゴム足
  - [ ] 4極 TRRS ケーブル × 1本 ＆ USB-C ケーブル × 1本

---
---

# Step 2: 組み立て・ハンダ付け・ファームウェア書き込み手順

ここからは、届いた基板とパーツを使って **curcur40** を完成させるまでの手順をステップバイステップで解説します。

## 2-1. 必要な工具

| 工具名 | 用途・推奨スペック |
| :--- | :--- |
| **ハンダごて** | 温度調節機能付き推奨（設定目安：鉛入りハンダ 320℃ / 鉛フリーハンダ 350℃）。 |
| **ハンダ** | ヤニ入りハンダ（太さ $\varnothing 0.6\text{ mm} \sim 0.8\text{ mm}$ 推奨）。 |
| **ピンセット** | 2mmセラミック支持球の配置や保護テープ剥がしに使います。 |
| **ニッパー** | コンスルーピンの切り分けに使います。 |
| **精密ドライバー** | M2 ネジ用のプラスドライバー（`#0` または `#00`）。 |

---

## 2-2. Phase 1: ファームウェアのビルドと書き込み（事前動作確認）

ハンダ付けやケースへの組み込みを始める前に、JLCPCB から届いた左右のメイン基板（`curcur40-left`, `curcur40-right`）単体で PC に接続し、ファームウェアの書き込みと初期動作確認を行います。

### ① ファームウェア（`.uf2`）のビルド

本リポジトリの [`kbd_firmware/`](../../kbd_firmware/) ディレクトリには、**VIA（QMK）版** と **Vial 版** の両方のファームウェア定義が含まれています。トラックボール用のマウスボタンやエンコーダ設定を専用アプリから即座に変更できる **Vial 版** が特におすすめです。

#### A. Vial 対応ファームウェアをビルドする場合（推奨）
```sh
FIRMWARE=./curcur40/kbd_firmware
VIAL_QMK=./vial-qmk

# 基板定義とVialキーマップをVial-QMKのkeyboardツリーへコピー
mkdir -p "$VIAL_QMK/keyboards/curcur40/rev1/keymaps/vial"
cp -a "$FIRMWARE/keyboards/curcur40/qmk/qmk_firmware/rev1/." \
  "$VIAL_QMK/keyboards/curcur40/rev1/"
cp -a "$FIRMWARE/keyboards/curcur40/vial-kb/vial-qmk/keymaps/vial/." \
  "$VIAL_QMK/keyboards/curcur40/rev1/keymaps/vial/"

# Vial-QMKのDockerビルドを実行
cd "$VIAL_QMK"
util/docker_build.sh curcur40/rev1:vial
```
ビルドが完了すると、`$VIAL_QMK/.build/curcur40_rev1_vial.uf2` に `.uf2` ファイルが出力されます。左右のメイン基板には同じファイルを書き込みます。

#### B. VIA（標準 QMK）対応ファームウェアをビルドする場合
```sh
FIRMWARE=./curcur40/kbd_firmware
QMK_FIRMWARE=./qmk_firmware

# 基板定義とVIAキーマップをQMKのkeyboardツリーへコピー
mkdir -p "$QMK_FIRMWARE/keyboards/curcur40/rev1/keymaps/via"
cp -a "$FIRMWARE/keyboards/curcur40/qmk/qmk_firmware/rev1/." \
  "$QMK_FIRMWARE/keyboards/curcur40/rev1/"
cp -a "$FIRMWARE/keyboards/curcur40/qmk/qmk_firmware/keymaps/via/." \
  "$QMK_FIRMWARE/keyboards/curcur40/rev1/keymaps/via/"

# QMKのDockerビルドを実行
cd "$QMK_FIRMWARE"
SKIP_FLASHING_SUPPORT=1 util/docker_build.sh curcur40/rev1:via
```
ビルドが完了すると、`$QMK_FIRMWARE/.build/curcur40_rev1_via.uf2` に `.uf2` ファイルが出力されます。

---

### ② 左右メイン基板への書き込み手順

左手基板（`curcur40-left`）と右手基板（`curcur40-right`）の **両方** に、同じ `.uf2` ファイルを以下の手順で書き込みます。

1. **ブートローダーモードで接続する**
   - まだ TRRS ケーブルは繋がず、片方の基板だけを手元に置きます。
   - 基板裏面（部品実装面 `B.Cu`）にあるタクトスイッチ **`BOOT`（左手は `SMDSW1`、右手は `rSMDSW1`）を押したまま**、USB Type-C ケーブルを PC に接続します。
   - （※すでに USB 接続している場合は、`BOOT` を押しながら隣の `RESET`（`SMDSW2` / `rSMDSW2`）を1回押して離すか、`RESET` ボタンを素早く2回ダブルタップするとブートローダーに入ります。）
2. **`RPI-RP2` ドライブへのコピー**
   - PC 上に **`RPI-RP2`** という名前の USB ストレージが認識されます。
   - ビルドした `.uf2` ファイル（`curcur40_rev1_vial.uf2` または `curcur40_rev1_via.uf2`）を `RPI-RP2` ドライブへドラッグ＆ドロップします。
3. **自動再起動と認識確認**
   - コピーが完了すると自動的にドライブがアンマウントされ、キーボード（`curcur40`）として認識され、RGB LED が点灯します。
   - USB ケーブルを抜き、**もう片方の基板にもまったく同じ手順で `.uf2` を書き込みます**。

---

## 2-3. Phase 2: 手ハンダ作業（右メイン基板：PMW3360 ＆ CKW12）

> 💡 **左手メイン基板（`curcur40-left`）について**:
> 左手基板はすべての部品が JLCPCB の PCBA で実装されているため、**左手基板へのハンダ付け作業は一切ありません**。

手ハンダが必要なのは **右メイン基板（`curcur40-right`）の 2部品（① `U1`: PMW3360DM-T2QU 光学センサー、② `rEXSW1`: CKW12 エンコーダ）のみ** です。

---

### Step 2-3-1: 右メイン基板（`curcur40-right`）への PMW3360 センサーIC ＆ LM19-LSI レンズの取り付け

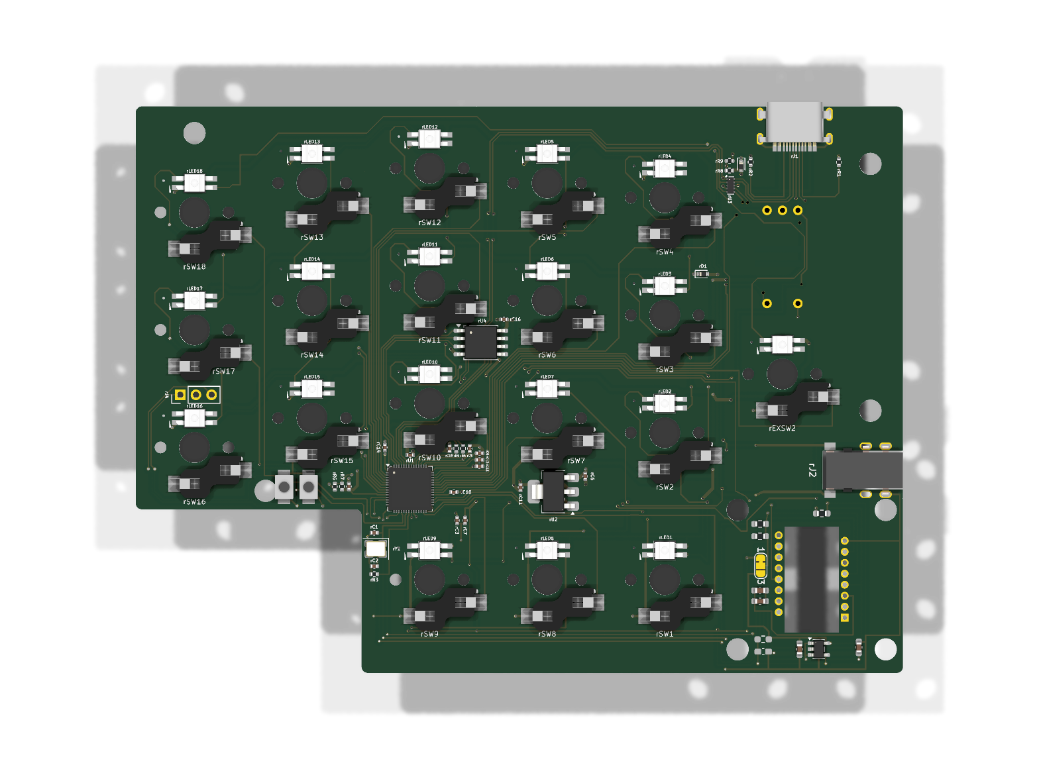
[picture p102: docs/curcur40/assets/render_right_bottom.png]
右手基板裏面プレビュー


以下の図に沿って、裏面（`B.Cu`）からのセンサー IC 挿入、表面（`F.Cu`）での16ピンはんだ付け、表面（`F.Cu`）からのレンズ装着を順に行います。

右手メイン基板のPMW3360実装手順

1. **電圧選択ジャンパ `JP1` の確認（ハンダ作業不要）**
   - 右メイン基板の裏面（`B.Cu`）にある 3パッドジャンパ **`JP1`** は、**Pad 1（`+3V3R`）と中央の Pad 2（`/V_{IO}`）が基板の銅箔パターンで最初から直結（`SolderJumper_3_Bridged12`）** されています。
   - 手作業でのハンダブリッジは不要です（Pad 3 側はオープンのままにします）。
   - また、基板裏面の `R4`（28kΩ）と `C5`（22nF）は LDO `TLV74318PDBVR` 採用に伴い未実装（DNP）となっているため、空パッドのままで正常です。

2. **PMW3360DM-T2QU センサー IC（`U1`）の挿入とハンダ付け**
   - センサー IC 本体の **1番ピン（パッケージ角の面取り／丸印側）** を確認します。
   - 右メイン基板の **裏側（`B.Cu`：SMD部品が実装されている面）** から、中央の光学開口（$8.70 \times 16.90\text{ mm}$）を跨ぐようにセンサー IC の 16本の足を差し込みます。
     - **1番ピンが基板の四角ランド（Pin 1 パッド）** に一致する向きで挿入してください。
     - センサー上面（光学窓側）が基板裏面（`B.Cu`, $Z = -1.60\text{ mm}$）に隙間なく密着するまで差し込みます。
   - IC が浮かないよう指やマスキングテープで押さえ、**基板の表側（`F.Cu`：トラックボール側）に出た 16本のピンをすべてハンダ付け** します。

3. **専用レンズ（`LM19-LSI`）の装着**
   - センサーの光学窓に貼られている黄色（またはオレンジ色）の保護カプトンテープをピンセットで剥がします（※ホコリが入らないよう、レンズ装着の直前に剥がしてください）。
   - **基板の表側（`F.Cu`：トラックボール側）** から、透明な専用レンズ（`LM19-LSI`）の 4本の脚（丸ガイドポスト 2本＋角脚 2本）を基板の矩形開口（$8.70 \times 16.90\text{ mm}$）に通し、裏面側のセンサー IC のガイド穴へ奥までしっかり差し込みます。
   - これにより、レンズ中央胴部が基板表面（`F.Cu`, $Z_{\text{rel}} = 0.00\text{ mm}$）に着座し、レンズフランジ下面が $Z_{\text{rel}} = +3.40\text{ mm}$（25mm ボール底面 $Z_{\text{rel}} = +5.80\text{ mm}$ から設計通りの光学距離 **$2.40\text{ mm}$**）に正確に位置決めされます。

---

### Step 2-3-2: 右メイン基板への水平エンコーダ（`CKW12`）の組み付け

右手基板斜視プレビュー

右手人差し指内側（`rEXSW1`: $(14.2875, 0.0000)\text{ mm}$）に水平スクロールエンコーダ **CKW12** を組み立てて取り付けます。

1. **CKW12 本体の組み立て**（詳細は [CKW12 公式ビルドガイド](https://github.com/kumamuk-git/CKW12) も参照）
   - **コンスルーピンの準備**：コンスルーをニッパーで **1ピンずつ × 5個** に切り分けます。
   - **ホイールとエンコーダの合体**：六角形のシャフト（`ckw12_stem`）を、ホイール（`ckw12_wheel`）の中心穴と中空軸エンコーダ（`EC05E1220202`）の中心穴に貫通させます。
   - **ハウジングへの収納**：ハウジング（`ckw12_housing`）の所定の位置に横押しタクトスイッチ（`SKQYACE010`）をはめ込み、続けてホイール＋エンコーダ＋ステムを収納します。
   - **コンスルー5ピンの挿入**：ハウジング底面にある5つのスリットに、切り分けたコンスルーピン5個を差し込み、エンコーダ（3端子）とタクトスイッチ（2端子）の側面電極にコンスルーのバネ側がしっかり接触するように収めます。

2. **右メイン基板（`rEXSW1`）への固定とハンダ付け**
   - 右メイン基板の **表側（`F.Cu`：キースイッチを挿す面）** の `rEXSW1` 位置に CKW12 を載せ、5本のコンスルーピンを基板の5つのスルーホールに通します。
   - **基板の裏側（`B.Cu`）から M2 皿ネジ（長さ 3〜4mm）× 2本** を通し、CKW12 ハウジングをネジ止めします。
   - **基板の裏側（`B.Cu`）に出たコンスルーの5本の足（パッド）をハンダ付け** します（※内部バネにハンダが流れ込まないよう、少量のハンダで素早く1〜2秒でハンダ付けしてください）。

---

## 2-4. Phase 3: トラックボールカップの準備（支持球圧入）

1. **$\varnothing 2.0\text{ mm}$ 支持球（×3個）の圧入**
   - 3Dプリントしたトラックボールカップ（`trackball-cup.step`）の内壁にある **3箇所の半球状ディンプル（方位角 $30^\circ, 150^\circ, 270^\circ$、俯角 $52^\circ$）** に、直径 2.0mm のセラミック支持球を1個ずつ載せ、ピンセットの柄や硬い平らなもので「パチン」と奥まで押し込んで固定します。
   - 25mm トラックボール球を3本の保持爪（北 $90^\circ$・西 $180^\circ$・東 $0^\circ$）の間から押し込み、3つの支持球の上でカップ内壁と干渉せず（均一クリアランス $+0.35\text{ mm}$）スルスルと回転すること、および逆さにしても保持爪のスロート（$\varnothing 24.59\text{ mm}$）によって落下しないことを確認します（確認後、ネジ止め作業のため一度ボールを取り外します）。

---

## 2-5. Phase 4: スペーサー・トッププレート・ケースの組み立て

スタックアップ断面図

curcur40 の筐体は、**全 13箇所（左手 5箇所 ＋ 右手外周 4箇所 ＋ トラックボールカップ 4箇所）すべてを M2 5.50mm メス-メス スペーサーと上下の M2 × 4.0mm ネジ（計 26本）で締結する統一構造** です。

1. **3Dプリントケースに M2 5.50mm スペーサー（13個）を取り付ける**
   - 左手ケース（`left`）の内底面（$Z = -9.10\text{ mm}$ フラット床）の **5箇所**、および右手ケース（`right`）の内底面の **8箇所（外周 4箇所 ＋ トラックボール部 4箇所）** に、**M2 メス-メス スペーサー（長さ 5.50mm, 外径 3.0mm）× 計 13個** を立てます。
   - ケース底面外側の **$\varnothing 4.60\text{ mm}$ × 深さ $0.90\text{ mm}$ ザグリ穴** から **M2 × 4.0mm ネジ × 13本** を差し込み、スペーサー下端へねじ込んで固定します。
   - 💡 **ポイント**: ネジ頭（厚さ $0.80\text{ mm}$）は深さ $0.90\text{ mm}$ のザグリ内に完全に沈み込み、ケース底面から $0.10\text{ mm}$ 奥に収まります。

2. **トッププレートとメイン基板にキースイッチを取り付ける**
   - 左右のトッププレート（`plate-top-left`, `plate-top-right`）の表側から、四隅の数箇所に Kailh Choc キースイッチをはめ込みます。
   - メイン基板の **表側（`F.Cu`）** をプレートの裏面に合わせ、キースイッチの2本の金属ピンが Kailh ホットスワップソケットにまっすぐ刺さるように押し込み、残りすべてのキースイッチ（左21個・右19個）を取り付けます。

3. **基板＋トッププレート＋トラックボールカップをケースに固定する**
   - 「トッププレート＋メイン基板」ユニットを左右のケースに収めます。メイン基板の **13箇所の $\varnothing 3.60\text{ mm}$ 貫通穴** を外径 $\varnothing 3.0\text{ mm}$ の M2 スペーサーが通り、**スペーサー上端とメイン基板上面（`F.Cu`, $Z = -3.60\text{ mm}$）が完全にツライチ** になります。
   - **外周 9箇所（左手 5箇所 ＋ 右手外周 4箇所）**：トッププレート表側の **$\varnothing 2.40\text{ mm}$ ストレート貫通穴** から、**M2 × 4.0mm ネジ × 9本** を差し込み、メイン基板とツライチのスペーサー上端へねじ込んで固定します。
   - **右手トラックボールカップ 4箇所**：右メイン基板上面（`F.Cu`）に装着済みの `LM19-LSI` レンズの上から **トラックボールカップ（`trackball-cup`）** を被せ、カップの 4箇所の固定耳（厚さ $2.40\text{ mm}$、$\varnothing 3.60\text{ mm}$ 穴）の上から **M2 × 4.0mm ネジ × 4本** をスペーサー上端へねじ込んで固定します。
     - カップ底面の2段レンズポケット（メイン室 $19.60 \times 22.20\text{ mm}$、深さ $4.85\text{ mm}$）が `LM19-LSI` レンズフランジを干渉ゼロで収容し、メイン基板とカップ底面が $Z = -3.60\text{ mm}$ で密着します。

4. **キーキャップ・トラックボール球・ゴム足の取り付け**
   - 全40個のキースイッチに **1u キーキャップ（40個）** を取り付けます。
   - 右手のトラックボールカップに **25mm トラックボール球** を上から「パチン」と押し込んで装着します。
   - 左右ケース裏面の四隅（および右手トラックボール下部）に **ゴム足（クッションゴム）** を貼り付けて完成です！

---

## 2-6. Phase 5: 動作確認・キーマップ設定（VIA / Vial）

全体トッププレビュー

### 1. ケーブル接続の鉄則（最重要！）

> ⚠️ **【絶対厳守】TRRS ケーブルの活線挿抜（ホットプラグ）禁止**
> PC に USB ケーブルが刺さって通電している状態で TRRS ケーブルを抜き差しすると、TRRS 端子の構造上 `VCC (+3.3V)` と `GND` が一瞬ショートし、マイコン（RP2040）や LDO が破損する恐れがあります。
> **必ず「先に左右を 4極 TRRS ケーブルでしっかり繋いでから、最後に USB Type-C ケーブルを PC に挿す」** ようにしてください。外すときも **「先に USB を抜いてから TRRS を抜く」** を徹底してください。

### 2. 動作テスト項目

1. **全40キーの入力確認**
   - [Vial Web (https://vial.rocks/)](https://vial.rocks/) または [VIA (https://usevia.app/)](https://usevia.app/) の「Key Tester（Matrix Tester）」を開き、左手21キー・右手19キー（および CKW12 ホイールの押し込みクリック）がすべて反応するか確認します。
2. **CKW12 水平スクロールエンコーダの回転確認**
   - 右手人差し指内側のホイールを上下に転がし、デフォルトでは音量上下（レイヤー1では `PageUp` / `PageDown`）が入力されるか確認します。
3. **25mm トラックボールのカーソル移動確認**
   - トラックボールを転がして、マウスカーソルが上下左右にスムーズに動くか確認します。
   - デフォルトキーマップでは、以下の位置にマウスクリック（左クリック `BTN1`・右クリック `BTN2`・中クリック `BTN3`）が配置されています：
     - **Layer 0（デフォルト）**: 右手人差し指内側の中段キー（`rEXSW2`）に `BTN3`（中クリック）
     - **Layer 1（左親指 `MO(1)` 長押し中）**:
       - 左手ホームポジション：F キー位置に `BTN1`（左クリック）、D キー位置に `BTN2`（右クリック）
       - 右手下段：N キー位置に `BTN1`（左クリック）、M キー位置に `BTN2`（右クリック）

### 3. Vial / VIA でのキーマップ変更方法

- **Vial を使う場合（推奨）**:
  - `curcur40_rev1_vial.uf2` を書き込んでいれば、[https://vial.rocks/](https://vial.rocks/) にアクセス（または Vial デスクトップアプリを起動）するだけで、JSON ファイルの読み込み不要で即座に `curcur40` が自動認識され、全40キー・エンコーダ・コンボ・タップダンス・RGB を GUI でリアルタイムに書き換えられます。
- **VIA を使う場合**:
  - `curcur40_rev1_via.uf2` を書き込んだ場合は、[https://usevia.app/](https://usevia.app/) を開き、Settings タブで **`Show Design tab`** を ON にします。
  - Design タブから、本リポジトリの [`kbd_firmware/keyboards/curcur40/the-via/curcur40.json`](../../kbd_firmware/keyboards/curcur40/the-via/curcur40.json) を Load するとキーマップ編集画面が開きます。

---

## 2-7. トラブルシューティング・注意事項

| 症状 | 主な原因と確認・対処方法 |
| :--- | :--- |
| **片側のキーボードが反応しない** | ① 両方の基板に `.uf2` ファームウェアを書き込んだか確認してください。<br>② 3極（TRS）ケーブルではなく **4極（TRRS）ケーブル** が奥までしっかり刺さっているか確認してください。 |
| **特定のキーだけ反応しない** | キースイッチの足が曲がってソケットに入っていない可能性があります。一度スイッチを引き抜き、ピンをまっすぐに伸ばしてから垂直に挿し直してください。 |
| **エンコーダ（CKW12）の回転またはクリックが効かない** | ① コンスルーピンが CKW12 ハウジング内のエンコーダ側面端子・タクトスイッチ端子にしっかり接触しているか確認してください。<br>② 基板裏面の5箇所のコンスルー足が確実にハンダ付けされているか確認してください。 |
| **トラックボールを転がしてもカーソルが動かない** | ① 右メイン基板の `U1`（PMW3360DM-T2QU）が裏面（`B.Cu`）から正しい向き（1番ピン＝四角ランド）で差し込まれ、表面（`F.Cu`）の16ピンすべてが確実にハンダ付けされているか確認してください。<br>② センサーの光学窓の保護テープ（黄色いカプトンテープ）を剥がし忘れていないか、表面（`F.Cu`）から専用レンズ（`LM19-LSI`）が奥までしっかり装着されているか確認してください。 |
