oktntko/curcur40/docs/assets/render_carrying_assembly_front.png

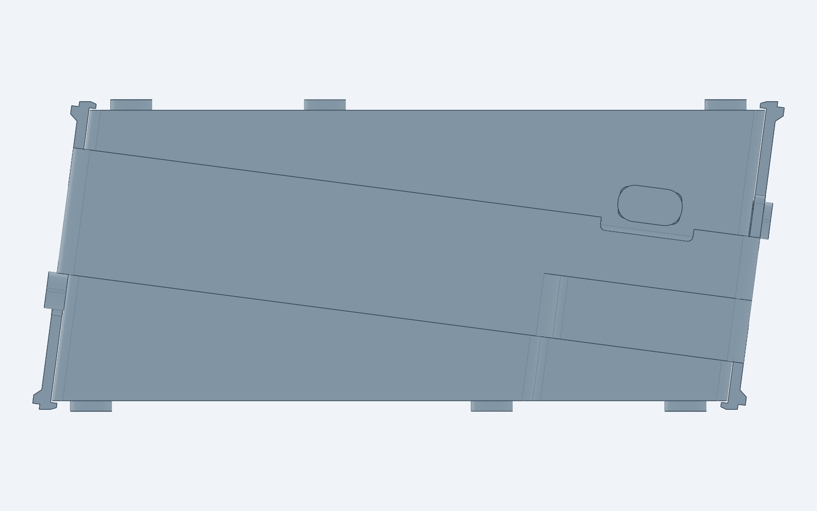
docs/assets/render_carrying_assembly_front.png
