oktntko/curcur40/docs/assets/render_carrying_assembly_iso.png

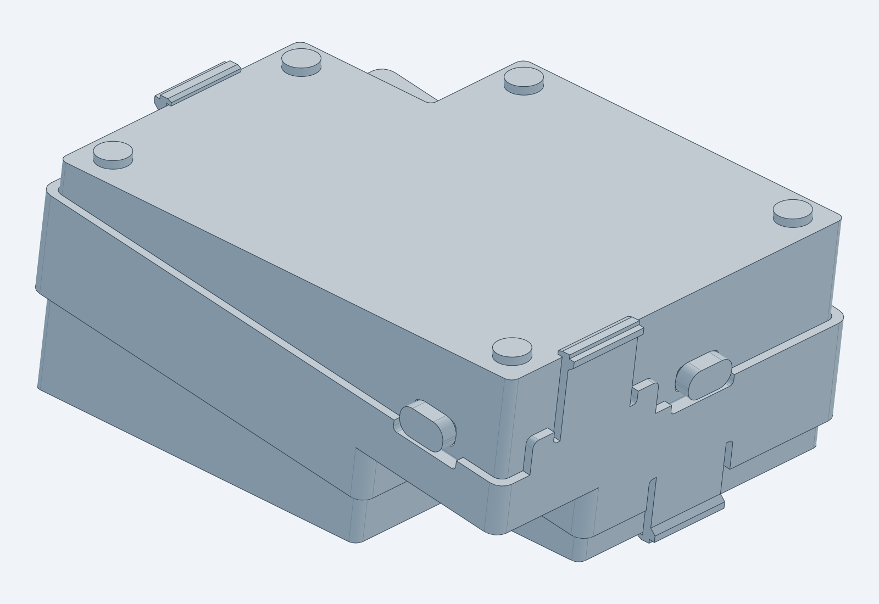
docs/assets/render_carrying_assembly_iso.png
