oktntko/curcur40/preview/render_full_assembly_bottom.png

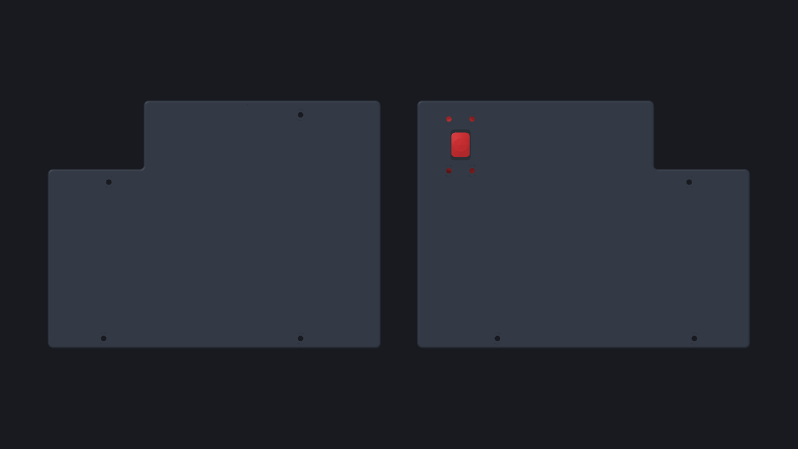
preview/render_full_assembly_bottom.png
