oktntko/curcur40/scratch/inspect_left_assembly.png

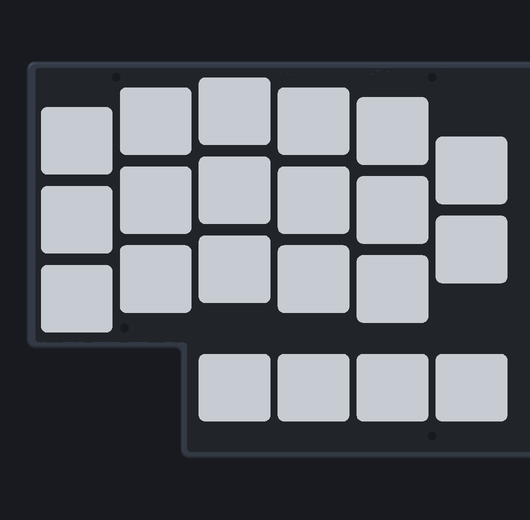
scratch/inspect_left_assembly.png
