oktntko/curcur40/scratch/inspect_right_assembly.png

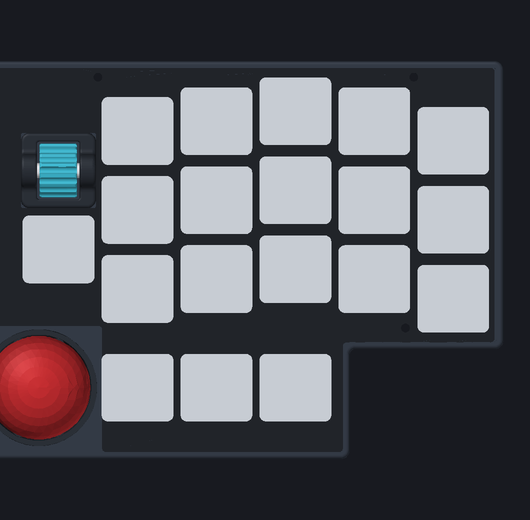
scratch/inspect_right_assembly.png
