oktntko/curcur40/tmp/trackball-sensor-assembly-bottom.png

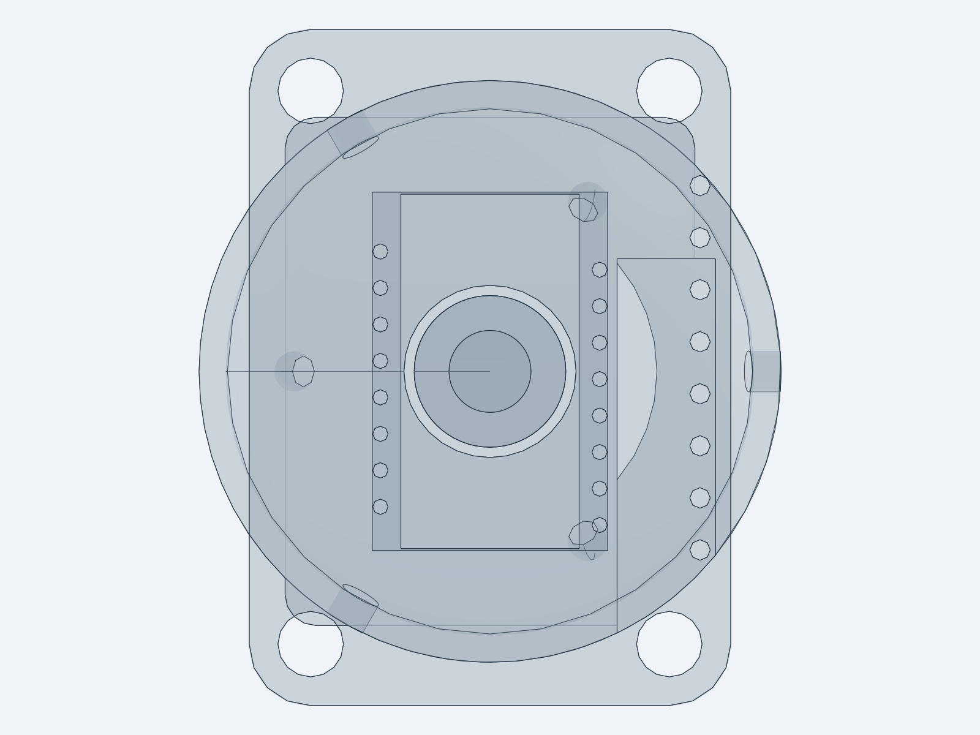
tmp/trackball-sensor-assembly-bottom.png
