oktntko/curcur40/tmp/trackball-sensor-assembly-iso-xray.png

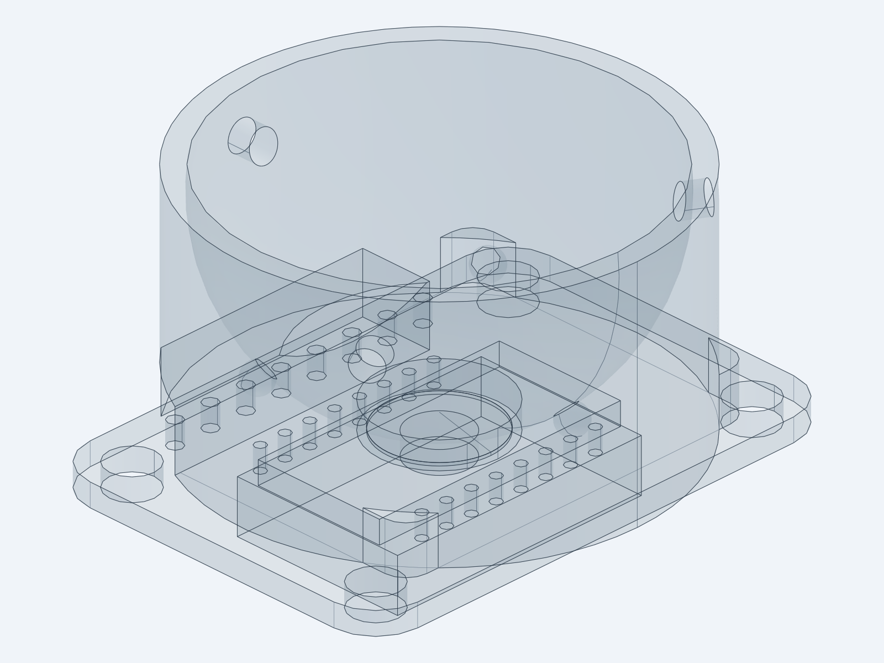
tmp/trackball-sensor-assembly-iso-xray.png
