oktntko/curcur40/scratch/font_test.png

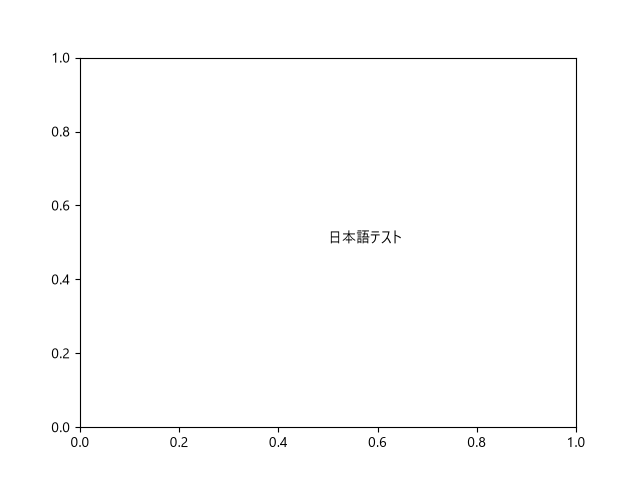
scratch/font_test.png
