oktntko/curcur40/(list of files, drawings)

Other design files:
scratch/pcb_plot_data.json
