oktntko/curcur40/pcbs/pmw3360/curcur40-pmw3360.kicad_pcb

## KiCad design pcbs/pmw3360/curcur40-pmw3360.kicad_pcb (2026-11-05)

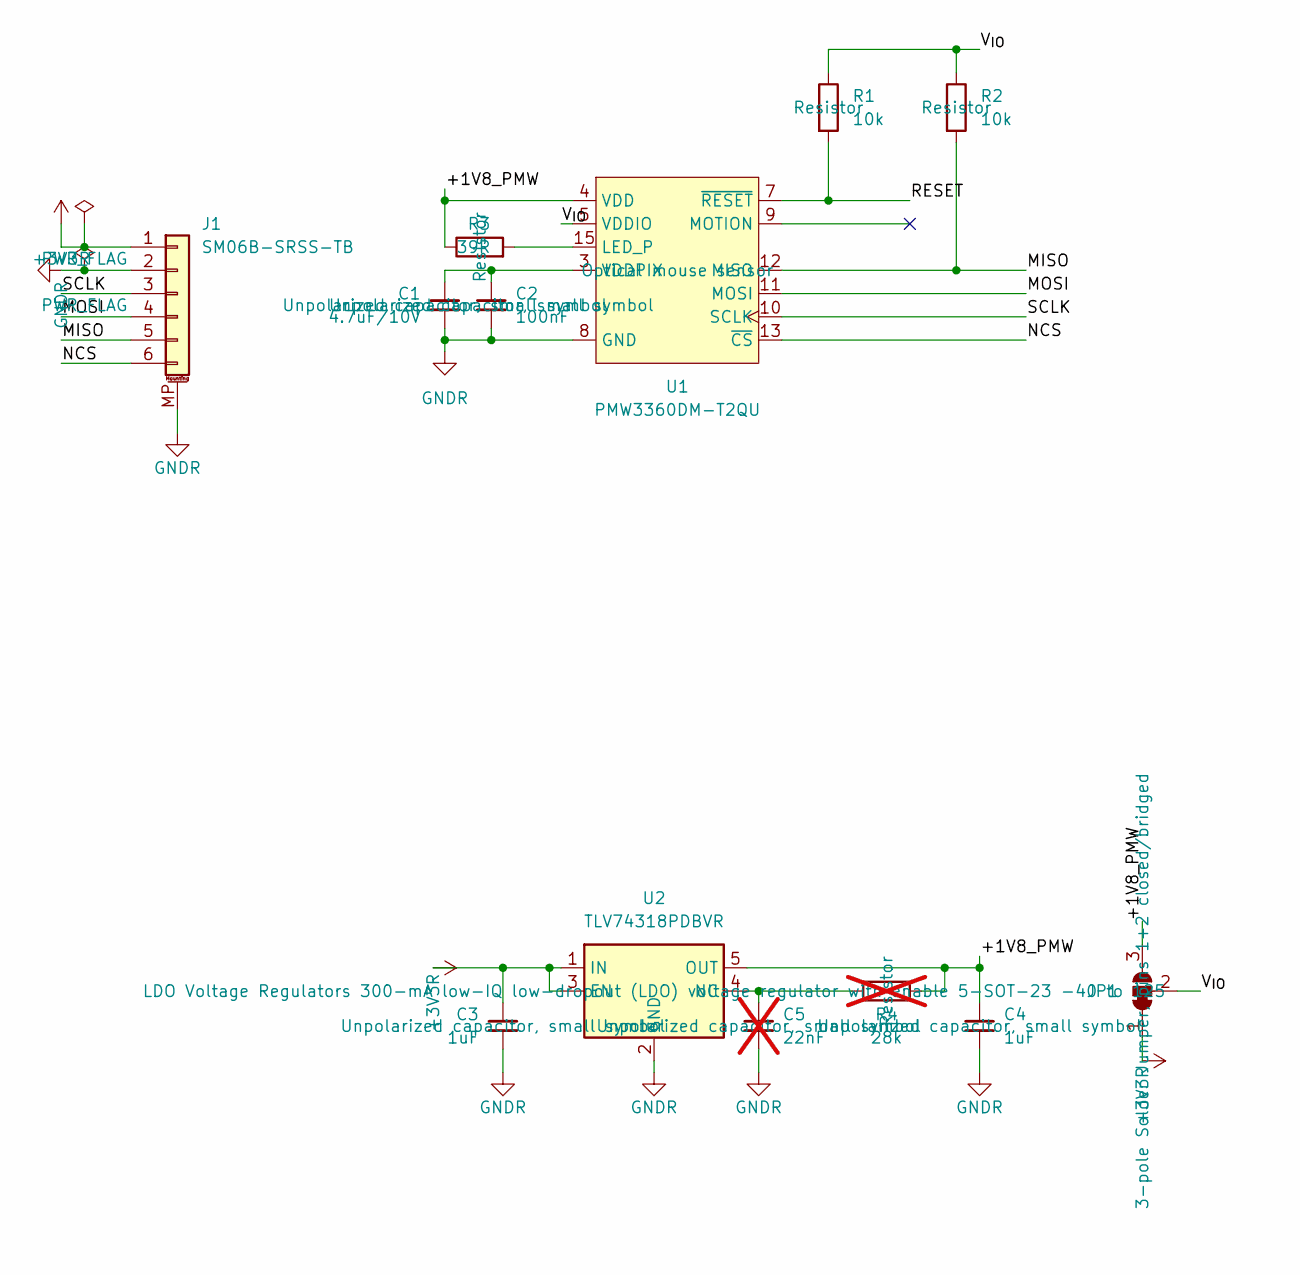
[picture p111: schematic curcur40-pmw3360.kicad_sch, curcur40 PMW3360 Sensor Module]

Parts:
C1: 4.7uF/10V; C_0603_1608Metric_Pad1.08x0.95mm_HandSolder; Mfr. # CL10A475KO8NNNC; LCSC C19666
C2: 100nF; C_0603_1608Metric_Pad1.08x0.95mm_HandSolder; Mfr. # CC0603KRX7R9BB104; LCSC C14663
C3, C4: 1uF; C_0603_1608Metric_Pad1.08x0.95mm_HandSolder; Mfr. # CL10A105KB8NNNC; LCSC C15849
C5: 22nF; C_0603_1608Metric_Pad1.08x0.95mm_HandSolder; Mfr. # CL10B223KB8NNNC; LCSC C21122; not fitted
J1: SM06B-SRSS-TB; JST_SH_SM06B-SRSS-TB_1x06-1MP_P1.00mm_Horizontal; LCSC C160405
JP1: SolderJumper_3_Bridged12; SolderJumper-3_P1.3mm_Bridged12_RoundedPad1.0x1.5mm_NumberL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
R1, R2: 10k; R_0603_1608Metric_Pad0.98x0.95mm_HandSolder; Mfr. # 0603WAF1002T5E; LCSC C25804
R3: 39R; R_0603_1608Metric_Pad0.98x0.95mm_HandSolder; Mfr. # 0603WAF390JT5E; LCSC C23154
R4: 28k; R_0603_1608Metric_Pad0.98x0.95mm_HandSolder; not fitted
U1: PMW3360DM-T2QU; PMW3360DM-T2QU_16Pin
U2: TLV74318PDBVR; SOT-23-5; Mfr. # TLV74318PDBVR; LCSC C485152

Connections:
+3V3R: C3.1, J1.1, JP1.1 (A), U2.1 (IN), U2.3 (EN)
/+1V8_PMW: C4.1, JP1.3 (B), R3.1, R4.1, U1.4 (VDD), U2.5 (OUT)
/MISO: J1.5, R2.2, U1.12 (MISO)
/MOSI: J1.4, U1.11 (MOSI)
/NCS: J1.6, U1.13 (~CS)
/RESET: R1.2, U1.7 (~RESET)
/SCLK: J1.3, U1.10 (SCLK)
/V_{IO}: JP1.2 (C), R1.1, R2.1, U1.5 (VDDIO)
GNDR: C1.2, C2.2, C3.2, C4.2, C5.2, J1.2, J1.MP (MountPin), U1.8 (GND), U2.2 (GND)
unnamed: R3.2, U1.15 (LED_P)
unnamed: C1.1, C2.1, U1.3 (VDDPIX)
unnamed: C5.1, R4.2, U2.4 (NC)

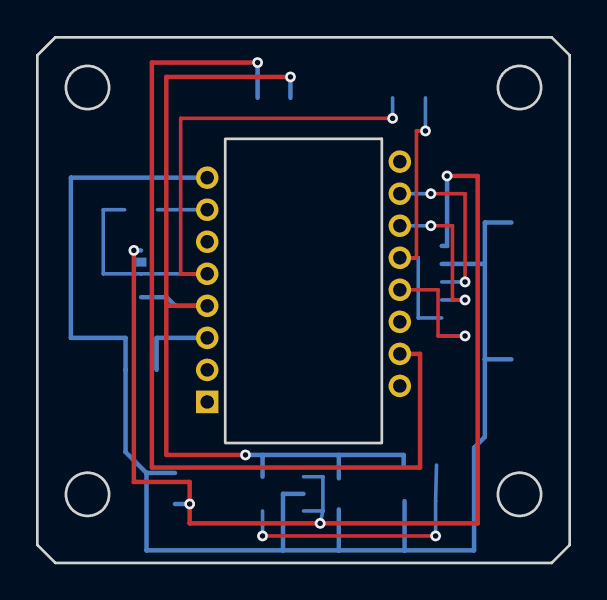
[picture p112: board pcbs/pmw3360/curcur40-pmw3360.kicad_pcb from above]

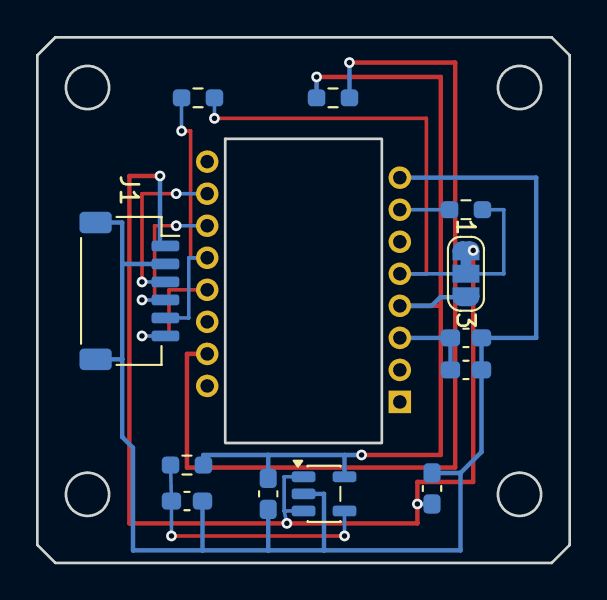
[picture p113: board pcbs/pmw3360/curcur40-pmw3360.kicad_pcb from below]

Board: 2 copper layers, 29.6 x 29.2 mm, 13 parts (13 on the bottom side), 12 nets.
