oktntko/curcur40/pcbs/inertia-wheel-eval/curcur40-wheel-eval.kicad_pcb

## KiCad design pcbs/inertia-wheel-eval/curcur40-wheel-eval.kicad_pcb (2026-10-30)

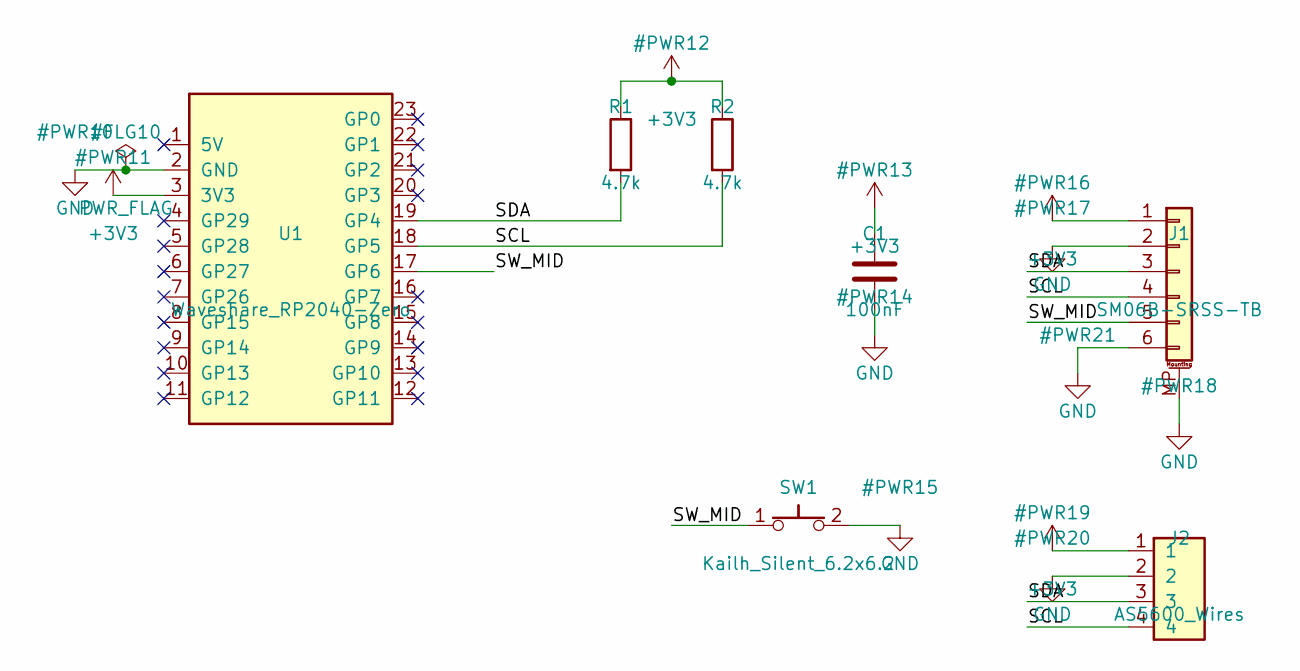
[picture p118: schematic curcur40-wheel-eval.kicad_sch, curcur40 Passive Inertia Wheel - RP2040-Zero Standalone Eva…]

Parts:
C1: 100nF; C_0402_1005Metric; LCSC C1525
J1: SM06B-SRSS-TB; JST_SH_SM06B-SRSS-TB_1x06-1MP_P1.00mm_Horizontal; LCSC C160405
J2: AS5600_Wires; SolderPads_1x04_P1.27mm_SMD
R1, R2: 4.7k; R_0402_1005Metric; LCSC C25900
SW1: Kailh_Silent_6.2x6.2; Kailh_Square_Silent_6.2x6.2mm
U1: Waveshare_RP2040-Zero; Waveshare_RP2040-Zero_Castellated

Connections:
+3V3: C1.1, J1.1, J2.1, R1.1, R2.1, U1.3 (3V3)
/SCL: J1.4, J2.4, R2.2, U1.18 (GP5)
/SDA: J1.3, J2.3, R1.2, U1.19 (GP4)
/SW_MID: J1.5, SW1.1, U1.17 (GP6)
GND: C1.2, J1.2, J1.6, J1.MP (MountPin), J2.2, SW1.2, U1.2 (GND)

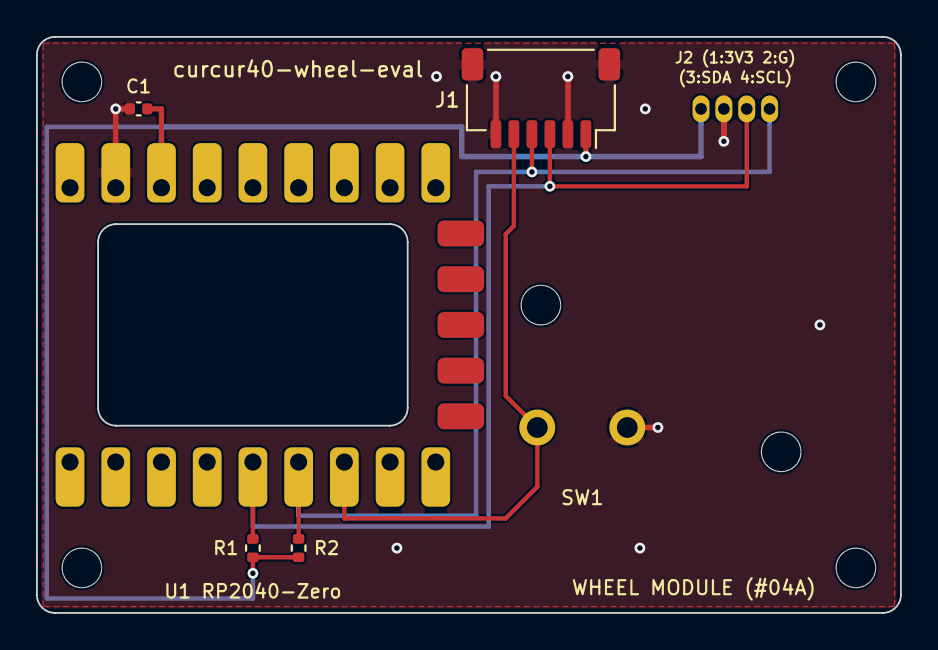
[picture p119: board curcur40-wheel-eval.kicad_pcb from above]

Board: 2 copper layers, 48.0 x 32.0 mm, 13 parts (0 on the bottom side), 5 nets.

Other parts of the board:
H1, H2, H3, H4, H5, H6: MountingHole; MountingHole_2.2mm_M2
