oktntko/curcur40/pcbs/curcur40/pmw3360/curcur40-pmw3360.kicad_pcb

## KiCad design pcbs/curcur40/pmw3360/curcur40-pmw3360.kicad_pcb (2026-10-17)

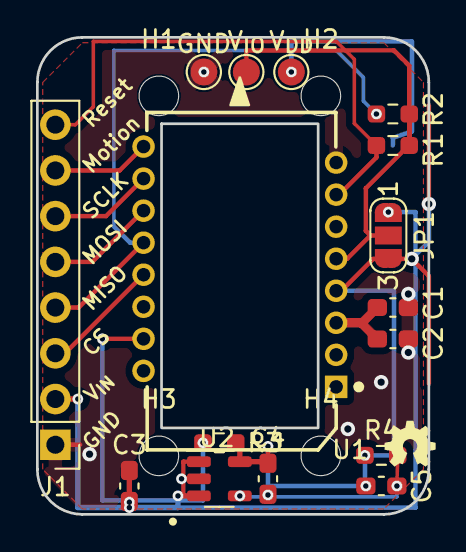
[picture p124: board pcbs/curcur40/pmw3360/curcur40-pmw3360.kicad_pcb from above]

Board: 2 copper layers, 21.8 x 26.5 mm, 20 parts (0 on the bottom side), 13 nets.

Parts:
C1: 4.7uF/10V; C_0603_1608Metric_Pad1.08x0.95mm_HandSolder
C2: 100nF; C_0603_1608Metric_Pad1.08x0.95mm_HandSolder
C3, C4: 1uF; C_0603_1608Metric_Pad1.08x0.95mm_HandSolder
C5: 22nF; C_0603_1608Metric_Pad1.08x0.95mm_HandSolder
H1, H2, H3, H4: MountingHole_2.2mm_M2
J1: Conn_01x08; PinHeader_1x08_P2.54mm_Vertical
JP1: SolderJumper_3_Open; SolderJumper-3_P1.3mm_Open_RoundedPad1.0x1.5mm_NumberLabels
R1, R2: 10k; R_0603_1608Metric_Pad0.98x0.95mm_HandSolder
R3: 39R; R_0603_1608Metric_Pad0.98x0.95mm_HandSolder
R4: 28k; R_0603_1608Metric_Pad0.98x0.95mm_HandSolder
TP1: VIO; TestPoint_Pad_D1.5mm
TP2: VDD; TestPoint_Pad_D1.5mm
TP3: GND; TestPoint_Pad_D1.5mm
U1: PMW3360DM-T2QU; PMW3360DM-T2QU_16Pin
U2: TLV74318PDBVR; SOT-23-5

Connections:
/CS: J1.3, U1.13 (~CS)
/MISO: J1.4, R2.2, U1.12 (MISO)
/MOSI: J1.5, U1.11 (MOSI)
/MOTION: J1.7, U1.9 (MOTION)
/RESET: J1.8, R1.2, U1.7 (~RESET)
/SCLK: J1.6, U1.10 (SCLK)
GND: C1.2, C2.2, C3.2, C4.2, C5.2, J1.1, TP3.1, U1.8 (GND), U2.2 (GND)
unnamed: R3.2, U1.15 (LED_P)
unnamed: C1.1, C2.1, U1.3 (VDDPIX)
unnamed: C5.1, R4.2, U2.4 (NC)
VDD: C4.1, JP1.3 (B), R3.1, R4.1, TP2.1, U1.4 (VDD), U2.5 (OUT)
V_{IN}: C3.1, J1.2, JP1.1 (A), U2.1 (IN), U2.3 (EN)
V_{IO}: JP1.2 (C), R1.1, R2.1, TP1.1, U1.5 (VDDIO)
