oktntko/curcur40/pcbs/inertia-wheel-sensor/curcur40-wheel-sensor.kicad_pcb

## KiCad design pcbs/inertia-wheel-sensor/curcur40-wheel-sensor.kicad_pcb (2026-10-30)

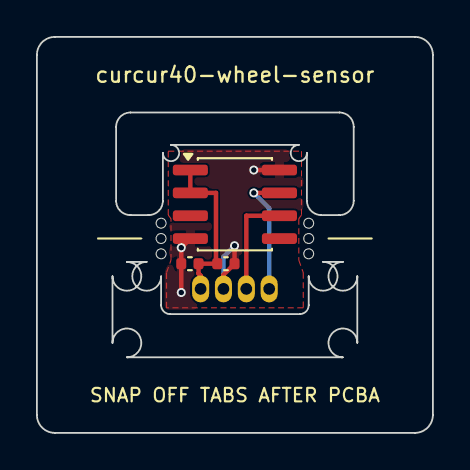
[picture p125: board curcur40-wheel-sensor.kicad_pcb from above]

Board: 2 copper layers, 22.0 x 22.0 mm, 6 parts (0 on the bottom side), 4 nets.

Parts:
C1: 100nF; C_0402_1005Metric
C2: 1uF; C_0402_1005Metric
J1: SolderPads_1x04; SolderPads_1x04_P1.27mm_SMD
MB1, MB2: MouseBite; MouseBite_3x0.55mm
U1: AS5600-ASOT; SOIC-8_3.9x4.9mm_P1.27mm

Connections:
+3V3: C1.1, C2.1, J1.1, U1.1, U1.2
/SCL: J1.4, U1.7
/SDA: J1.3, U1.6
GND: C1.2, C2.2, J1.2, U1.4, U1.8
