oktntko/curcur40/kbd_firmware/keyboards/curcur40_wheel_eval/qmk/qmk_firmware/rev1/config.h

// Copyright 2026 oktntko
// SPDX-License-Identifier: GPL-2.0-or-later

#pragma once

/*
 * RP2040-Zero I2C0 Configuration (J1 JST SH 6-pin / J2 PTH -> AS5600-ASOM Sub-PCB):
 * Note: QMK's ChibiOS RP2040 i2c_master driver uses 1-indexed `I2C1_*` config macros
 * regardless of whether `I2C_DRIVER` selects hardware `I2CD0` or `I2CD1`.
 */
#define I2C_DRIVER I2CD0
#define I2C1_SDA_PIN GP4
#define I2C1_SCL_PIN GP5
#define I2C1_CLOCK_SPEED 400000
#define F_SCL 400000UL

/* High-rate 1 kHz polling for zero-loss tracking during 20+ rev/s inertia flicks */
#define POINTING_DEVICE_TASK_THROTTLE_MS 1
#define MOUSE_EXTENDED_REPORT

/*
 * Passive Magnetic Inertia Wheel Resolution & Filtering Tuning:
 * - Physical internal hub has 9 discrete Ø2.00 mm SUJ2 steel balls (40.0 deg/detent).
 * - Recommended WHEEL_NOTCHES_PER_REV presets:
 *      9 : Exact 1:1 HID scroll step per physical magnetic detent
 *     18 : Standard 20.0 deg mouse wheel pitch (2 steps per physical detent, default)
 *     36 : High-density fast scroll (10.0 deg per step, matches 36 rim flutes & 4 steps/detent)
 */
#ifndef WHEEL_NOTCHES_PER_REV
#    define WHEEL_NOTCHES_PER_REV 18
#endif

/* Stationary thermal/Hall micro-jitter deadband in 12-bit LSBs (6 LSB ~= 0.53 deg) */
#ifndef WHEEL_DEADBAND_LSB
#    define WHEEL_DEADBAND_LSB 6
#endif

/* Set to 0 to invert scroll direction */
#ifndef WHEEL_INVERT_DIR
#    define WHEEL_INVERT_DIR 1
#endif

/* RP2040 double-tap reset bootloader entry */
#define RP2040_BOOTLOADER_DOUBLE_TAP_RESET
#define RP2040_BOOTLOADER_DOUBLE_TAP_RESET_TIMEOUT 500U
