oktntko/curcur40/kbd_firmware/keyboards/crkbd/qmk/qmk_firmware/rev4_1/config.h

#pragma once

#define SERIAL_USART_TX_PIN GP12
#define USB_VBUS_PIN GP13

#define I2C_DRIVER I2CD1
#define I2C1_SDA_PIN GP6
#define I2C1_SCL_PIN GP7

/* RP2040- and hardware-specific config */
#define RP2040_BOOTLOADER_DOUBLE_TAP_RESET
#define RP2040_BOOTLOADER_DOUBLE_TAP_RESET_TIMEOUT 500U
#define PICO_XOSC_STARTUP_DELAY_MULTIPLIER 64
