oktntko/curcur40/scratch/update_full_assembly.py

# -*- coding: utf-8 -*-
"""
Update curcur40 full assembly (cases/curcur40/assembly-full.step)
and generate rendered preview images.
Incorporates:
- New right case (right.step) with +2.0mm shift, L-shaped TRRS opening, no double wall, solid screw bosses
- New trackball cup (trackball-cup.step) placed at (23.8125, -109.5375, 10.60)
- 25mm trackball sphere at (23.8125, -109.5375, 10.60)
- Left case, top plates, keycaps, CKW12 encoder
"""
import os
import sys
import math
import numpy as np
from PIL import Image, ImageDraw
from pathlib import Path

WORKSPACE = Path(r"c:\Users\oktnt\workspace\curcur40")
CASES_DIR = WORKSPACE / "cases" / "curcur40"
ARTIFACTS_DIR = Path(r"C:\Users\oktnt\.gemini\antigravity\brain\dab819aa-2c9f-4dd2-be5e-39a298725eca")

sys.path.insert(0, str(ARTIFACTS_DIR / "scratch"))

from OCP.gp import gp_Pnt, gp_Dir, gp_Vec, gp_Ax1, gp_Ax2, gp_Trsf
from OCP.BRepBuilderAPI import BRepBuilderAPI_Transform
from OCP.BRepPrimAPI import BRepPrimAPI_MakeSphere, BRepPrimAPI_MakeCylinder
from OCP.BRepAlgoAPI import BRepAlgoAPI_Cut
from OCP.TopoDS import TopoDS_Compound, TopoDS_Builder
from OCP.BRepMesh import BRepMesh_IncrementalMesh
from OCP.BRep import BRep_Tool
from OCP.TopExp import TopExp_Explorer
from OCP.TopAbs import TopAbs_FACE
from OCP.TopLoc import TopLoc_Location
from OCP.STEPControl import STEPControl_Reader, STEPControl_Writer, STEPControl_AsIs
from OCP.IFSelect import IFSelect_RetDone

import build_cases

# Switches and mounting holes definitions (self-contained, no pcbnew dependency)
LEFT_MOUNTING_HOLES = [
    (-100.0000, -22.5000, 1.1),
    ( -23.8125, -22.5000, 1.1),
    ( -98.0000,  38.0000, 1.1),
    ( -23.8125,  64.0000, 1.1),
]

RIGHT_MOUNTING_HOLES = [
    (100.0000, -22.5000, 1.1),
    ( 23.8125, -22.5000, 1.1),
    ( 98.0000,  38.0000, 1.1),
]

LEFT_SWITCHES = [
    (-109.5375, -7.14375),
    (-109.5375, 11.90625),
    (-109.5375, 30.95625),
    (-90.4875, -11.90625),
    (-90.4875, 7.14375),
    (-90.4875, 26.19375),
    (-71.4375, -14.28750),
    (-71.4375, 4.76250),
    (-71.4375, 23.81250),
    (-52.3875, -11.90625),
    (-52.3875, 7.14375),
    (-52.3875, 26.19375),
    (-33.3375, -9.52500),
    (-33.3375, 9.52500),
    (-33.3375, 28.57500),
    (-14.2875, 0.00000),
    (-14.2875, 19.05000),
    (-71.4375, 52.38750),
    (-52.3875, 52.38750),
    (-33.3375, 52.38750),
    (-14.2875, 52.38750),
]

RIGHT_SWITCHES = [
    (109.5375, -7.14375),
    (109.5375, 11.90625),
    (109.5375, 30.95625),
    (90.4875, -11.90625),
    (90.4875, 7.14375),
    (90.4875, 26.19375),
    (71.4375, -14.28750),
    (71.4375, 4.76250),
    (71.4375, 23.81250),
    (52.3875, -11.90625),
    (52.3875, 7.14375),
    (52.3875, 26.19375),
    (33.3375, -9.52500),
    (33.3375, 9.52500),
    (33.3375, 28.57500),
    (14.2875, 19.05000),
    (33.3375, 52.38750),
    (52.3875, 52.38750),
    (71.4375, 52.38750),
]

RIGHT_ENCODER = (14.2875, 0.00000)

def get_left_plate_outer_pts():
    # Left Plate Plan B (smooth un-notched rectangle with pinky step)
    return [
        (   5.6625, -24.71250, 1.0),
        (-119.4625, -24.71250, 1.0),
        (-119.4625,  41.38125, 1.0),
        ( -82.8625,  41.38125, 1.0),
        ( -82.8625,  67.90000, 1.0),
        (   5.6625,  67.90000, 1.0),
    ]

def get_right_plate_outer_pts():
    # Right Plate Plan B with trackball bay (no TRRS notch)
    return [
        ( -5.6625, -24.71250, 1.0),
        (119.4625, -24.71250, 1.0),
        (119.4625,  41.38125, 1.0),
        ( 82.8625,  41.38125, 1.0),
        ( 82.8625,  67.90000, 1.0),
        ( 24.8375,  67.90000, 1.0),
        ( 24.8375,  37.40000, 1.0),
        ( -5.6625,  37.40000, 1.0),
    ]

def load_step(path):
    reader = STEPControl_Reader()
    if reader.ReadFile(str(path)) != IFSelect_RetDone or reader.TransferRoots() == 0:
        raise RuntimeError(f"Could not read STEP: {path}")
    return reader.OneShape()

def translate_shape(shape, dx, dy, dz):
    trsf = gp_Trsf()
    trsf.SetTranslation(gp_Vec(dx, dy, dz))
    return BRepBuilderAPI_Transform(shape, trsf, True).Shape()

def make_keycap_shape(cx, cy):
    cap_pts = [
        (cx - 8.6, cy - 8.1, 1.5),
        (cx + 8.6, cy - 8.1, 1.5),
        (cx + 8.6, cy + 8.1, 1.5),
        (cx - 8.6, cy + 8.1, 1.5),
    ]
    return build_cases.make_extruded_polygon(cap_pts, 1.2, 5.6)

def build_plate_with_cutouts(outer_pts, switch_centers, mounting_holes, x_offset, encoder=False):
    plate = build_cases.make_extruded_polygon(outer_pts, -1.9, -0.3)
    tools = TopoDS_Compound()
    tools_builder = TopoDS_Builder()
    tools_builder.MakeCompound(tools)

    def to_step(x, y):
        return x + x_offset, -(y + 57.1500)

    def add_rounded_cutout(cx, cy, width, height, radius):
        x, y = to_step(cx, cy)
        points = [
            (x - width / 2, y - height / 2, radius),
            (x + width / 2, y - height / 2, radius),
            (x + width / 2, y + height / 2, radius),
            (x - width / 2, y + height / 2, radius),
        ]
        tools_builder.Add(
            tools, build_cases.make_extruded_polygon(points, -2.0, 0.0)
        )

    for cx, cy in switch_centers:
        add_rounded_cutout(cx, cy, 14.0, 14.0, 0.5)
    if encoder:
        add_rounded_cutout(*RIGHT_ENCODER, 18.2, 18.2, 0.5)

    for cx, cy, radius in mounting_holes:
        x, y = to_step(cx, cy)
        tool = BRepPrimAPI_MakeCylinder(
            gp_Ax2(gp_Pnt(x, y, -2.0), gp_Dir(0, 0, 1)), radius, 2.0
        ).Shape()
        tools_builder.Add(tools, tool)

    cut = BRepAlgoAPI_Cut(plate, tools)
    cut.Build()
    if not cut.IsDone():
        raise RuntimeError("Failed to cut the top-plate openings from the assembly model.")
    return cut.Shape()

def make_ckw12_shape(cx, cy):
    trsf_rot = gp_Trsf()
    trsf_rot.SetRotation(gp_Ax1(gp_Pnt(0, 0, 0), gp_Dir(0, 0, 1)), -math.pi / 2.0)

    r_h = STEPControl_Reader()
    r_h.ReadFile(r"c:\Users\oktnt\workspace\curcur40\pcbs\common\kbd\3dmodels\ckw12_housing.stp")
    r_h.TransferRoots()
    housing_rot = BRepBuilderAPI_Transform(r_h.OneShape(), trsf_rot, True).Shape()
    housing = translate_shape(housing_rot, cx, cy, -5.0)

    r_w = STEPControl_Reader()
    r_w.ReadFile(r"c:\Users\oktnt\workspace\curcur40\pcbs\common\kbd\3dmodels\ckw12_wheel.stp")
    r_w.TransferRoots()
    wheel_rot = BRepBuilderAPI_Transform(r_w.OneShape(), trsf_rot, True).Shape()
    wheel = translate_shape(wheel_rot, cx, cy, -5.0)

    r_s = STEPControl_Reader()
    r_s.ReadFile(r"c:\Users\oktnt\workspace\curcur40\pcbs\common\kbd\3dmodels\ckw12_stem.stp")
    r_s.TransferRoots()
    stem_rot = BRepBuilderAPI_Transform(r_s.OneShape(), trsf_rot, True).Shape()
    stem = translate_shape(stem_rot, cx, cy, -5.0)

    return housing, wheel, stem

from OCP.TopoDS import TopoDS_Compound, TopoDS_Builder, TopoDS

# ... in extract_triangles:
def extract_triangles(shape, color_rgb):
    BRepMesh_IncrementalMesh(shape, 0.15, False, 0.3, True)
    exp = TopExp_Explorer(shape, TopAbs_FACE)
    loc = TopLoc_Location()
    triangles = []
    while exp.More():
        face = TopoDS.Face_s(exp.Current())
        facing = face.Orientation()
        triangulation = BRep_Tool.Triangulation_s(face, loc)
        if triangulation is not None:
            trsf = loc.Transformation()
            nodes = [triangulation.Node(i) for i in range(1, triangulation.NbNodes() + 1)]
            trans_nodes = []
            for n in nodes:
                p = n.Transformed(trsf)
                trans_nodes.append((p.X(), p.Y(), p.Z()))
            for i in range(1, triangulation.NbTriangles() + 1):
                tri = triangulation.Triangle(i)
                i1, i2, i3 = tri.Get()
                p1, p2, p3 = trans_nodes[i1 - 1], trans_nodes[i2 - 1], trans_nodes[i3 - 1]
                if facing != 0:
                    triangles.append((p1, p3, p2, color_rgb))
                else:
                    triangles.append((p1, p2, p3, color_rgb))
        exp.Next()
    return triangles

def subdivide_large_triangles(v0, v1, v2, colors, max_edge=3.5, passes=6):
    for _ in range(passes):
        d01 = np.linalg.norm(v1 - v0, axis=1)
        d12 = np.linalg.norm(v2 - v1, axis=1)
        d20 = np.linalg.norm(v0 - v2, axis=1)
        max_lens = np.maximum(d01, np.maximum(d12, d20))
        split_mask = max_lens > max_edge
        if not np.any(split_mask):
            break
        keep_v0, keep_v1, keep_v2 = v0[~split_mask], v1[~split_mask], v2[~split_mask]
        keep_c = colors[~split_mask]

        sv0, sv1, sv2 = v0[split_mask], v1[split_mask], v2[split_mask]
        sc = colors[split_mask]
        s01, s12, s20 = d01[split_mask], d12[split_mask], d20[split_mask]

        c01 = (s01 >= s12) & (s01 >= s20)
        c12 = (~c01) & (s12 >= s20)
        c20 = (~c01) & (~c12)

        m01 = (sv0 + sv1) * 0.5
        m12 = (sv1 + sv2) * 0.5
        m20 = (sv2 + sv0) * 0.5

        new_v0, new_v1, new_v2, new_c = [], [], [], []
        if np.any(c01):
            new_v0.extend([sv0[c01], m01[c01]])
            new_v1.extend([m01[c01], sv1[c01]])
            new_v2.extend([sv2[c01], sv2[c01]])
            new_c.extend([sc[c01], sc[c01]])
        if np.any(c12):
            new_v0.extend([sv0[c12], sv0[c12]])
            new_v1.extend([sv1[c12], m12[c12]])
            new_v2.extend([m12[c12], sv2[c12]])
            new_c.extend([sc[c12], sc[c12]])
        if np.any(c20):
            new_v0.extend([sv0[c20], m20[c20]])
            new_v1.extend([sv1[c20], sv1[c20]])
            new_v2.extend([m20[c20], sv2[c20]])
            new_c.extend([sc[c20], sc[c20]])

        v0 = np.vstack([keep_v0] + new_v0)
        v1 = np.vstack([keep_v1] + new_v1)
        v2 = np.vstack([keep_v2] + new_v2)
        colors = np.vstack([keep_c] + new_c)
    return v0, v1, v2, colors
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
