oktntko/curcur40/scratch/test_perfect_pcbs.py

# -*- coding: utf-8 -*-
"""
Perfect update and DRC verification for both Right and Left PCBs.
- Restore TRRS mid-mount cutouts on Edge.Cuts
- Remove all legacy Corne switch-matrix mounting holes
- Add new perimeter mounting holes:
  Right (3 holes): (+114.0, -20.0), (+2.0, -20.0), (+114.3, +37.0)
  Left (4 holes):  (-114.0, -20.0), (-2.0, -20.0), (-114.3, +37.0), (-2.0, +64.0)
- Cleanly route /TX on F.Cu around the TRRS cutout
- Refill copper zones and verify 0 DRC violations and 0 unconnected pads on both boards!
"""
import math
import subprocess
import pcbnew

KICAD_CLI = r"C:\Users\oktnt\AppData\Local\Programs\KiCad\10.0\bin\kicad-cli.exe"

def mm(val):
    return pcbnew.FromMM(float(val))

def pt(x, y):
    return pcbnew.VECTOR2I(mm(x), mm(y))

def add_track_path(board, net_item, layer, pts, width=0.25):
    for i in range(len(pts) - 1):
        x1, y1 = pts[i]
        x2, y2 = pts[i + 1]
        if abs(x1 - x2) < 1e-5 and abs(y1 - y2) < 1e-5:
            continue
        t = pcbnew.PCB_TRACK(board)
        t.SetLayer(layer)
        t.SetStart(pt(x1, y1))
        t.SetEnd(pt(x2, y2))
        t.SetWidth(mm(width))
        board.Add(t)
        t.SetNet(net_item)

def add_via(board, net_item, x, y, drill=0.30, size=0.50):
    v = pcbnew.PCB_VIA(board)
    v.SetPosition(pt(x, y))
    v.SetViaType(pcbnew.VIATYPE_THROUGH)
    v.SetDrill(mm(drill))
    v.SetWidth(mm(size))
    board.Add(v)
    v.SetNet(net_item)

def add_line(board, x1, y1, x2, y2, layer=pcbnew.Edge_Cuts, width=0.10):
    sh = pcbnew.PCB_SHAPE(board)
    sh.SetShape(pcbnew.SHAPE_T_SEGMENT)
    sh.SetLayer(layer)
    sh.SetStart(pt(x1, y1))
    sh.SetEnd(pt(x2, y2))
    sh.SetWidth(mm(width))
    board.Add(sh)

def add_arc_90(board, x1, y1, x2, y2, cx, cy, layer=pcbnew.Edge_Cuts, width=0.10):
    sh = pcbnew.PCB_SHAPE(board)
    sh.SetShape(pcbnew.SHAPE_T_ARC)
    sh.SetLayer(layer)
    ang1 = math.atan2(y1 - cy, x1 - cx)
    ang2 = math.atan2(y2 - cy, x2 - cx)
    diff = (ang2 - ang1 + math.pi) % (2 * math.pi) - math.pi
    mid_ang = ang1 + diff / 2.0
    r = math.hypot(x1 - cx, y1 - cy)
    mx = cx + r * math.cos(mid_ang)
    my = cy + r * math.sin(mid_ang)
    sh.SetArcGeometry(pt(x1, y1), pt(mx, my), pt(x2, y2))
    sh.SetWidth(mm(width))
    board.Add(sh)

def add_circle(board, cx, cy, r, layer=pcbnew.Edge_Cuts, width=0.10):
    c = pcbnew.PCB_SHAPE(board)
    c.SetShape(pcbnew.SHAPE_T_CIRCLE)
    c.SetLayer(layer)
    c.SetCenter(pt(cx, cy))
    c.SetEnd(pt(cx + r, cy))
    c.SetWidth(mm(width))
    board.Add(c)
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
