oktntko/curcur40/(commit log)

2026-10-11 Step 1：ピンアサイン＆回路図の作成（pcbs/common/left.kicad_sch, right.kicad_sch をベースに、左右分割・第6列削除・左 3,6 追加・右 CKW12 & PMW3360 コネクタ追加・LEDチェーン修正）
    Step 2：PCB（基板）レイアウトの作成（corne-chocolate.kicad_pcb をベースに左右分割、外形・親指列・トラックボール部・CKW12フットプリント・配線の変更、および PMW3360 子基板の作成）
    Step 3：ファームウェアの作成（kbd_firmware の crkbd/rev4_1/mini および vial_mini をベースに、40キーマトリックス・CKW12エンコーダ・PMW3360ポインティングデバイス・オートマウスレ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
2026-10-12 switch usb / trrs
2026-10-14 text-to-cad’s 12 skills fixed by copilot
2026-10-16 fix pcb
2026-10-16 fix case
2026-10-16 Restore TRRS cutouts and relocate mounting holes to perimeter
2026-10-17 fix trrs top plate
2026-10-17 fix hole
2026-10-18 回路図 kicad 10
2026-10-18 fix led
2026-10-18 fix left socket
2026-10-19 🔴 1. 致命的な不具合（Critical：物理的に組立不可、または動作不可）
    [Critical-1] トラックボール部の3D機構・光学設計の破綻（4重の物理的干渉・焦点外れ）
    [Critical-2] 左右メイン基板の取付穴径が ∅2.20 mm になっており、M2スペーサーが貫通できない
    [Critical-3] 3Dプリントケース内部の 2.0mm スペーサー受けボスが消失しており、高さが 2.0 mm 合わない
    [Critical-4] PMW3360 センサー基板のプルアップ抵抗 R1（10kΩ）が PCBA の BOM/CPL から除外されており、リセット端子（NRESET）がフローティング（不定）になる
2026-10-19 mv trackball hole
2026-10-19 fix ai 誤認
2026-10-19 rm trackball pcb
2026-10-20 fix 4. トラックボールカップ & 光学系仕様 (Trackball & Optics)
2026-10-20 4.5 トラックボールカップ 4箇所ねじ止め・スペーサー締結仕様
2026-10-20 4. トラックボールカップ & 光学系詳細仕様 (Trackball & Optics)
2026-10-20 爪の球形突起部分
2026-10-21 3. 外周ポート・開口部仕様 (Cutouts & Ports)
2026-10-21 trrs / usb 調整
2026-10-21 fix right pcb
2026-10-21 fix はんだ
2026-10-21 シルク文字
2026-10-21 docs: update case_spec.md with unified M2 mounting hole coordinates and top plate specs
2026-10-21 feat(plates): update FR-4 top/bottom plates and SVGs with new M2 mounting hole coordinates
2026-10-21 feat(cases): generate 3D-printed bottom tray cases per case_spec.md with new M2 hole coordinates
2026-10-21 feat(assembly): update assembly-full.step and verify zero interference across all 89 solids
2026-10-21 fix(assembly): restore CKW12 rotary encoder 3D models into assembly-full.step
2026-10-21 fix(pcb): eliminate all ERC/DRC/parity warnings and ignored DRC checks on left and right PCBs
2026-10-21 Refactor PCBs and schematics to use genuine KiCad 10.0 standard libraries and isolate PMW3360 VDDPIX
2026-10-22 Unify SW1/rSW1 to 1u Choc footprint and document curcur40 component specs and sourcing in pcb_spec.md
2026-10-22 Document custom library data origins and local modifications in pcb_spec.md
2026-10-22 Fix global pad_to_mask_clearance to 0mm, remove footprint solder_mask_margin overrides, and fix custom 3D model paths
2026-10-22 1. 実施内容のまとめ
    ①・② 右手 PCB (curcur40-right) の JP1 直結化 ＆ R4 / C5 の DNP 化
    JP1（電圧選択ジャンパ）の基板内パターン直結化:
    curcur40-right.kicad_sch および curcur40-right.kicad_pcb の JP1 を、KiCad 10.0 標準のブリッジ済みシンボル・フットプリント（Jumper:SolderJumper_3_Bridged12 / Jumper:SolderJumper-3_P1.3mm_Bridged12_RoundedPad1.0x1.5mm_NumberLabels）に変更しました。
    (net_tie_pad_groups "1, 2") と B.Cu 銅箔ポリゴンにより、Pad 1 (+3V3R) – Pad 2 (/V_{IO}) 間が最初から銅箔パターンで直結され、組み立て時のブリッジ忘れや逆ブリッジ（Pad 2–3 短絡）が物理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
2026-10-22 fix(pcb): resolve all ERC off-grid/four-way-junction warnings and restore PCB symbol UUID paths
2026-10-22 feat(mech): align left thumb mounting hole L5 (-21.5250, 63.6875) symmetrically with right TB4
2026-10-22 fix(firmware): separate CKW12 push switch [4,6] from encoder e1 in VIA JSON and fix Makefile .PHONY
2026-10-22 fix(pcb): update spacer holes to 3.25mm, shift SMDSW1/2, remove 0.4mm NPTH hole, and sync U1/CKW12 attributes
2026-10-22 fix(cad): update Z-stackup, 6mm cup standoffs, cup ear/plate clearances, ceramic ball throat, and sensor/CKW12 models
2026-10-22 fix(pcb,cad): restore CKW12 3D model rotation to original 90 deg orientation
2026-10-22 feat(pcb): separate pmw3360 sensor PCB with JST SH 6-pin connector and add symmetric thumb mounting holes L5/R5
2026-10-22 feat(cad): lower trackball cup flush with top plate and add built-in tenting bottom cases
2026-10-22 docs: update specifications, build guide, and 3D previews for low-profile sunk trackball and tented case
2026-10-23 feat(pcb,plates): face-to-face JST SH orientation, move TRRS jack north, and refine mounting holes
2026-10-23 feat(cad): unify 2.40mm case screw floor with deep counterbores, lower pinky edge to 10.50mm, and remove cup relief notch
2026-10-23 docs: update specs, diagrams, and 3D previews for refined connector, TRRS, and case fastener layout
2026-10-23 feat(plates): align right top plate trackball cutout edge (x=24.20mm) with right main PCB
2026-10-23 feat(cad): adopt tilted interior floor with cylindrical screw bosses, unify 14x 5.5mm standoffs, and add assembly-full-desk.step
2026-10-23 docs: update specifications, diagrams, and previews for boss-pillar tilted floor case and desk-level assembly
2026-10-23 feat(pcb): update all 14 spacer through-holes across main and sensor PCBs to 3.30mm
2026-10-23 feat(cad): adopt 5.5mm stepped trackball cup ears and Z=-17.6mm sensor PCB sandwich bosses
2026-10-23 docs: update specifications, diagrams, and 3D previews for 5.5mm stepped cup ears and 3.3mm PCB spacer holes
2026-10-23 feat(pcb): shift rJ3 east to (46.5, 63.0) for rSW1 socket clearance and align N-S pin order with J1
2026-10-23 feat(cad): add 4 wall-mounted PCB support ledges (Z=-5.8mm) and export desk-horizontal case STEP/STL models
2026-10-23 docs: update specifications, build guide, and 3D previews for rJ3 shift, straight cable pinout, wall ledges, and desk-horizontal cases
2026-10-23 feat(cad): align USB-C (Z=-7.35) and TRRS (Z=-7.85) port cutouts with connector centers to hide Top Plate from outside
2026-10-23 fix(cad): align USB-C (12.0x6.2mm) and TRRS (Ø6.8mm) cutouts with mid-mount connector center Z=-5.85mm
2026-10-23 docs: update port cutout specs and diagrams for mid-mount connector center Z=-5.85mm
2026-10-23 feat(cad): include mid-mount USB-C and TRRS 3D models in full assembly STEP and verify zero overlap
2026-10-23 docs: unify all specs, build guide, and README with separated sensor PCB and 14x 5.50mm standoffs
2026-10-23 fix(pmw3360): move R2 away from TB2 mounting hole to prevent case boss interference
2026-10-23 docs: clarify JST-SH 6-pin cable pinout (1-6 same-side) and sync pcb_spec & script comments
2026-10-23 docs(assets): update specification diagrams and PMW3360 assembly SVG to match final implementation
2026-10-23 fix(pmw3360): shift J1 1.0mm West and C3 0.5mm East to increase case floor & boss clearances
2026-10-23 docs,scripts: render full assembly previews from assembly-full-desk.step
2026-10-23 chore(cad): update cadgen version pin from 0.7.21 to 0.7.26
2026-10-24 fix(bom,pcb): update JST SH 6-pin connector LCSC part number from C160404 to C160405
2026-10-24 docs(buildguide): add JLCPCB DFM manual alignment notes for mid-mount USB-C and TRRS connectors
2026-10-24 fix(plates): unify left top plate outer contour winding to clockwise and fix SVG fillet arc sweep
2026-10-24 fix(pcb): resolve 0.060mm same-net +3V3 trace spacing at U1 top-left and LED1.4 slot on left PCB
2026-10-24 fix(cad): eliminate case micro-gaps (pinky ledge floor & R4/L4 boss-wall) and thicken PCB support ledge tips to 0.85mm
2026-10-24 feat(cad): bridge R5/L5, TB1, TB3, and TB4 bosses into adjacent inner walls
2026-10-24 feat(scripts,docs): add automated micro-gap & <0.8mm wall-thickness checks to CAD generators and AGENTS.md
2026-10-24 refactor(cases): separate verification assembly models into cases/assemblies/
2026-10-24 feat(scripts,docs): add JLCPCB & JLC3DP official pre-order checks to CAD and PCB exporters
2026-10-25 docs(spec): update pcb_spec and case_spec for split USB-C replacement
2026-10-25 feat(pcb): replace split TRRS jack with USB-C receptacle and ESD/series protection
2026-10-25 feat(cad): replace inner-wall TRRS hole with split USB-C cutout in cases and full assembly
2026-10-25 docs(inertia-wheel): add unified Phase 1 spec, BOM, and architecture diagram for passive magnetic inertia wheel
2026-10-25 feat(cad): add SUS304 flywheel, SLA carriage/base/hub, and verified STEP assemblies
2026-10-25 feat(pcb): add AS5600 sensor sub-PCB, RP2040-Zero eval carrier PCB, and JLCPCB production files
2026-10-25 feat(firmware,docs): add RP2040-Zero AS5600 QMK firmware and sync spec with final CAD/PCB
2026-10-25 feat(cad): add low-profile sunk inertia wheel base frame and curcur40-right sunk assembly
2026-10-25 docs(buildguide): add standalone inertia wheel evaluation pod build guide
2026-10-25 docs(inertia-wheel): document commercial/OSS track record and low-profile sunk variant
2026-10-26 feat(cad): add optional mouse-style shroud covers (#20A/#20B) and covered assemblies
2026-10-26 docs(inertia-wheel): document #20A/#20B shroud cover option and covered previews
2026-10-26 feat(cad,firmware): replace external shrouds with cup-shaped SUS304 flywheel, internal 9-ball hub, and slim carriage
2026-10-26 docs(inertia-wheel): update spec, build guide, and visual parts guide for cup-flywheel architecture
2026-10-26 feat(pcb,cad): upgrade curcur40-wheel-sensor to 22x22mm breakaway frame for single-sided JLCPCB Economic PCBA
2026-10-26 docs(inertia-wheel): update build guide, spec, and visual parts guide for PCBA-assembled sensor board
2026-10-26 feat(pcb): trim wheel-sensor upper outline for pyramid cover and align eval SW1
2026-10-26 feat(cad): adopt centered Pattern 5 wheel and twin pyramid-deep-R snap covers
2026-10-26 docs(wheel): update specs, buildguide, and renders for twin pyramid-deep-R covers
2026-10-26 docs(wheel): restructure spec into core module, eval board, and sunk keyboard mount
2026-10-26 chore(wheel): remove obsolete keyboard on-PCB comparison models and renders
2026-10-26 feat(pcb): integrate sunk inertia wheel cutout and rJ5 connector into curcur40-right and top plate
2026-10-26 feat(firmware): integrate AS5600 magnetic inertia wheel with PMW3360 composite pointing driver
2026-10-26 feat(cad): integrate sunk passive inertia wheel and twin covers into full keyboard assemblies
2026-10-26 docs(assets): regenerate all 3D previews and specification diagrams with sunk inertia wheel
2026-10-26 docs: update all specs, build guides, README, and AGENTS rules for completed inertia wheel integration
2026-10-27 fix(wheel): keep twin covers inside wheel silhouette, locate snap legs at +-0.10 mm, and clear the full click stroke
    - Cover side silhouette now stays >= 0.30 mm (0.48 mm) inside the 16.80 mm wheel outline viewed along the axle
    - Snap legs (1.34 mm) located by 1.54 mm plate windows (+-0.10 mm play); wheel gap 0.20 -> 0.40 mm (>= 0.30 mm worst case)
    - Cover voids sized from the carriage click stroke (0 -> 2.34 deg striker bottom-out), mirrored for the companion cover
    - Plate opening: wheel slot 18.16 mm, AS5600 PCB swing windows, relocated snap windows (36-vertex outline)
    - New automated checks: cover silhouette, plate opening hidden under covers, click-swing clearance sweep
2026-10-27 docs: document cover silhouette, +-0.10 mm snap-leg location, click-swing clearance and regenerate renders/diagrams
2026-10-27 fix(wheel): apply H=4.3mm Kailh switch datasheet dims, widen snap legs to 1.80 mm, and eliminate <0.80 mm plate teeth
2026-10-27 docs: sync H=4.3mm switch spec, 1.80 mm snap legs, and regenerate diagrams/renders
2026-10-27 fix(wheel): model #10 switch THT pins (5.00 mm pitch) and add matching Ø2.00 mm pin holes in #04B sunk frame
2026-10-27 feat(wheel): unify W1-W3 sunk wheel mount to M2 5.50mm standoffs and top/bottom M2x4mm screws
2026-10-27 docs: document unified 17-point M2 5.50mm standoff + top/bottom screw fastening and regenerate diagrams
2026-10-30 Tune inertia wheel CAD & assemblies for finalized off-the-shelf parts (DDL-520 1.5mm, D4x1mm, SUS303 2x10/16mm, NE218, DIN916 M2x4mm)
2026-10-30 Sync inertia wheel diagrams, 3D previews, and docs with finalized BOM parts
2026-10-30 fix(pcb): resolve audit issues on wheel-eval, wheel-sensor, and kbd footprints
2026-10-31 fix(cad): resolve inertia wheel mechanical & eval pod audit findings
2026-10-31 fix(firmware): harden AS5600 I2C0 polling rate-limit, timeout & bus recovery
2026-10-31 docs: sync inertia wheel diagrams, 3D previews, and specs with audit fixes
2026-10-31 docs(bom): update inner-race shim spec to BRS002003020 + BRS002003030
2026-10-31 refactor(pcb): integrate TMAG5273 and silent middle-click on curcur40-right and remove sub-PCBs
2026-10-31 refactor(cad): redesign under-plate integral wheel and sealed heat-set insert cases
2026-10-31 feat(firmware): replace AS5600 with TMAG5273/TLV493D 3D Hall driver at 24 notches/rev
2026-10-31 docs: update specs, BOM, build guide, and renders for integral under-plate wheel and heat-set cases
2026-10-31 feat(pcb,plates): add stepped-boss top-plate clamping holes and widen wheel cutout to 6.50mm
2026-10-31 feat(cad): widen steel flywheel to 6.50mm, add stepped plate bosses, C-clip/trunnion/keeper locks & 6-DOF checks
2026-10-31 docs,assets: add kid-friendly mechanism guide, #01-#12 spec callouts, and sync 6.50mm/stepped-boss specs
2026-10-31 feat(pcb,plates): widen stepped-boss cutouts to 6.20mm, align 6.50mm wheel with rEXSW2, and clear USB-C/switch pads
2026-10-31 feat(cad): upgrade stepped bosses to 6.0/7.84mm, flatten L4/R4, remove wall ledges, center wheel on rEXSW2, and add C-clip seesaw hinge
2026-10-31 docs,assets: add interactive wheel_mechanism_guide.html and sync wide-boss/aligned-wheel/C-clip specs
2026-10-31 feat(pcb,plates): switch to 1A perimeter holes, move L4/R4 to (±100.50, 21.50), add rEXSW1 STEP model & sync foam/Gerbers
2026-10-31 feat(cad): switch perimeter bosses to flat Ø5.20mm at Z=-5.80, step cradle for rR1 & sync real KiCad 3D STEP models
2026-10-31 docs: sync specs, diagrams, 3D previews & build guide with 1A flat bosses, L4/R4 (±100.50, 21.50) & KiCad STEP sync
2026-11-01 chore(rules,qa): enforce 3D STEP sync & strict no-dummy-model NG reporting on PCB changes
2026-11-01 Update Main PCBs, Top Plates, Switch Foam, and JLCPCB Gerbers to 6-point valley screw layout
2026-11-01 Update 3D Cases with 12 valley bosses and USB-C support shelves and sync Full Assembly STEPs
2026-11-01 Regenerate specification diagrams and 3D preview renders for 6-point valley screw layout
2026-11-01 Sync all specifications, build guide, README, and AGENTS.md to 19-insert valley layout and USB-C support shelves
2026-11-01 Add JST SHR-06V-S-B 3D housings to assembly STEPs and verify mating clearance
2026-11-01 Add local 1.40mm-wall J1 JST-SH relief pocket to Right Case and verify zero collision
2026-11-01 Sync docs and 3D renders for Right Case J1 relief pocket and SHR-06V-S-B models
2026-11-02 fix(pcb): add M2 screw-head & insert copper keepouts and reroute nearby traces
2026-11-02 fix(firmware,docs): remove leftover ENCODER_MAP_ENABLE in via keymap and clarify OS Shift horizontal scroll
2026-11-02 docs: unify Choc V2 & 100mm JST-SH specs, fix rU6 pinout, and add DFU/DFM & tool clearance guide
2026-11-02 fix(cad,pcb): align Choc V2 switch/keycap 3D proxy, sync Red Dot footprint descr, and update assembly STEPs
2026-11-02 docs(video): add 1080p 60fps PBR 3D assembly animation video and generator script
2026-11-03 perf(cad): share canonical STEP TShapes for switches, keycaps, and fasteners
2026-11-03 docs(buildguide): embed inline animated WebP assembly preview linked to 1080p MP4
2026-11-03 docs(case_spec): add snap-in PA12 carrying frame specification
2026-11-03 feat(cad): add snap-in PA12 carrying frame and packed assembly verification
2026-11-03 docs: add carrying frame previews, BOM entry, and usage guide
2026-11-04 feat(cad): open all 4 USB-C ports for CIO magnetic tips and add dual paddle latches
2026-11-04 docs: sync carrying frame previews and guide for open USB-C magnetic tips
2026-11-04 feat(case): add Concept B slide-in carrying box and convertible flush snap lid
2026-11-04 feat(case): update Concept B carrying box to snap-lid cuboid with internal USB moats and backstops
2026-11-04 feat(case): make Concept B carrying box & lid upside-down reversible and engineer 26-deg long-beam snap latch
2026-11-05 Consolidate carrying box + snap lid as official design and remove open frame option
