oktntko/curcur40/(notices)

Notices in the files:
scratch/pmw_tp3_test.kicad_pcb:
Open Source Hardware, CERN-OHL-P v2
